NU-Formula-Racing/BMS-Deprecated-2023/Firmware/PlatformIO/main_mcu/README.md

Link to state machine flow chart: https://lucid.app/lucidchart/a4bc1315-41cd-4296-962c-10b4b0074c76/edit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
