NU-Formula-Racing/BMS-Deprecated-2023/Hardware/QFP50P1200X1200X120-64N_JEDEC_MS-026ACD.STEP

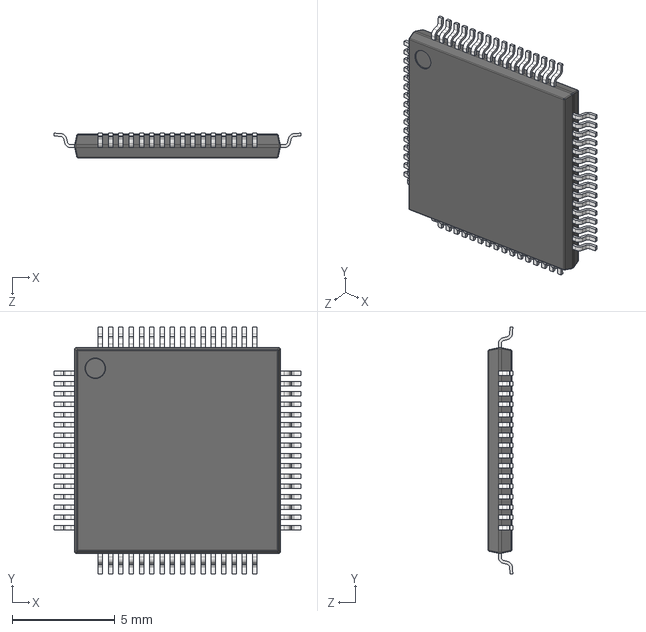
[picture p1: CAD file, 2022-01-15]
Hardware/QFP50P1200X1200X120-64N_JEDEC_MS-026ACD.STEP
12.0 x 12.0 x 1.20 mm
