NU-Formula-Racing/BMS-Deprecated-2023/Hardware/Main controller 79656/esp_teensy_bridge_v3_layouyt.pdf

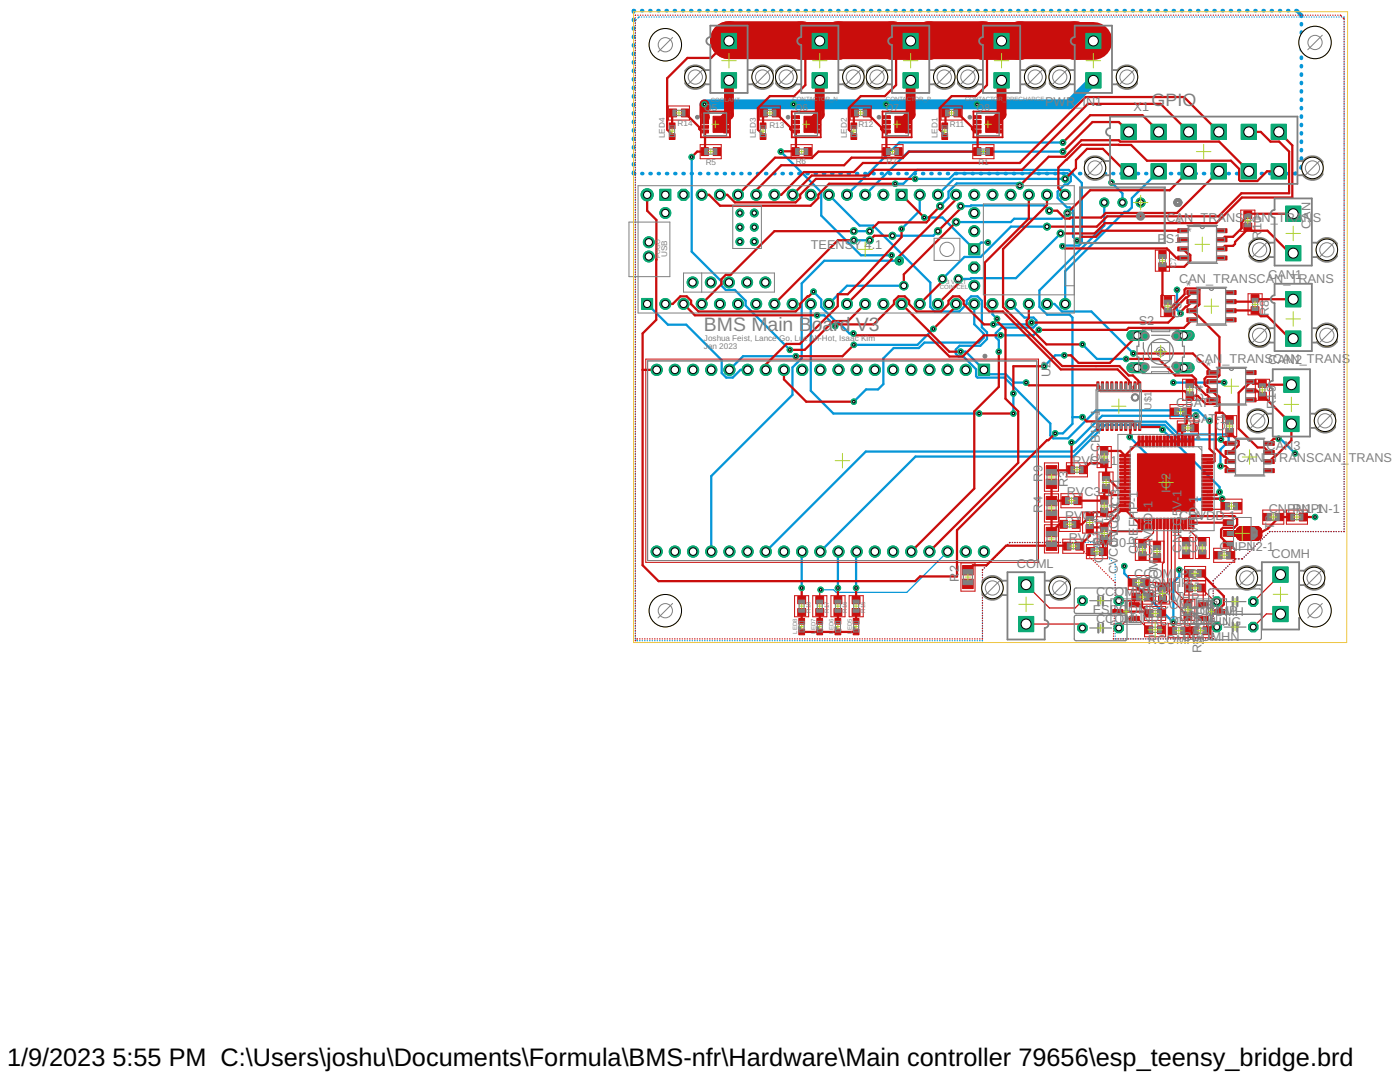
[picture p2: page 1]

3 VOLT COIN CEL POGO

Joshua Feist, Lance Go, Luc Ah-Hot, Isaac Kim
Jan 2023

CREFHP-1 CAVDD-1 CNEG5V-1 CCVDD-1 C VDD-1 CNPN2-1CNPRNN1P-1N-1 T2 RCOMH

1/9/2023 5:55 PM C:\Users\joshu\Documents\Formula\BMS-nfr\Hardware\Main controller 79656\esp_teensy_bridge.brd
