NU-Formula-Racing/BMS-Deprecated-2023/Hardware/Main controller 79656/esp_teensy_bridge_v3_schematic.pdf

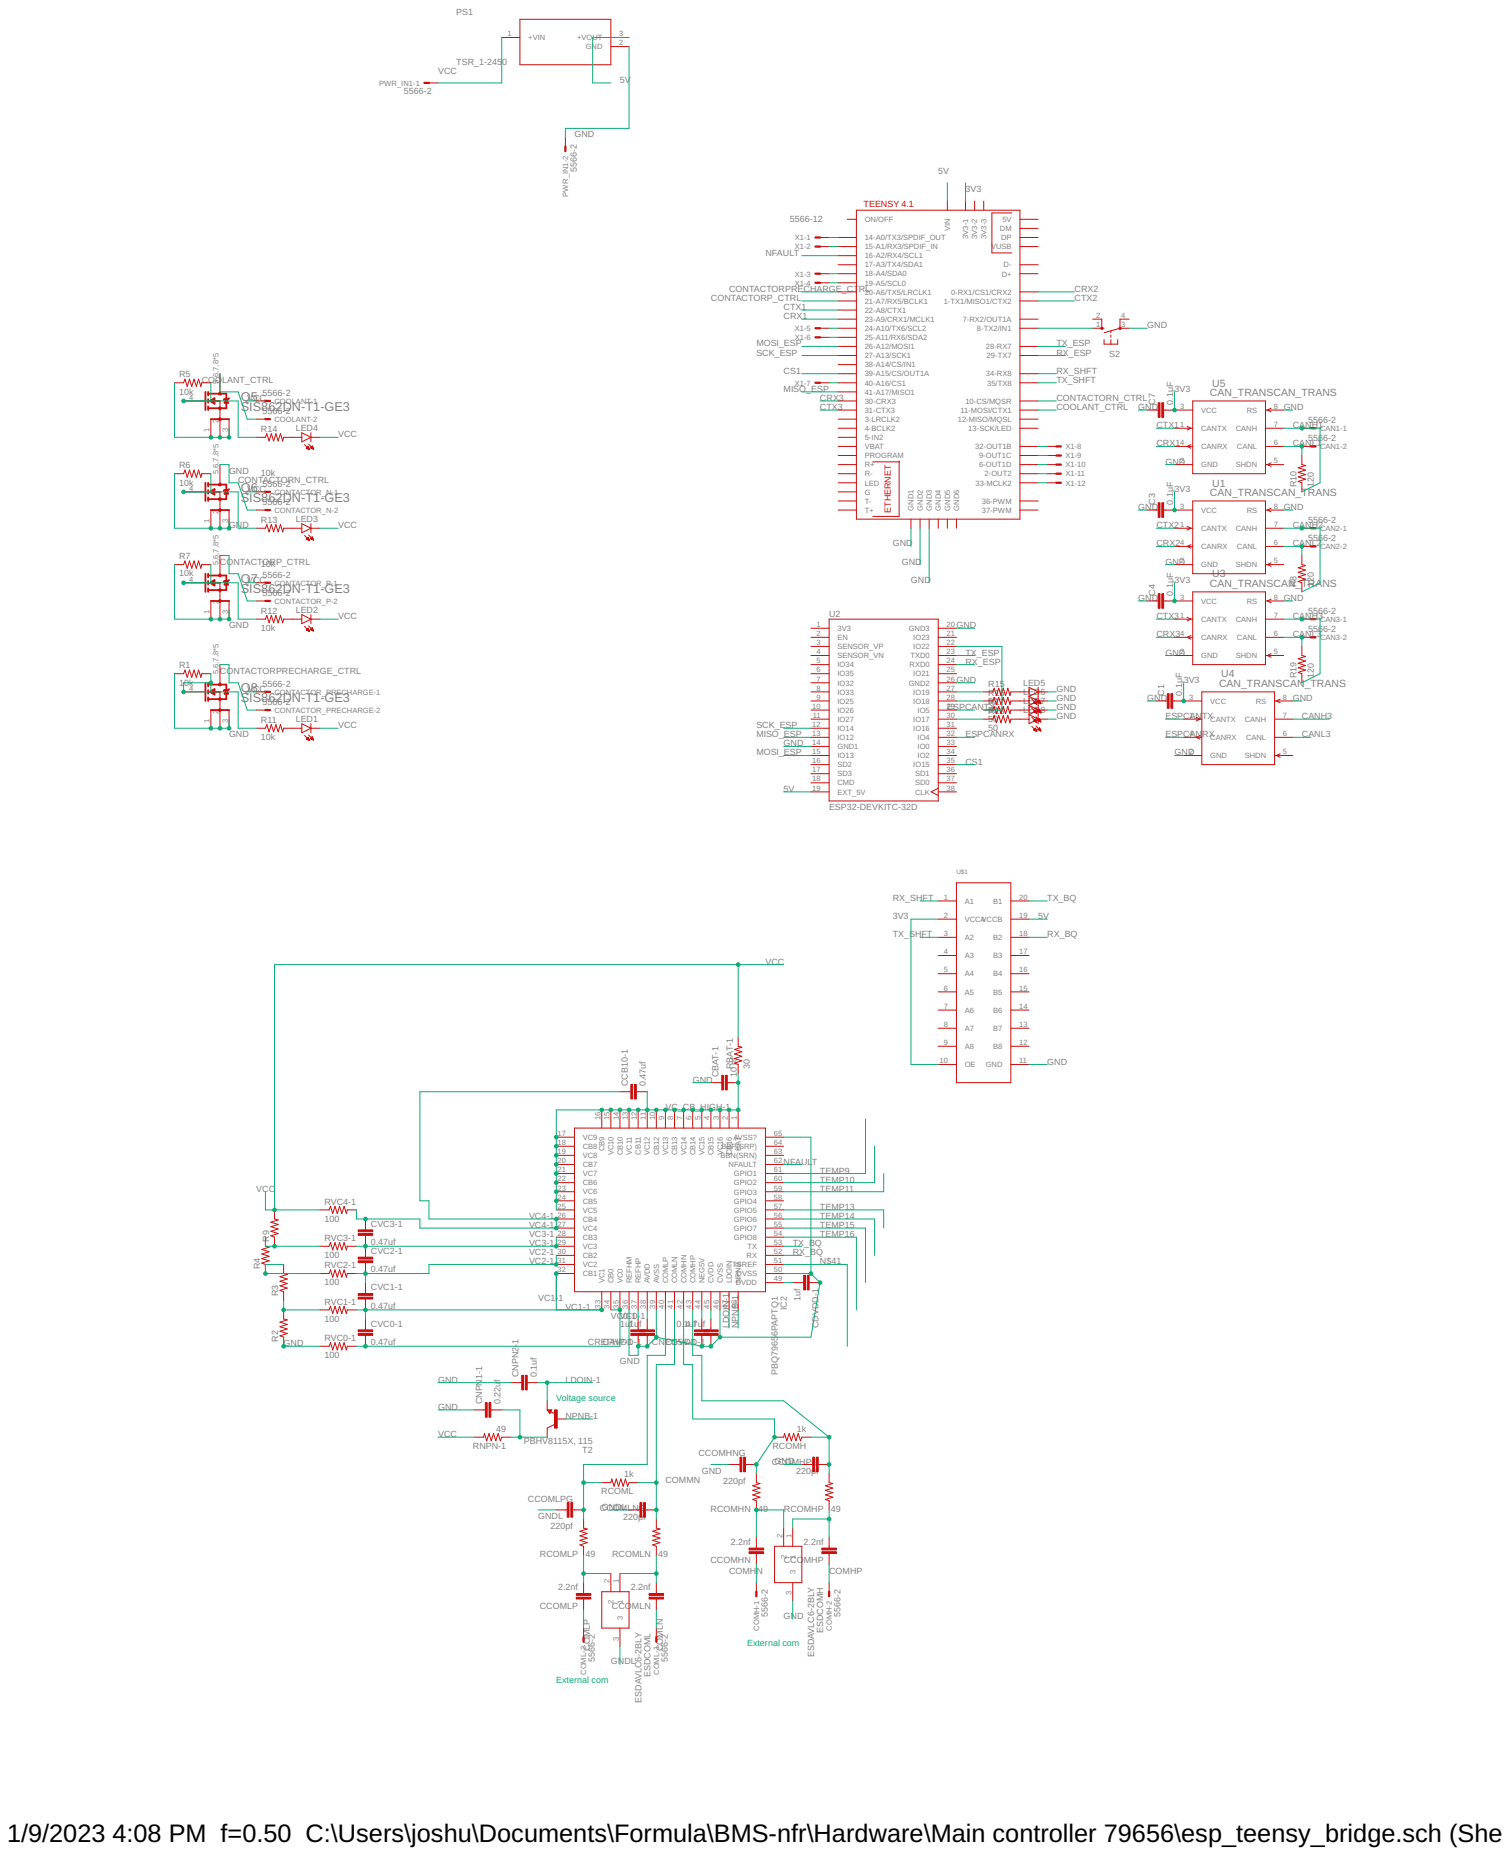
[picture p3: page 1]

GND GND GND GND GND

55 GPIO8 54 TX

1/9/2023 4:08 PM f=0.50 C:\Users\joshu\Documents\Formula\BMS-nfr\Hardware\Main controller 79656\esp_teensy_bridge.sch (Sheet: 1/1)
