NU-Formula-Racing/BMS-Deprecated-2023/Hardware/Segment/daughterboard_layout_v3.pdf

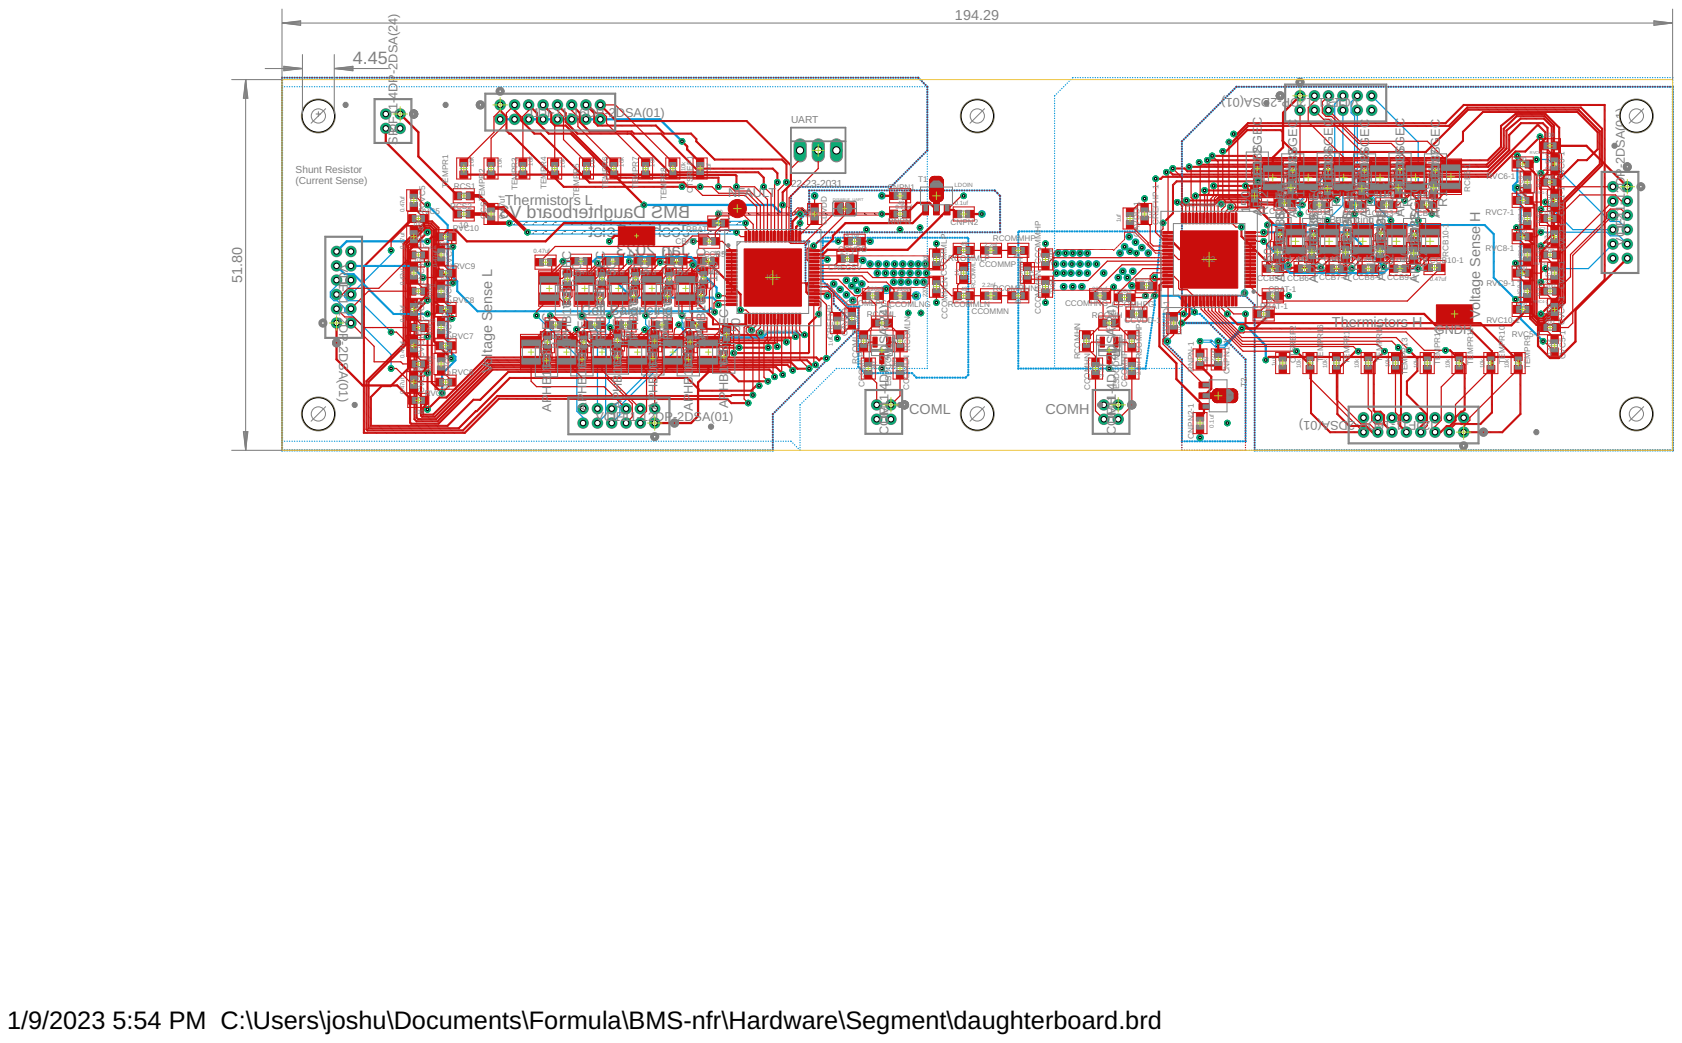
[picture p4: page 1]

1/9/2023 5:54 PM C:\Users\joshu\Documents\Formula\BMS-nfr\Hardware\Segment\daughterboard.brd
