NU-Formula-Racing/BMS-Deprecated-2023/Hardware/Segment/daughterboard_schematic_v3.pdf

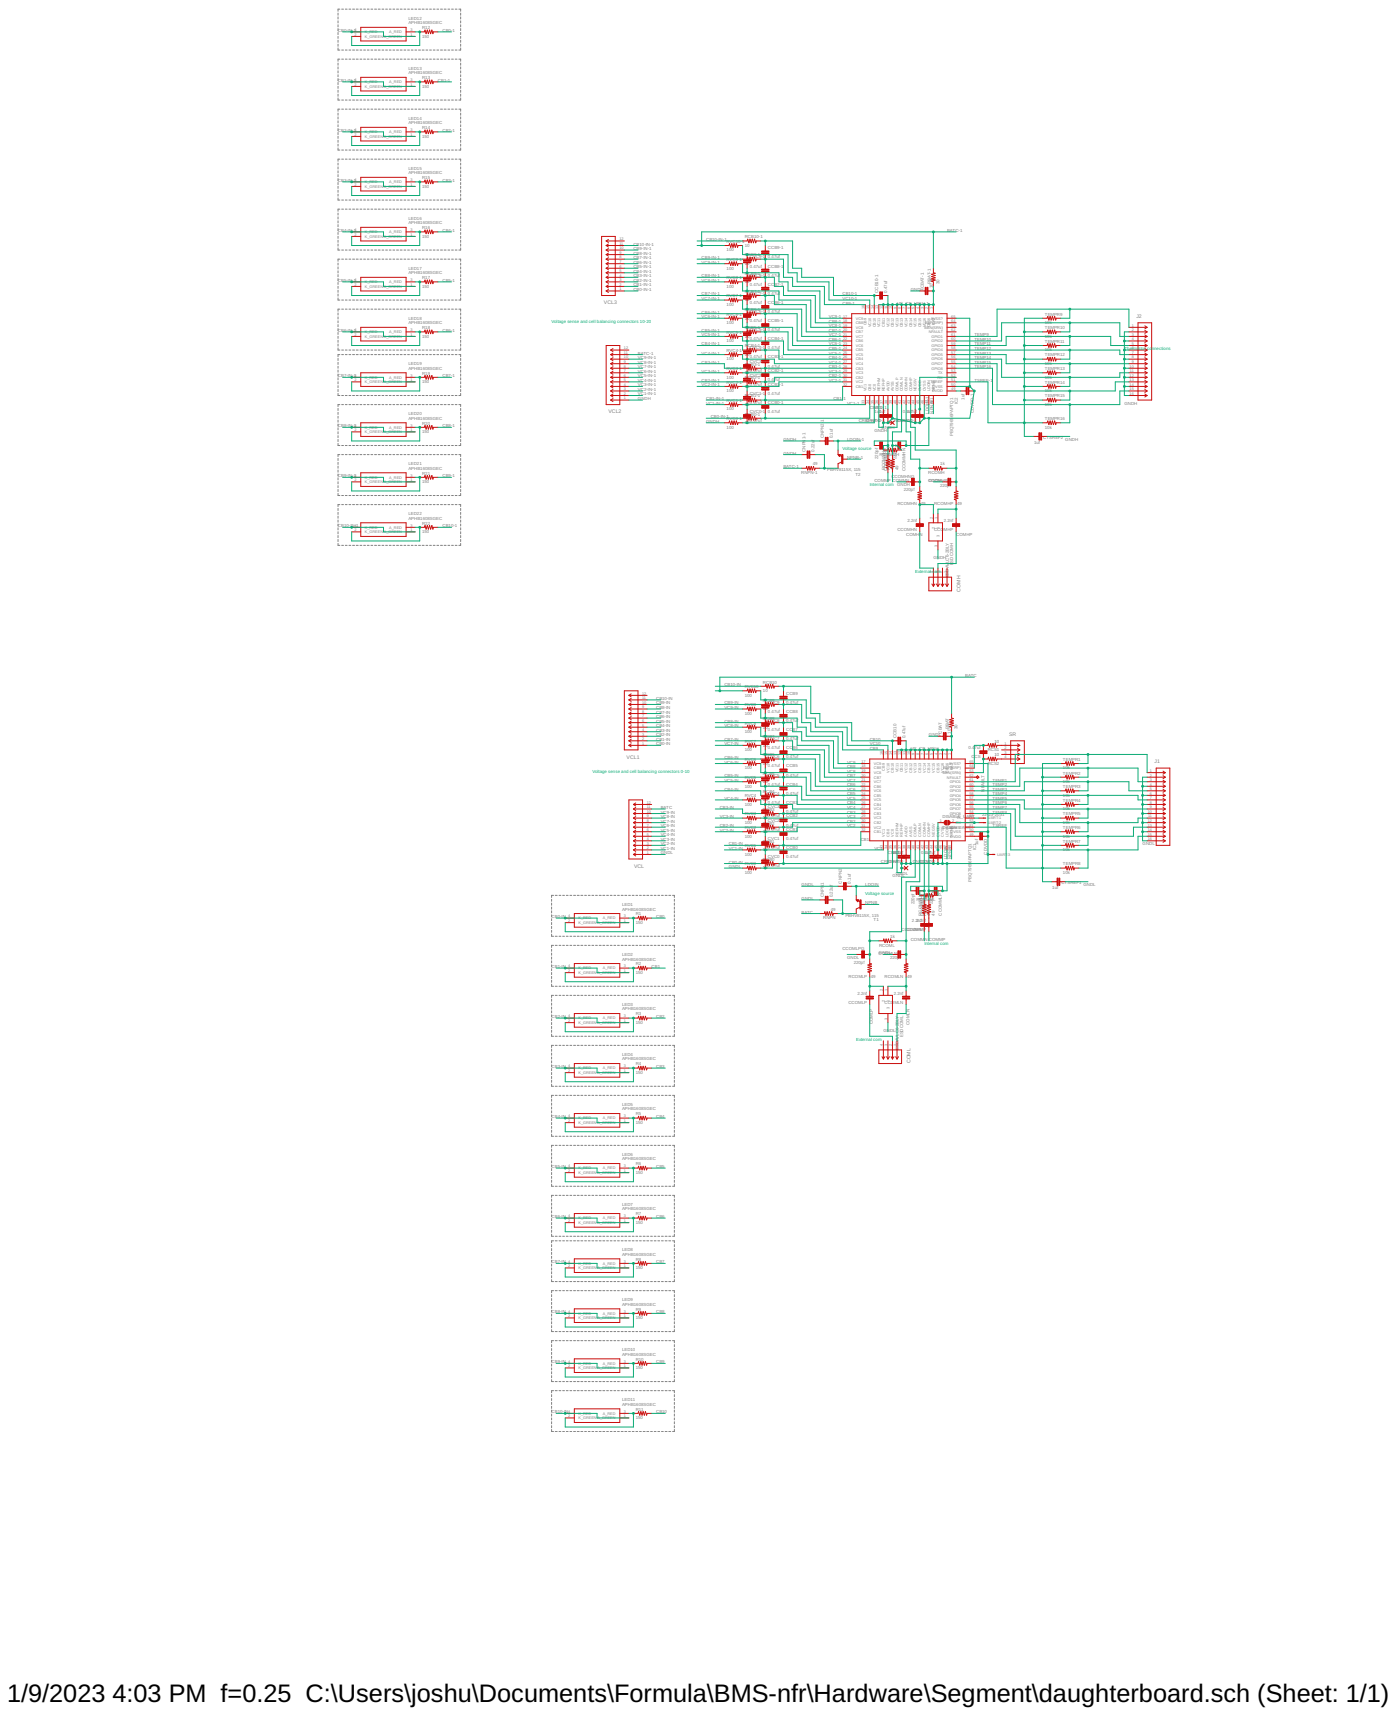
[picture p5: page 1]

Voltage sense and cell balancing connectors 10-20

Voltage sense and cell balancing connectors 0-10

1/9/2023 4:03 PM f=0.25 C:\Users\joshu\Documents\Formula\BMS-nfr\Hardware\Segment\daughterboard.sch (Sheet: 1/1)
