NU-Formula-Racing/BMS-Deprecated-2023/Hardware/Main controller 79600/esp_teensy_bridge_layout-05-2-22.pdf

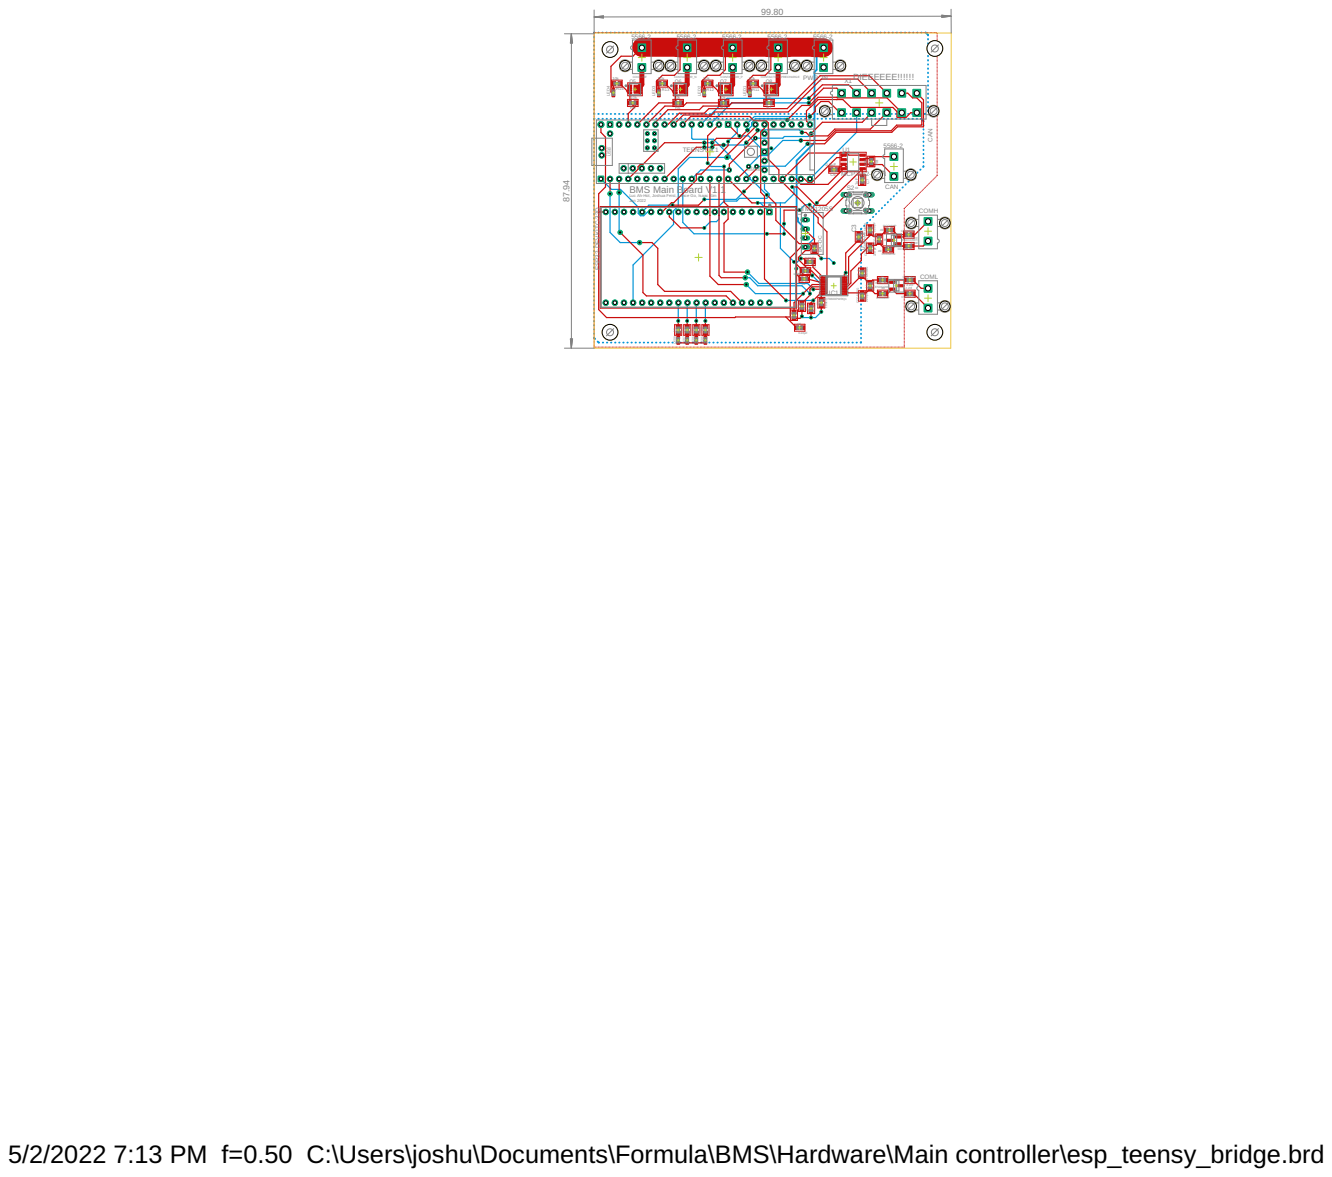
[picture p6: page 1]

3 VOLT COIN CEL POGO

TEENSY | 4.1

TME1205S 100k

5/2/2022 7:13 PM f=0.50 C:\Users\joshu\Documents\Formula\BMS\Hardware\Main controller\esp_teensy_bridge.brd
