NU-Formula-Racing/BMS-Deprecated-2023/Hardware/Segment/daughterboard-layout-4-20-22.pdf

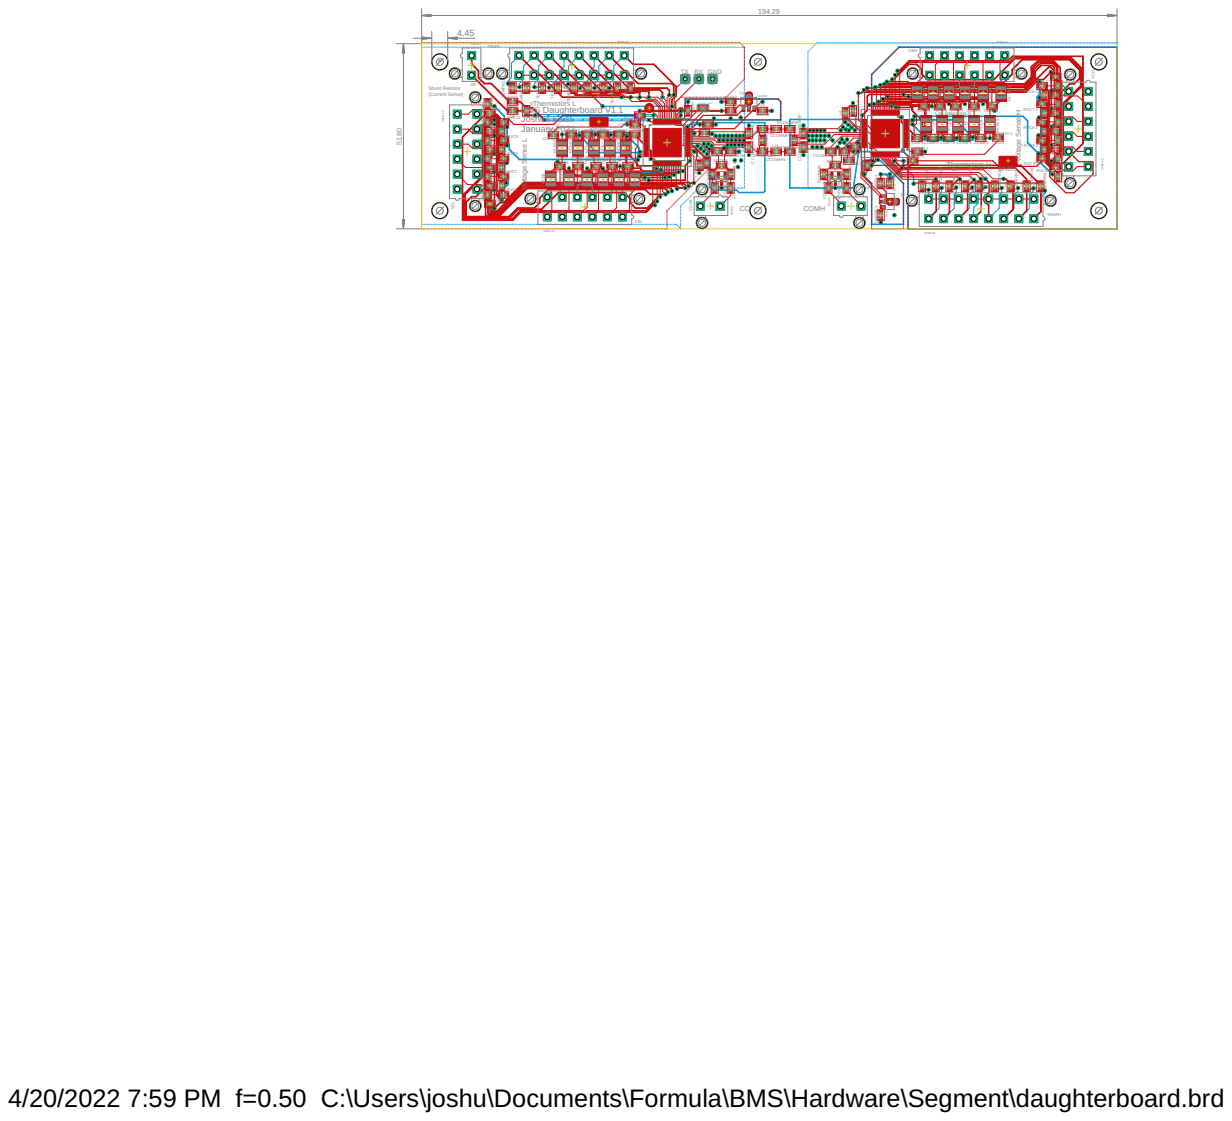
[picture p7: page 1]

Voltage Sense L Cell Balancing L

4/20/2022 7:59 PM f=0.50 C:\Users\joshu\Documents\Formula\BMS\Hardware\Segment\daughterboard.brd
