NU-Formula-Racing/BMS-Deprecated-2023/Hardware/Segment/daughterboard_4-20-22.pdf

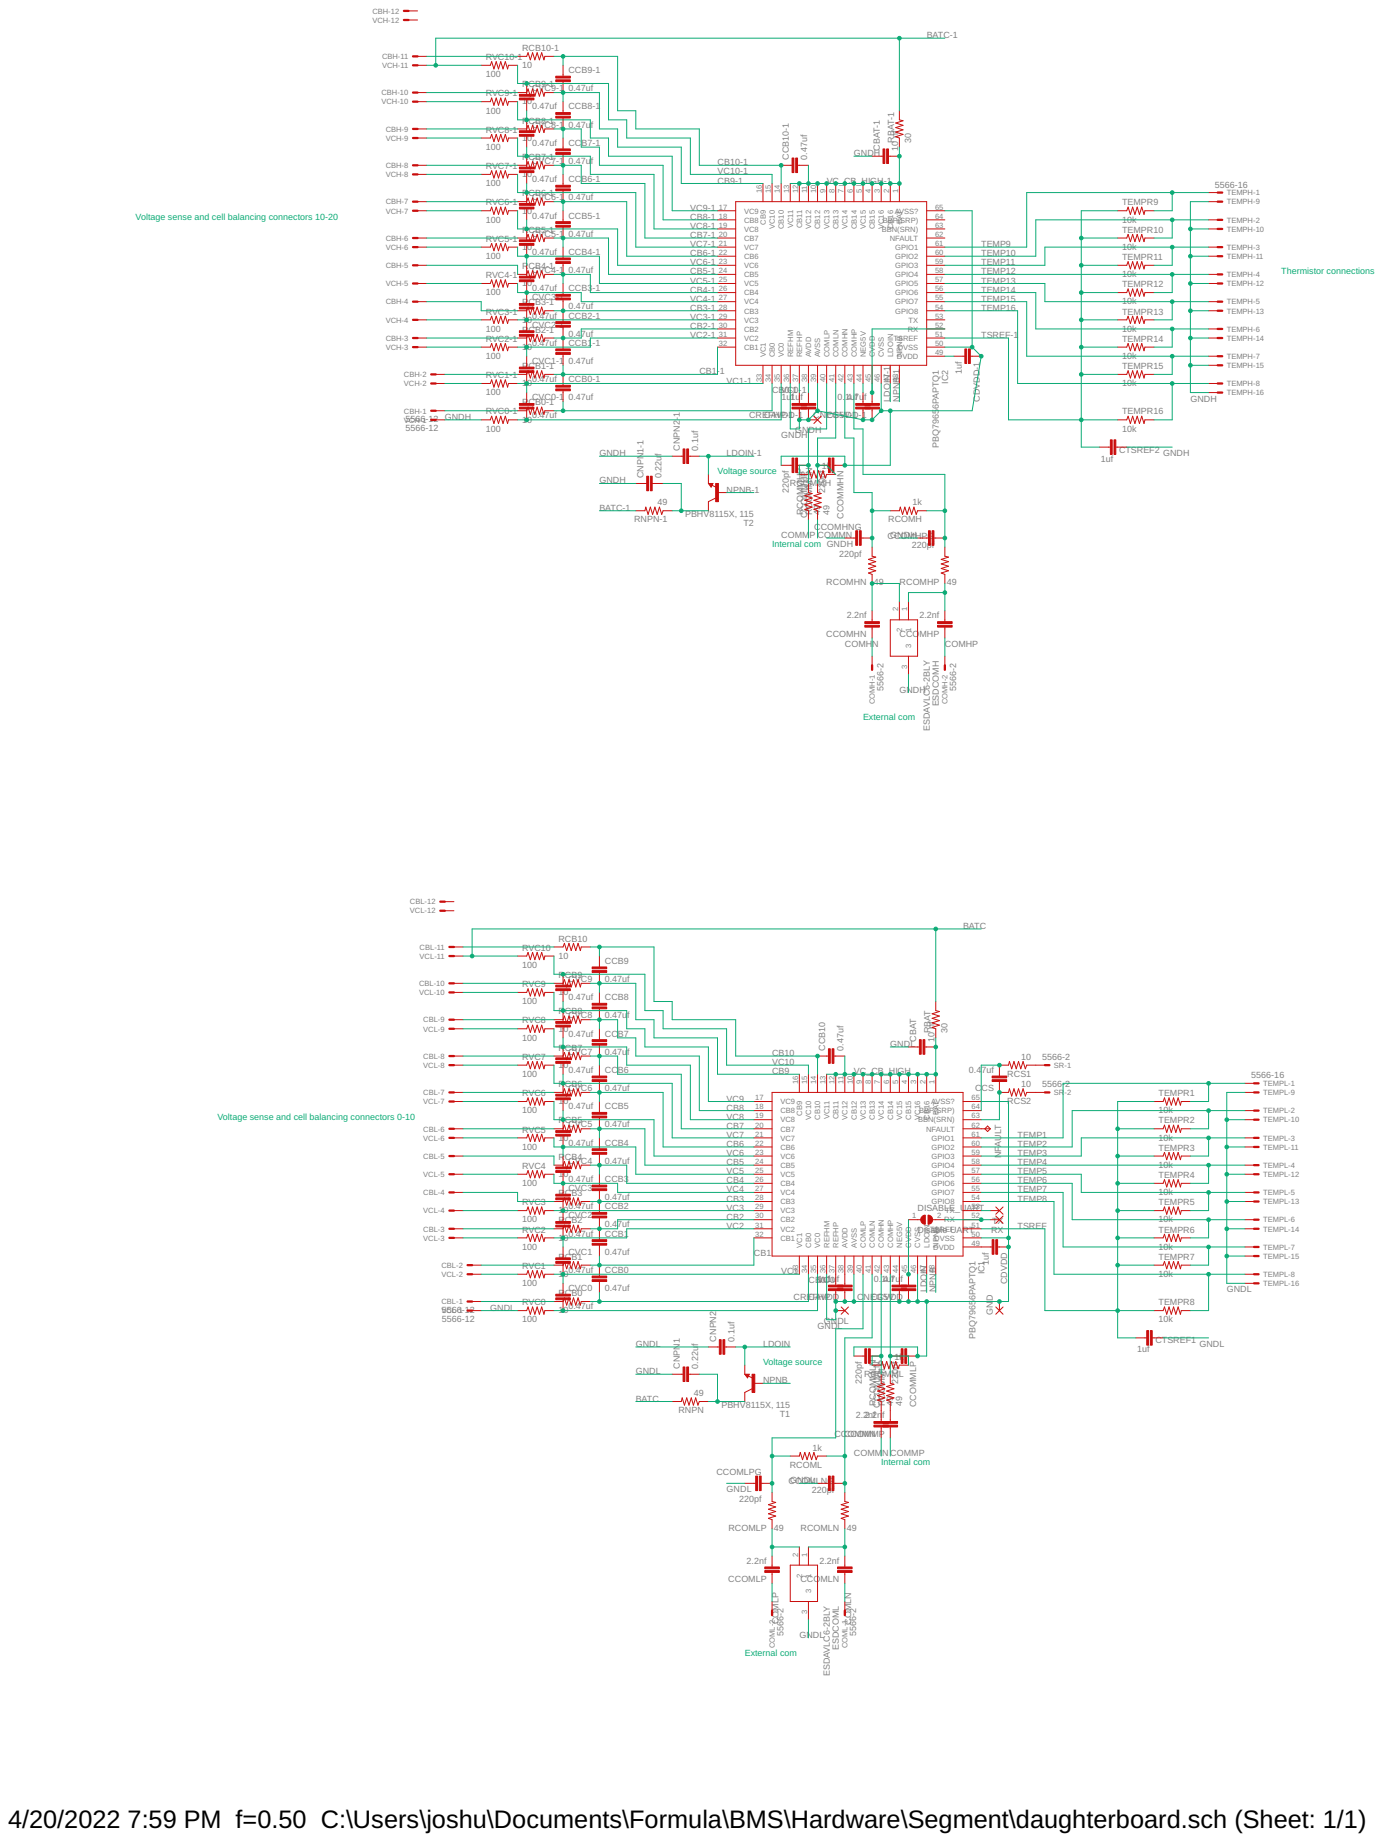
[picture p8: page 1]

CBH-12
VCH-12
VCH-1 VCH-2 VCH-3 VCH-4 VCH-5 VCH-6 VCH-7 VCH-8 VCH-9 VCH-10 VCH-11

TEMPH-1 TEMPH-2 TEMPH-3 TEMPH-4 TEMPH-5 TEMPH-6 TEMPH-7 TEMPH-8
TEMPR15 TEMPR14 TEMPR13 TEMPR12 TEMPR11 TEMPR10 TEMPR9

Voltage sense and cell balancing connectors 10-20

TEMPH-9 TEMPH-10 TEMPH-11 TEMPH-12 TEMPH-13 TEMPH-14 TEMPH-15 TEMPH-16 TEMPR16 CTSREF2

56 GPIO7 55 GPIO8

CBL-12
VCL-12
VCL-1 VCL-2 VCL-3 VCL-4 VCL-5 VCL-6 VCL-7 VCL-8 VCL-9 VCL-10 VCL-11

TEMPL-1 TEMPL-2 TEMPL-3 TEMPL-4 TEMPL-5 TEMPL-6 TEMPL-7 TEMPL-8

TEMPL-9 TEMPL-10 TEMPL-11 TEMPL-12 TEMPL-13 TEMPL-14 TEMPL-15 TEMPL-16 TEMPR8 CTSREF1

Voltage sense and cell balancing connectors 0-10

4/20/2022 7:59 PM f=0.50 C:\Users\joshu\Documents\Formula\BMS\Hardware\Segment\daughterboard.sch (Sheet: 1/1)
