NU-Formula-Racing/BMS-Deprecated-2023/Hardware/Dummy Battery/dummy_battery_brd_1.0.pdf

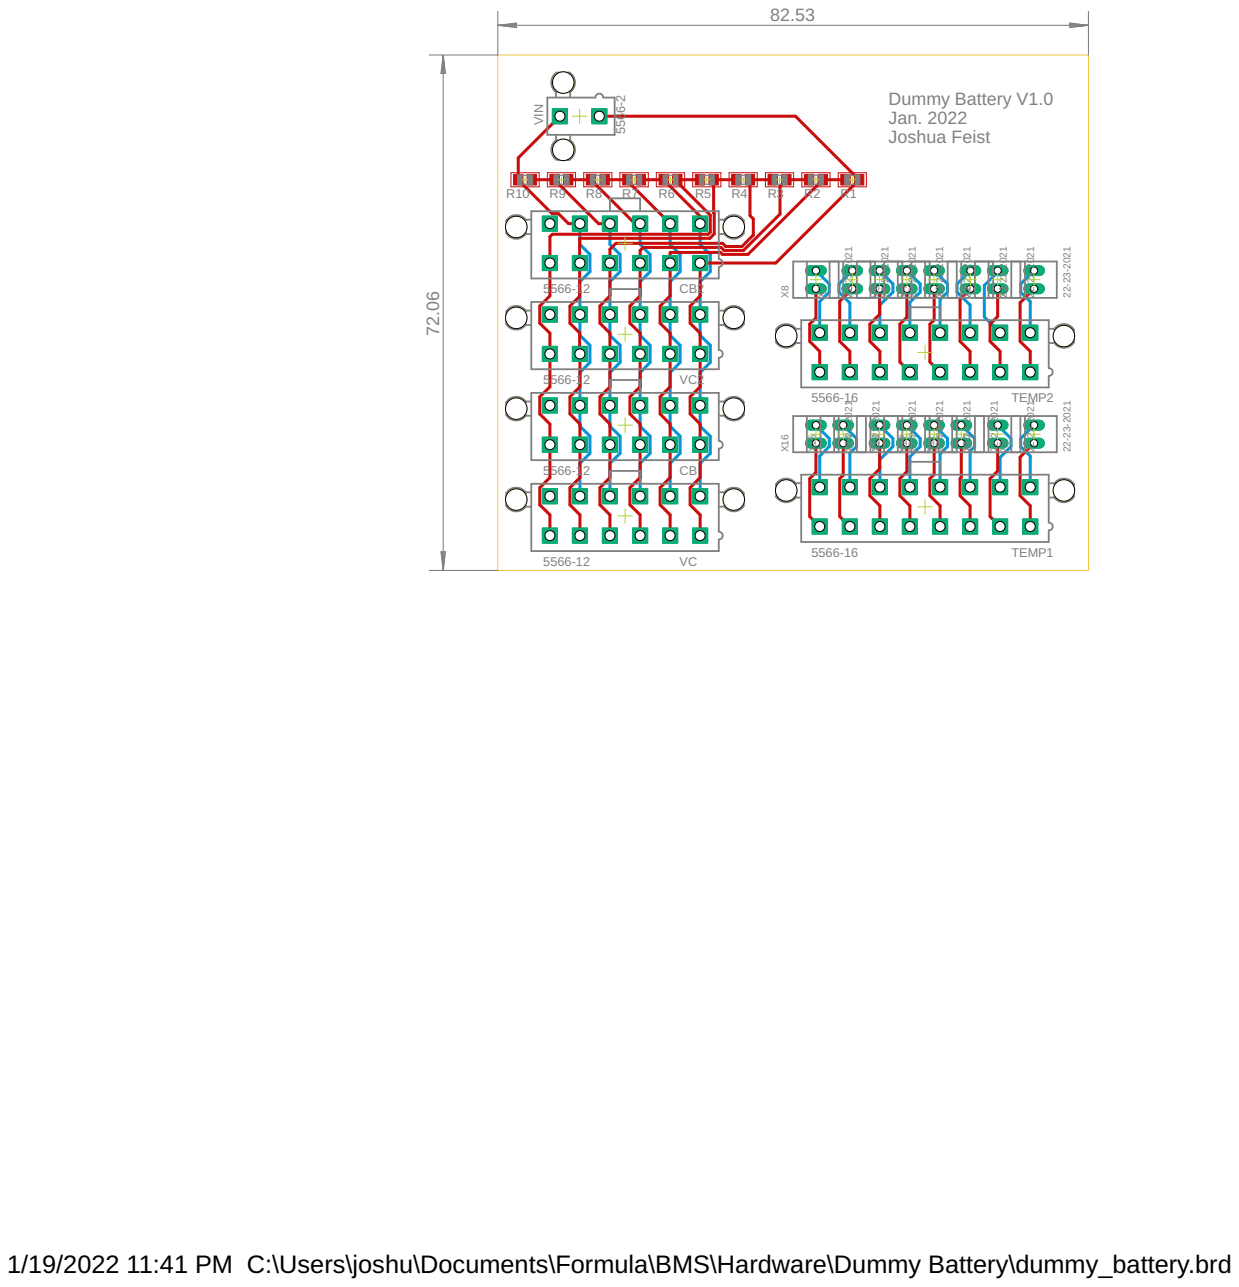
[picture p9: page 1]

1/19/2022 11:41 PM C:\Users\joshu\Documents\Formula\BMS\Hardware\Dummy Battery\dummy_battery.brd
