NU-Formula-Racing/BMS-Deprecated-2023/Hardware/Dummy Battery/dummy_battery_sch_1.0.pdf

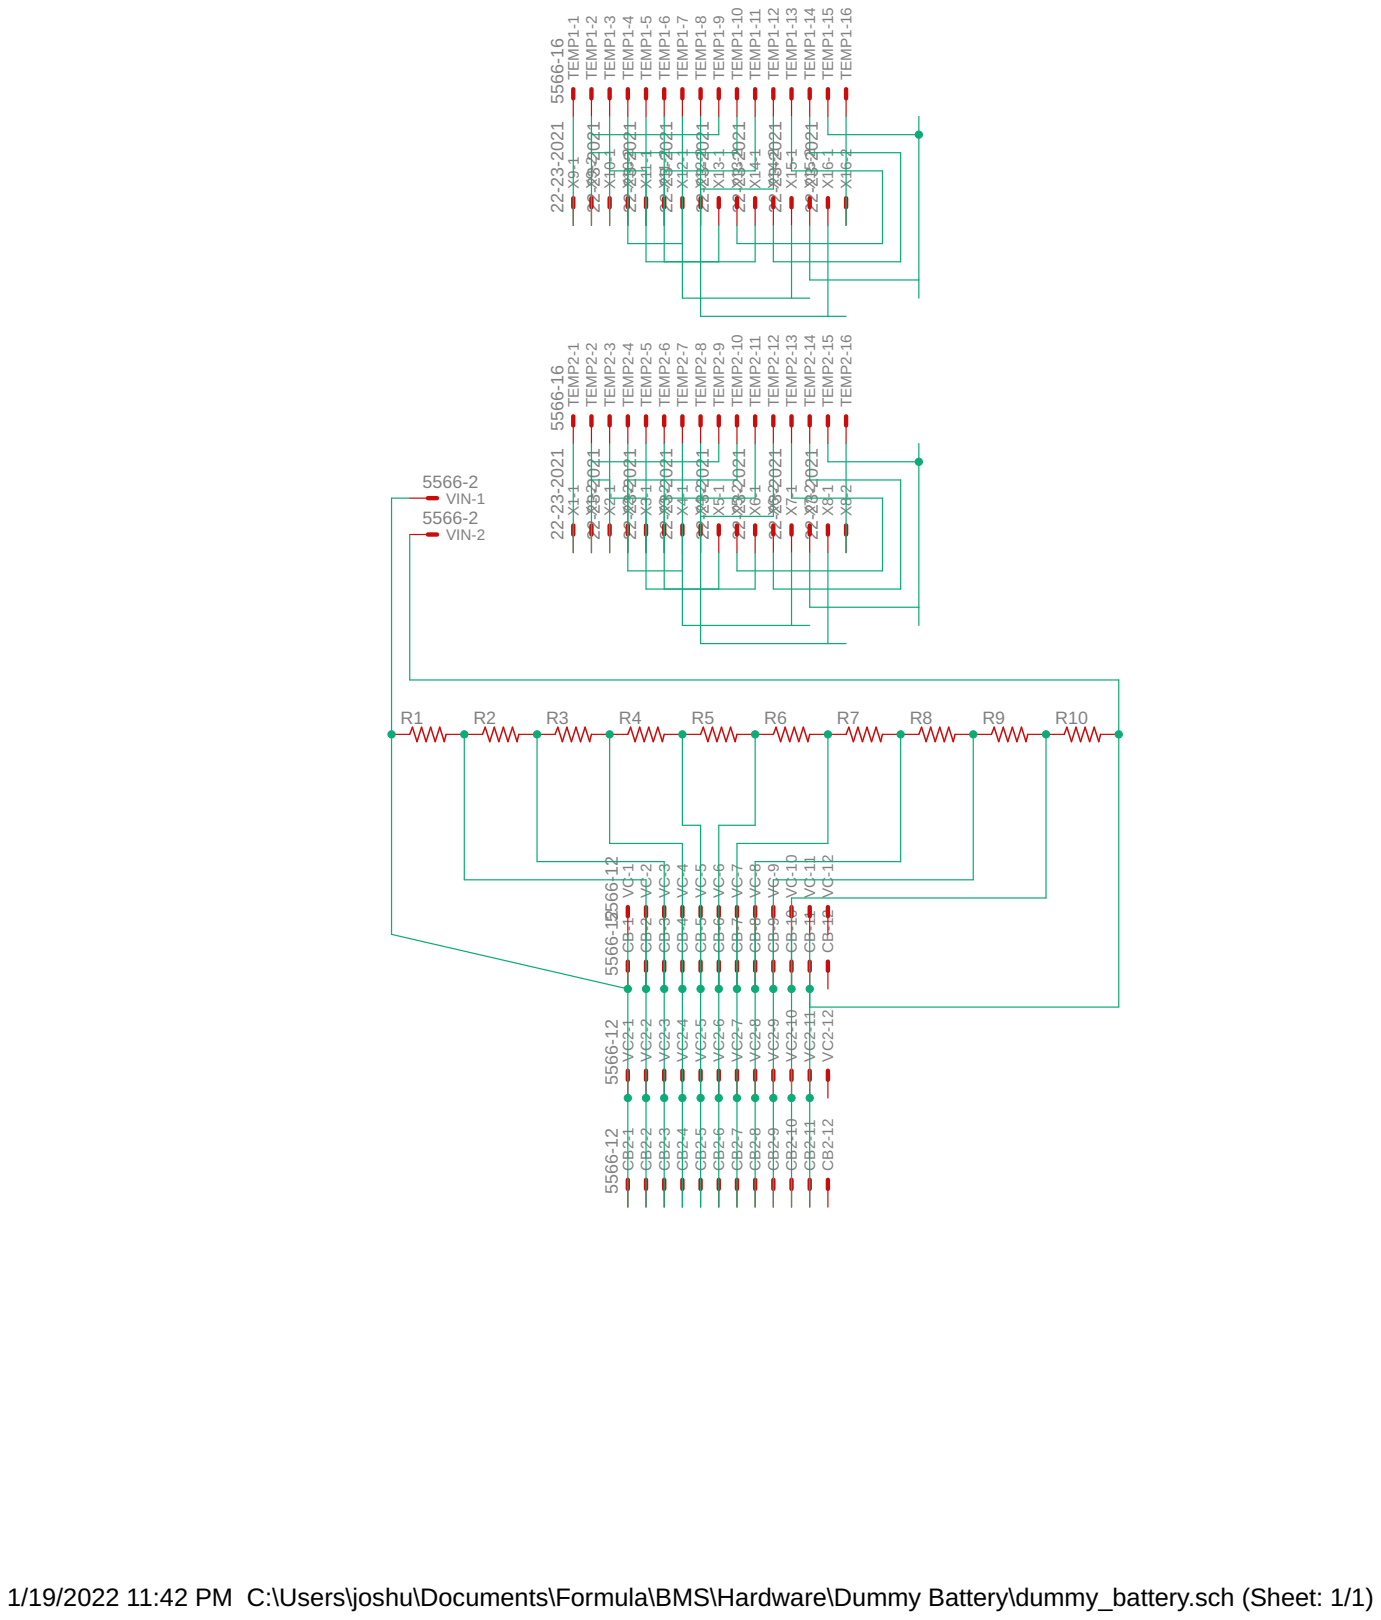
[picture p10: page 1]

1/19/2022 11:42 PM C:\Users\joshu\Documents\Formula\BMS\Hardware\Dummy Battery\dummy_battery.sch (Sheet: 1/1)
