NU-Formula-Racing/BMS-Deprecated-2023/Hardware/Main controller 79600/esp_teensy_bridge_brd_1.0.pdf

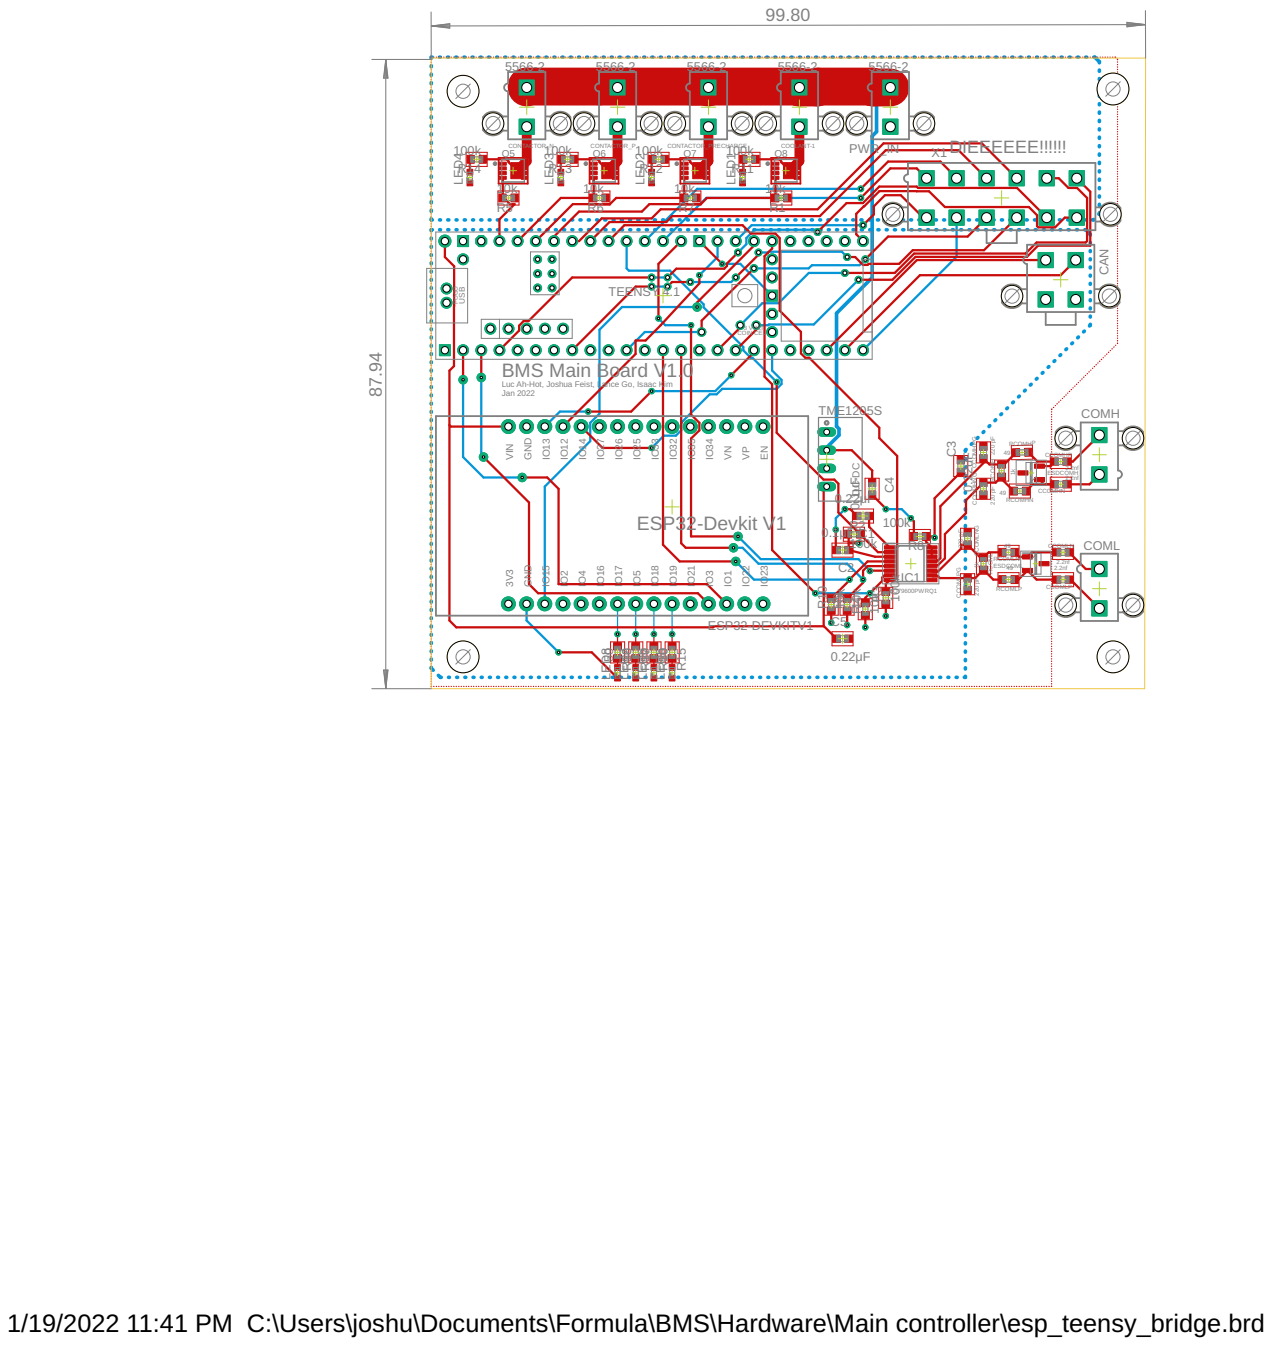
[picture p11: page 1]

3 VOLT COIN CEL POGO

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
