NU-Formula-Racing/BMS-Deprecated-2023/Hardware/Main controller 79600/esp_teensy_bridge_sch_1.0.pdf

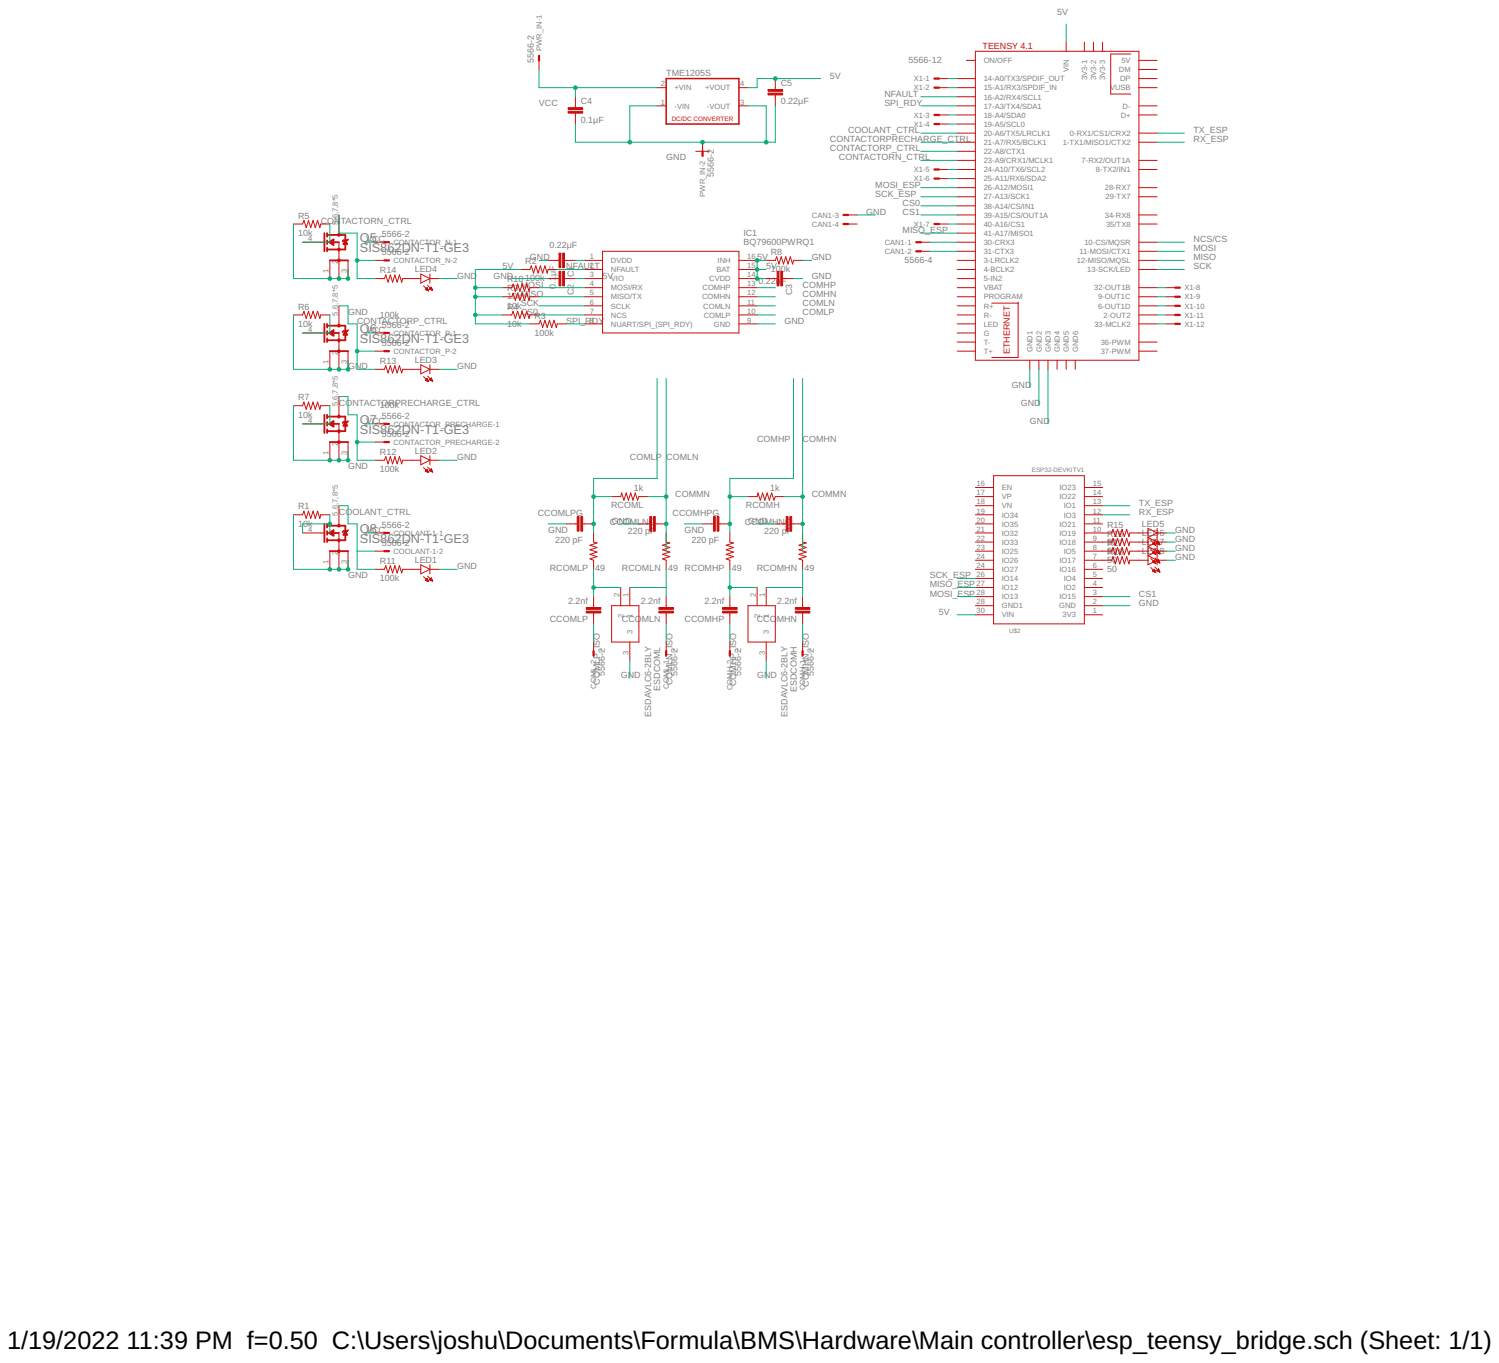
[picture p12: page 1]

GND GND

1/19/2022 11:39 PM f=0.50 C:\Users\joshu\Documents\Formula\BMS\Hardware\Main controller\esp_teensy_bridge.sch (Sheet: 1/1)
