NU-Formula-Racing/BMS-Deprecated-2023/Hardware/Segment/daughterboard_brd_1.1.pdf

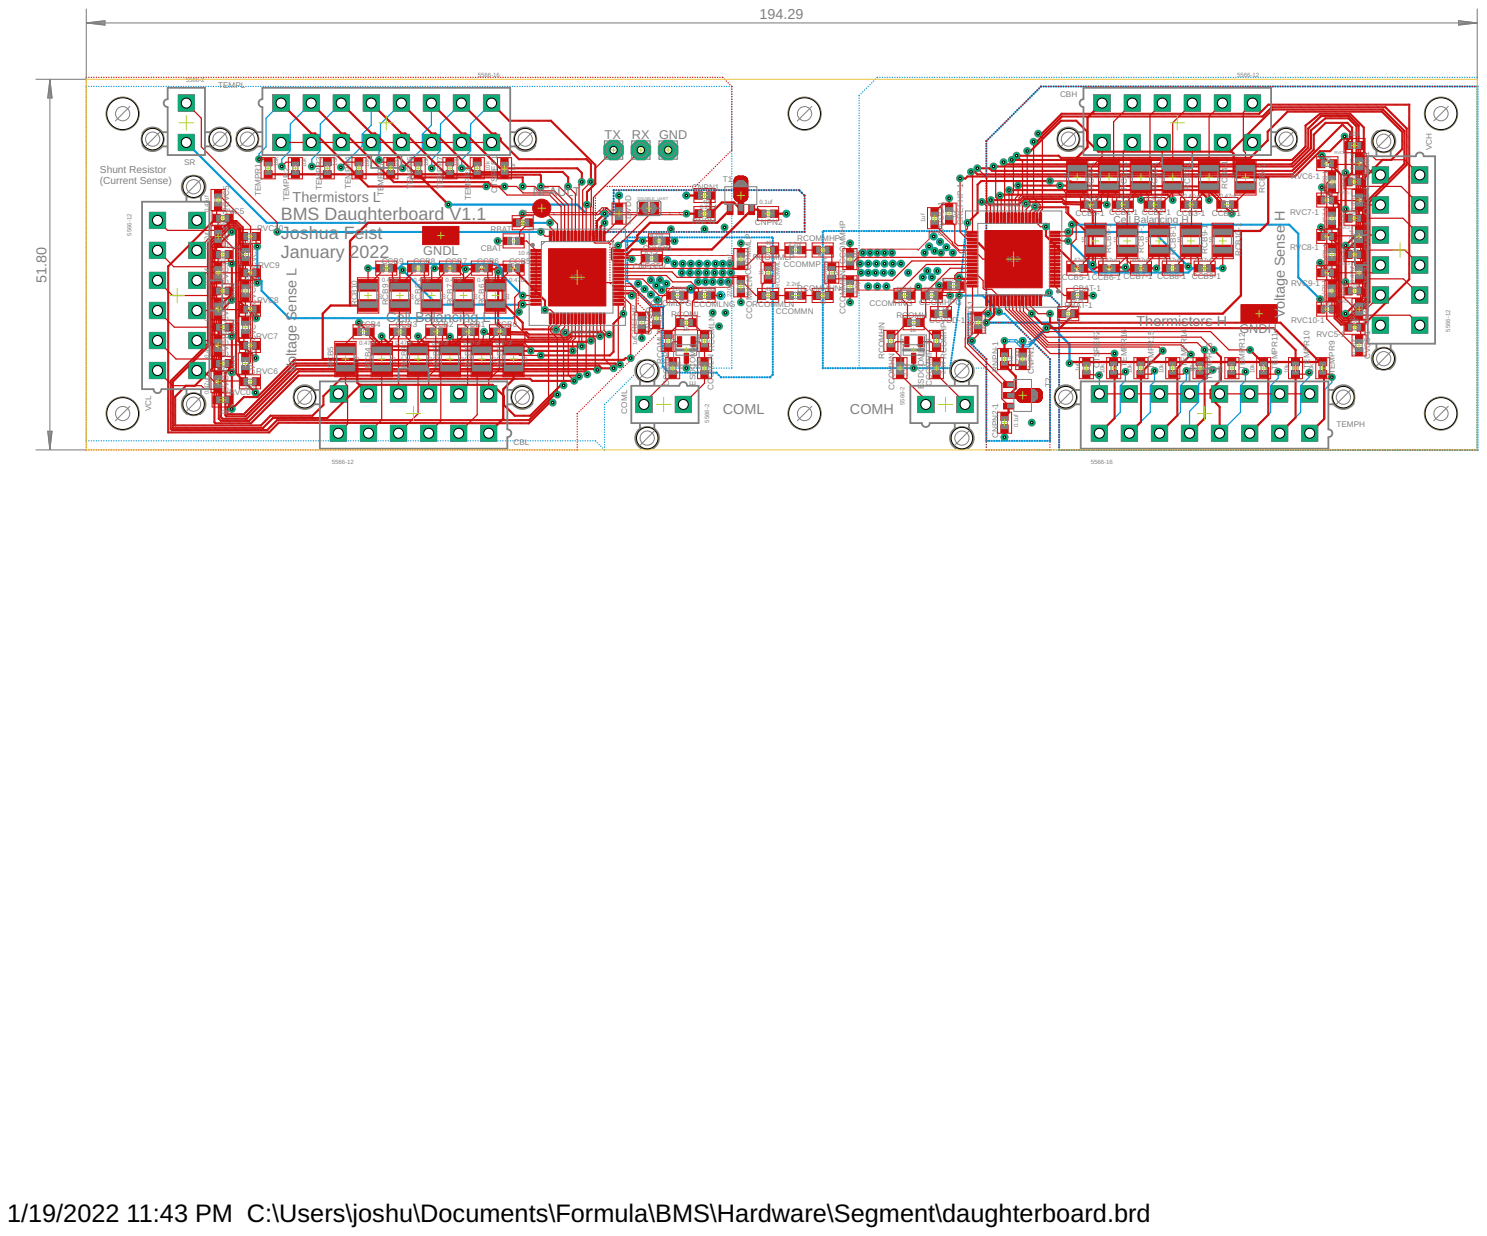
[picture p13: page 1]

Voltage Sense L Cell Balancing L

1/19/2022 11:43 PM C:\Users\joshu\Documents\Formula\BMS\Hardware\Segment\daughterboard.brd
