NU-Formula-Racing/BMS-Deprecated-2023/Hardware/Segment/daughterboard.pdf

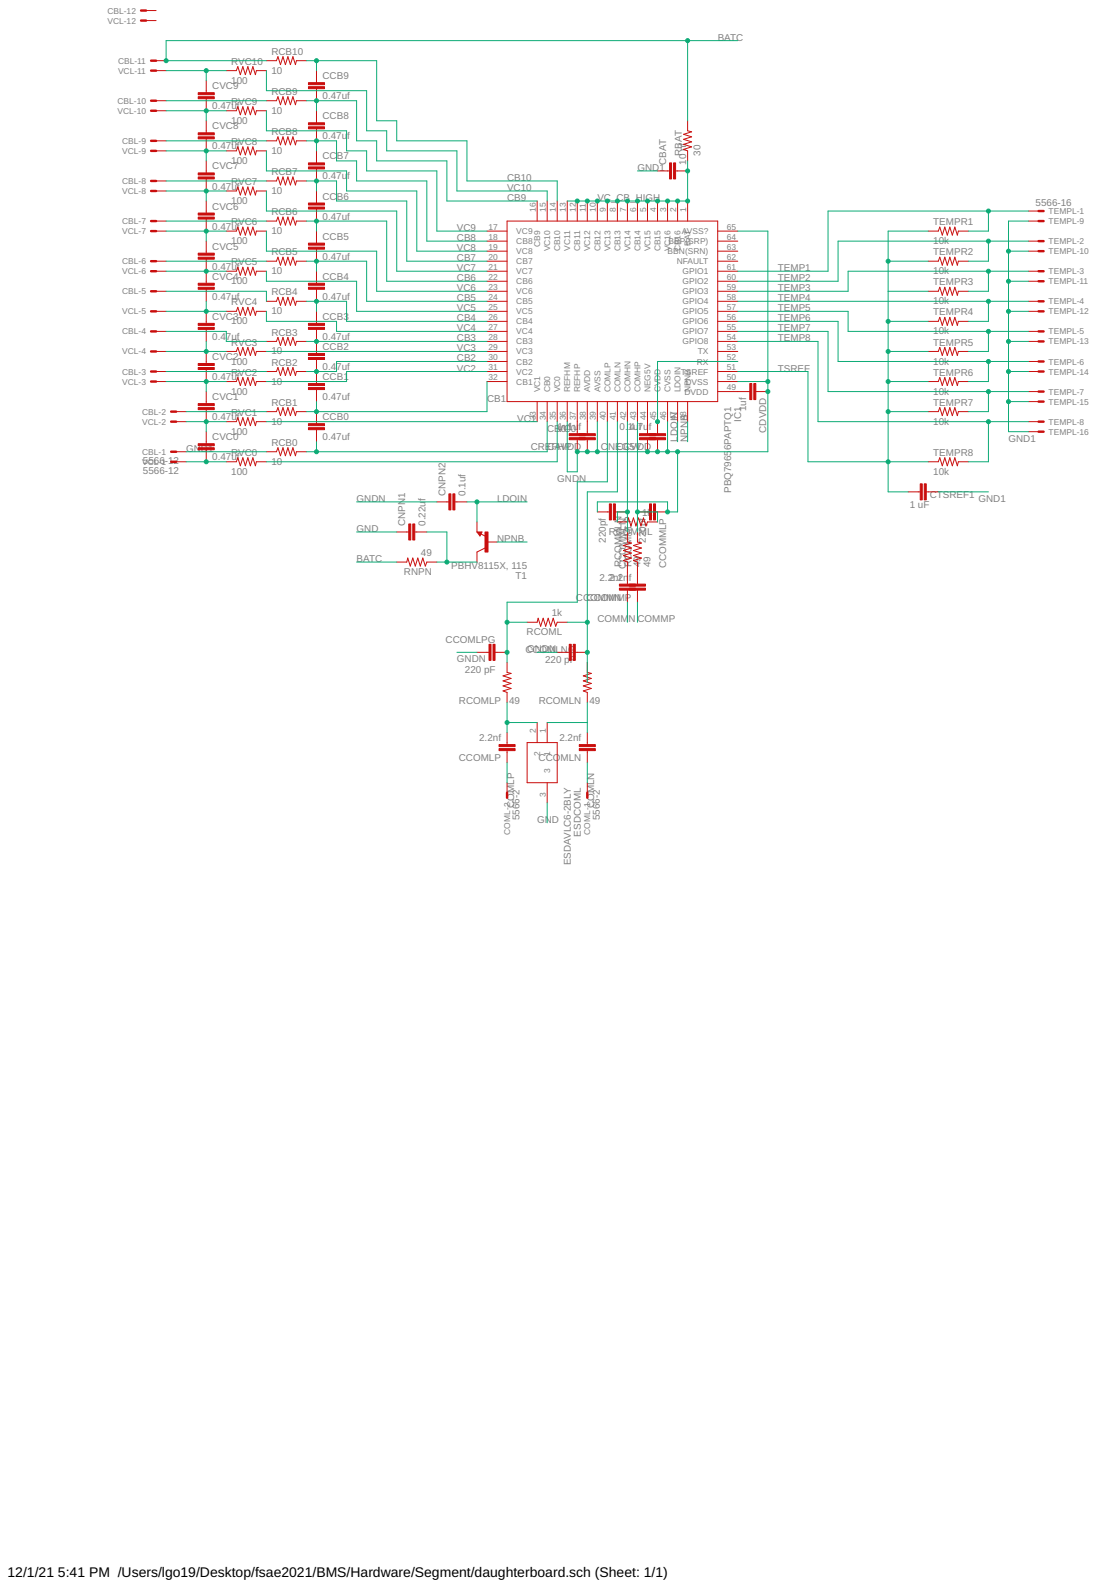
[picture p14: page 1]

CCB0 CBL-1 CBL-2 CBL-3 CBL-4 CBL-5 CBL-6 CBL-7 CBL-8 CBL-9 CBL-10 CBL-11 CBL-12
VCL-12
VCL-1 VCL-2 VCL-3 VCL-4 VCL-5 VCL-6 VCL-7 VCL-8 VCL-9 VCL-10 VCL-11

TEMPL-1 TEMPL-2 TEMPL-3 TEMPL-4 TEMPL-5 TEMPL-6 TEMPL-7 TEMPL-8

53 RX 52 TSREF 51 DVSS | TSREF

50 DVDD

12/1/21 5:41 PM /Users/lgo19/Desktop/fsae2021/BMS/Hardware/Segment/daughterboard.sch (Sheet: 1/1)

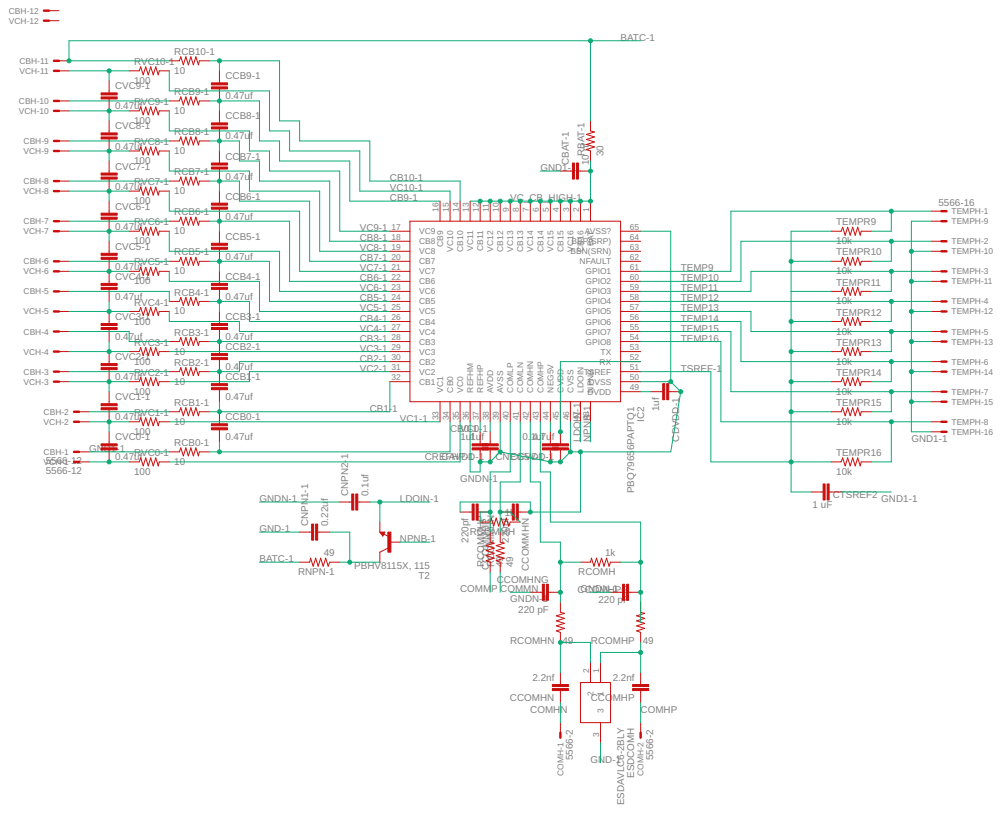
[picture p15: page 2]

CCB0-1 CBH-1 CBH-2 CBH-3 CBH-4 CBH-5 CBH-6 CBH-7 CBH-8 CBH-9 CBH-10 CBH-11 CBH-12
VCH-12
VCH-1 VCH-2 VCH-3 VCH-4 VCH-5 VCH-6 VCH-7 VCH-8 VCH-9 VCH-10 VCH-11

TEMPH-1 TEMPH-2 TEMPH-3 TEMPH-4 TEMPH-5 TEMPH-6 TEMPH-7 TEMPH-8
