NU-Formula-Racing/BMS-Deprecated-2023/Hardware/Main controller 79656/esp_teensy_bridge.brd

## EAGLE design Hardware/Main controller 79656/esp_teensy_bridge.brd (2023-06-13)

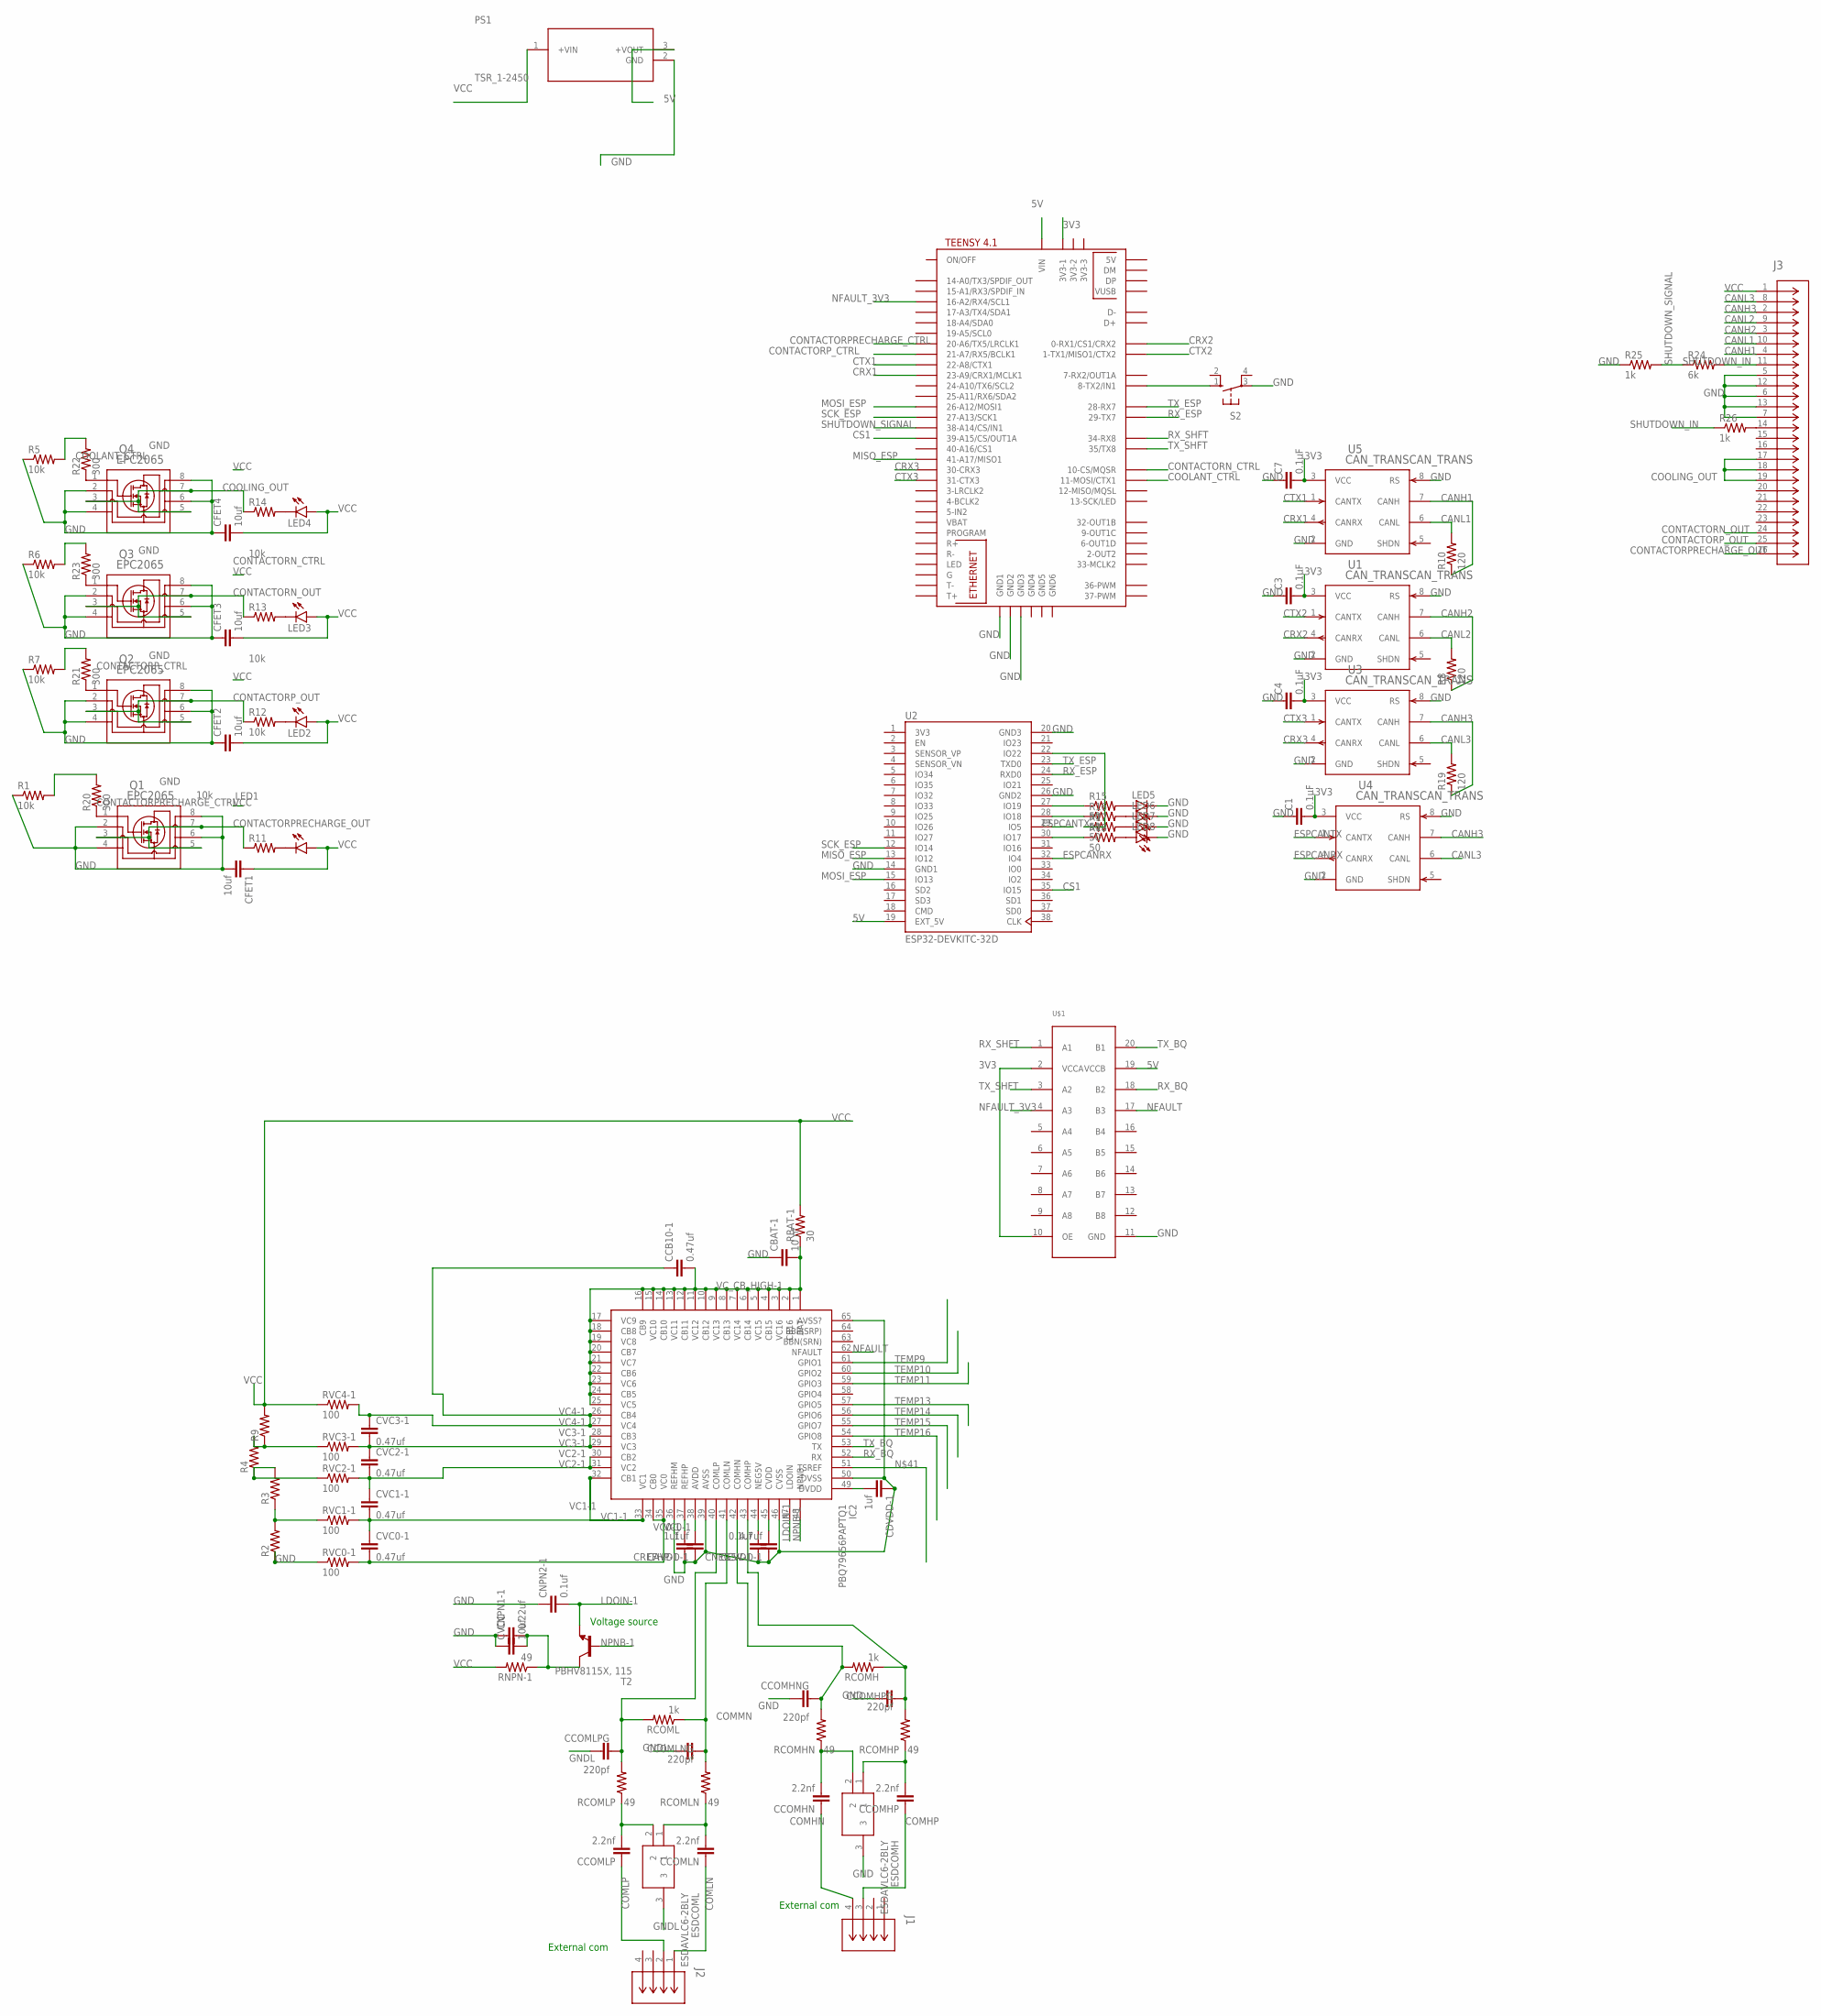
[picture p16: schematic esp_teensy_bridge.sch]

Parts:
C1, C3, C4, C7: 0.1μF; C0603
CAVDD-1: 1uf; C0603
CBAT-1: 10 nf; C0603
CCB10-1: 0.47uf; C0603
CCOMHN: 2.2nf; C075-032X103
CCOMHNG: 220pf; C0603
CCOMHP: 2.2nf; C075-032X103
CCOMHPG: 220pf; C0603
CCOMLN: 2.2nf; C075-032X103
CCOMLNG: 220pf; C0603
CCOMLP: 2.2nf; C075-032X103
CCOMLPG: 220pf; C0603
CCVDD-1: 4.7uf; C0603
CDVDD-1: 1uf; C0603
CFET1, CFET2, CFET3, CFET4: 10uf; C0805
CNEG5V-1: 0.1uf; C0603
CNPN1-1: 0.22uf; C0603
CNPN2-1: 0.1uf; C0603
CREFHP-1: 1uf; C0603
CVC0-1, CVC1-1, CVC2-1, CVC3-1: 0.47uf; C0603
CVCC: 10uf; C0805
ESDCOMH: ESDAVLC6-2BLY; SOT95P255X150-3N
ESDCOML: ESDAVLC6-2BLY; SOT95P255X150-3N
IC2: PBQ79656PAPTQ1; QFP50P1200X1200X120-65N
J1, J2: DF11-4DP-2DSA(24); CON4_2X2_UF_DF11_HIR
J3: TE_AMP_SURESEAL_26; CONN26_6473423-1_TEC
LED1, LED2, LED3, LED4, LED5, LED6, LED7, LED8: LEDSML0603; SML0603
PS1: TSR_1-2450; TSR1-SINGLE_TRP
Q1, Q2, Q3, Q4: EPC2065; EPC2065_ECC
R1, R5, R6, R7, R11, R12, R13, R14: 10k; R0603
R2, R3, R4, R9: R-US_R0805; R0805
R8, R10, R19: 120; R0603
R15, R16, R17, R18: 50; R0603
R20, R21, R22, R23: 300; R0603
R24: 6k; R0603
R25, R26: 1k; R0603
RBAT-1: 30; R0603
RCOMH: 1k; R0603
RCOMHN: 49; R0603
RCOMHP: 49; R0603
RCOML: 1k; R0603
RCOMLN: 49; R0603
RCOMLP: 49; R0603
RNPN-1: 49; R0603
RVC0-1, RVC1-1, RVC2-1, RVC3-1, RVC4-1: 100; R0603
S2: 10-XX; B3F-10XX
T2: PBHV8115X, 115; SOT89-BCE
U1, U3, U4, U5: CAN_TRANSCAN_TRANS; MAX3051ESA+
U2: ESP32-DEVKITC-32D; MODULE_ESP32-DEVKITC-32D
U$1: TXB0108PWSMD; TSSOP20
U$3: TEENSY41

Connections:
3V3: C1.2, C3.2, C4.2, C7.2, U1.3 (VCC), U2.1 (3V3), U3.3 (VCC), U4.3 (VCC), U5.3 (VCC), U$1.2 (VCCA), U$1.10 (OE), U$3.3V3-1
5V: PS1.3 (+VOUT), U2.19 (EXT_5V), U$1.19 (VCCB), U$3.VIN
CANH1: J3.4, R10.1, U5.7 (CANH)
CANH2: J3.3, R8.1, U1.7 (CANH)
CANH3: J3.2, R19.1, U3.7 (CANH), U4.7 (CANH)
CANL1: J3.10, R10.2, U5.6 (CANL)
CANL2: J3.9, R8.2, U1.6 (CANL)
CANL3: J3.8, R19.2, U3.6 (CANL), U4.6 (CANL)
COMHN: CCOMHN.1, J1.4
COMHP: CCOMHP.1, J1.3
COMLN: CCOMLN.1, J2.1
COMLP: CCOMLP.1, J2.2
CONTACTORN_CTRL: R6.2, R23.2, U$3.10-CS\MQSR (10-CS/MQSR)
CONTACTORN_OUT: J3.24, Q3.3, Q3.5, Q3.7, R13.1
CONTACTORPRECHARGE_CTRL: R1.2, R20.2, U$3.20-A6/TX5/LRCLK1
CONTACTORPRECHARGE_OUT: J3.26, Q1.3, Q1.5, Q1.7, R11.1
CONTACTORP_CTRL: R7.2, R21.2, U$3.21-A7/RX5/BCLK1
CONTACTORP_OUT: J3.25, Q2.3, Q2.5, Q2.7, R12.1
COOLANT_CTRL: R5.2, R22.2, U$3.11-MOSI/CTX1
COOLING_OUT: J3.17, J3.18, J3.19, Q4.3, Q4.5, Q4.7, R14.1
CRX1: U5.4 (CANRX), U$3.23-A9/CRX1/MCLK1
CRX2: U1.4 (CANRX), U$3.0-RX1/CS1/CRX2
CRX3: U3.4 (CANRX), U$3.30-CRX3
CS1: U2.35 (IO15), U$3.39-A15/CS/OUT1A
CTX1: U5.1 (CANTX), U$3.22-A8/CTX1
CTX2: U1.1 (CANTX), U$3.1-TX1/MISO1/CTX2
CTX3: U3.1 (CANTX), U$3.31-CTX3
CVDD-1: CCVDD-1.2, IC2.45 (CVDD)
ESPCANRX: U2.32 (IO4), U4.4 (CANRX)
ESPCANTX: U2.29 (IO5), U4.1 (CANTX)
GND: C1.1, C3.1, C4.1, C7.1, CAVDD-1.1, CBAT-1.1, CCOMHNG.1, CCOMHPG.1, CCVDD-1.1, CDVDD-1.1, CFET1.2, CFET2.1, CFET3.1, CFET4.1, CNEG5V-1.1, CNPN1-1.1, CNPN2-1.1, CREFHP-1.1, CVCC.1, ESDCOMH.3, IC2.36 (REFHM), IC2.39 (AVSS), IC2.46 (CVSS), IC2.50 (DVSS), IC2.65 (AVSS?), J3.5, J3.6, J3.7, J3.12, J3.13, LED5.C, LED6.C, LED7.C, LED8.C, PS1.2 (GND), Q1.2, Q1.4, Q1.6, Q1.8, Q2.2, Q2.4, Q2.6, Q2.8, Q3.2, Q3.4, Q3.6, Q3.8, Q4.2, Q4.4, Q4.6, Q4.8, R1.1, R2.1, R5.1, R6.1, R7.1, R25.1, RVC0-1.1, S2.3, U1.2 (GND), U1.8 (RS), U2.14 (GND1), U2.20 (GND3), U2.26 (GND2), U3.2 (GND), U3.8 (RS), U4.2 (GND), U4.8 (RS), U5.2 (GND), U5.8 (RS), U$1.11 (GND), U$3.GND1, U$3.GND2, U$3.GND3
GNDL: CCOMLNG.1, CCOMLPG.1, ESDCOML.3
LDOIN-1: CNPN2-1.2, IC2.47 (LDOIN), T2.E
MISO_ESP: U2.13 (IO12), U$3.41-A17/MISO1
MOSI_ESP: U2.15 (IO13), U$3.26-A12/MOSI1
unnamed: CCOMHP.2, ESDCOMH.1, RCOMHP.1
unnamed: J3.14, R26.2
unnamed: LED4.C, R14.2
unnamed: LED3.C, R13.2
unnamed: S2.1 (S), U$3.8-TX2/IN1
unnamed: CCOMHN.2, ESDCOMH.2, RCOMHN.1
unnamed: LED2.C, R12.2
unnamed: CCOMLNG.2, IC2.41 (COMLN), RCOML.1, RCOMLN.2
unnamed: R17.1, U2.22 (IO22)
unnamed: LED1.C, R11.2
unnamed: Q1.1, R20.1
unnamed: Q2.1, R21.1
unnamed: R15.1, U2.27 (IO19)
unnamed: R16.1, U2.28 (IO18)
unnamed: Q3.1, R23.1
unnamed: R18.1, U2.30 (IO17)
unnamed: LED5.A, R15.2
unnamed: LED6.A, R16.2
unnamed: LED7.A, R17.2
unnamed: LED8.A, R18.2
unnamed: Q4.1, R22.1
unnamed: CCOMLPG.2, IC2.40 (COMLP), RCOML.2, RCOMLP.2
unnamed: CCOMLP.2, ESDCOML.2, RCOMLP.1
unnamed: CCOMLN.2, ESDCOML.1, RCOMLN.1
unnamed: R3.2, R4.1, RVC2-1.1
unnamed: R2.2, R3.1, RVC1-1.1
unnamed: R4.2, R9.1, RVC3-1.1
unnamed: CREFHP-1.2, IC2.37 (REFHP)
unnamed: CAVDD-1.2, IC2.38 (AVDD)
unnamed: CNEG5V-1.2, IC2.44 (NEG5V)
unnamed: CDVDD-1.2, IC2.49 (DVDD)
unnamed: CNPN1-1.2, CVCC.2, RNPN-1.1, T2.C
unnamed: CCOMHPG.2, IC2.43 (COMHP), RCOMH.1, RCOMHP.2
unnamed: CCOMHNG.2, IC2.42 (COMHN), RCOMH.2, RCOMHN.2
NFAULT: IC2.62 (NFAULT), U$1.17 (B3)
NFAULT_3V3: U$1.4 (A3), U$3.16-A2/RX4/SCL1
NPNB-1: IC2.48 (NPNB), T2.B
RX_BQ: IC2.52 (RX), U$1.18 (B2)
RX_ESP: U2.24 (RXD0), U$3.29-TX7
RX_SHFT: U$1.1 (A1), U$3.34-RX8
SCK_ESP: U2.12 (IO14), U$3.27-A13/SCK1
SHUTDOWN_IN: J3.11, R24.2, R26.1
SHUTDOWN_SIGNAL: R24.1, R25.2, U$3.38-A14/CS/IN1
TEMP9: IC2.61 (GPIO1)
TEMP10: IC2.60 (GPIO2)
TEMP11: IC2.59 (GPIO3)
TEMP13: IC2.57 (GPIO5)
TEMP14: IC2.56 (GPIO6)
TEMP15: IC2.55 (GPIO7)
TEMP16: IC2.54 (GPIO8)
TX_BQ: IC2.53 (TX), U$1.20 (B1)
TX_ESP: U2.23 (TXD0), U$3.28-RX7
TX_SHFT: U$1.3 (A2), U$3.35-TX8 (35/TX8)
VC0-1: CVC0-1.2, IC2.34 (CB0), IC2.35 (VC0), RVC0-1.2
VC1-1: CVC0-1.1, CVC1-1.2, IC2.32 (CB1), IC2.33 (VC1), RVC1-1.2
VC2-1: CVC1-1.1, CVC2-1.2, IC2.30 (CB2), IC2.31 (VC2), RVC2-1.2
VC3-1: CVC2-1.1, CVC3-1.2, IC2.28 (CB3), IC2.29 (VC3), RVC3-1.2
VC4-1: CCB10-1.1, CVC3-1.1, IC2.26 (CB4), IC2.27 (VC4), RVC4-1.2
VCC: CFET1.1, CFET2.2, CFET3.2, CFET4.2, J3.1, LED1.A, LED2.A, LED3.A, LED4.A, PS1.1 (+VIN), R9.2, RBAT-1.2, RNPN-1.2, RVC4-1.1
VC_CB_HIGH-1: CBAT-1.2, CCB10-1.2, IC2.1 (BAT), IC2.2 (CB16), IC2.3 (VC16), IC2.4 (CB15), IC2.5 (VC15), IC2.6 (CB14), IC2.7 (VC14), IC2.8 (CB13), IC2.9 (VC13), IC2.10 (CB12), IC2.11 (VC12), IC2.12 (CB11), IC2.13 (VC11), IC2.14 (CB10), IC2.15 (VC10), IC2.16 (CB9), IC2.17 (VC9), IC2.18 (CB8), IC2.19 (VC8), IC2.20 (CB7), IC2.21 (VC7), IC2.22 (CB6), IC2.23 (VC6), IC2.24 (CB5), IC2.25 (VC5), RBAT-1.1

Notes on the sheet:
External com
Voltage source

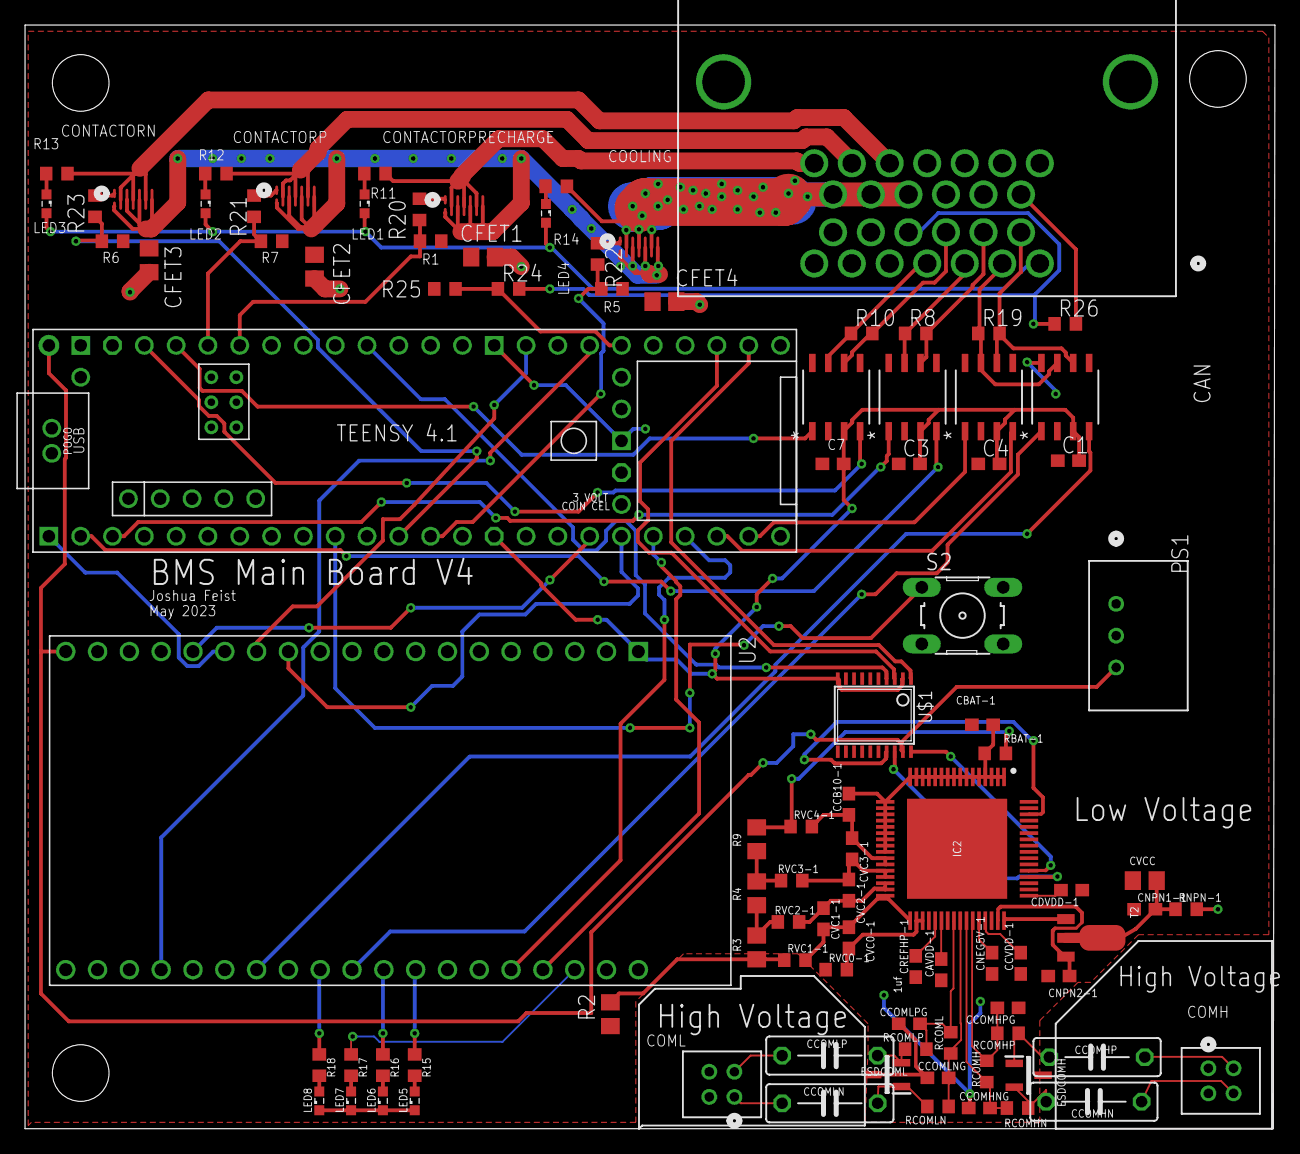
[picture p17: board Hardware/Main controller 79656/esp_teensy_bridge.brd from above]

Board: 2 copper layers, 99.8 x 88.1 mm, 97 parts (0 on the bottom side), 88 nets.
