NU-Formula-Racing/BMS-Deprecated-2023/Hardware/Segment/daughterboard.brd

## EAGLE design Hardware/Segment/daughterboard.brd (2023-01-10)

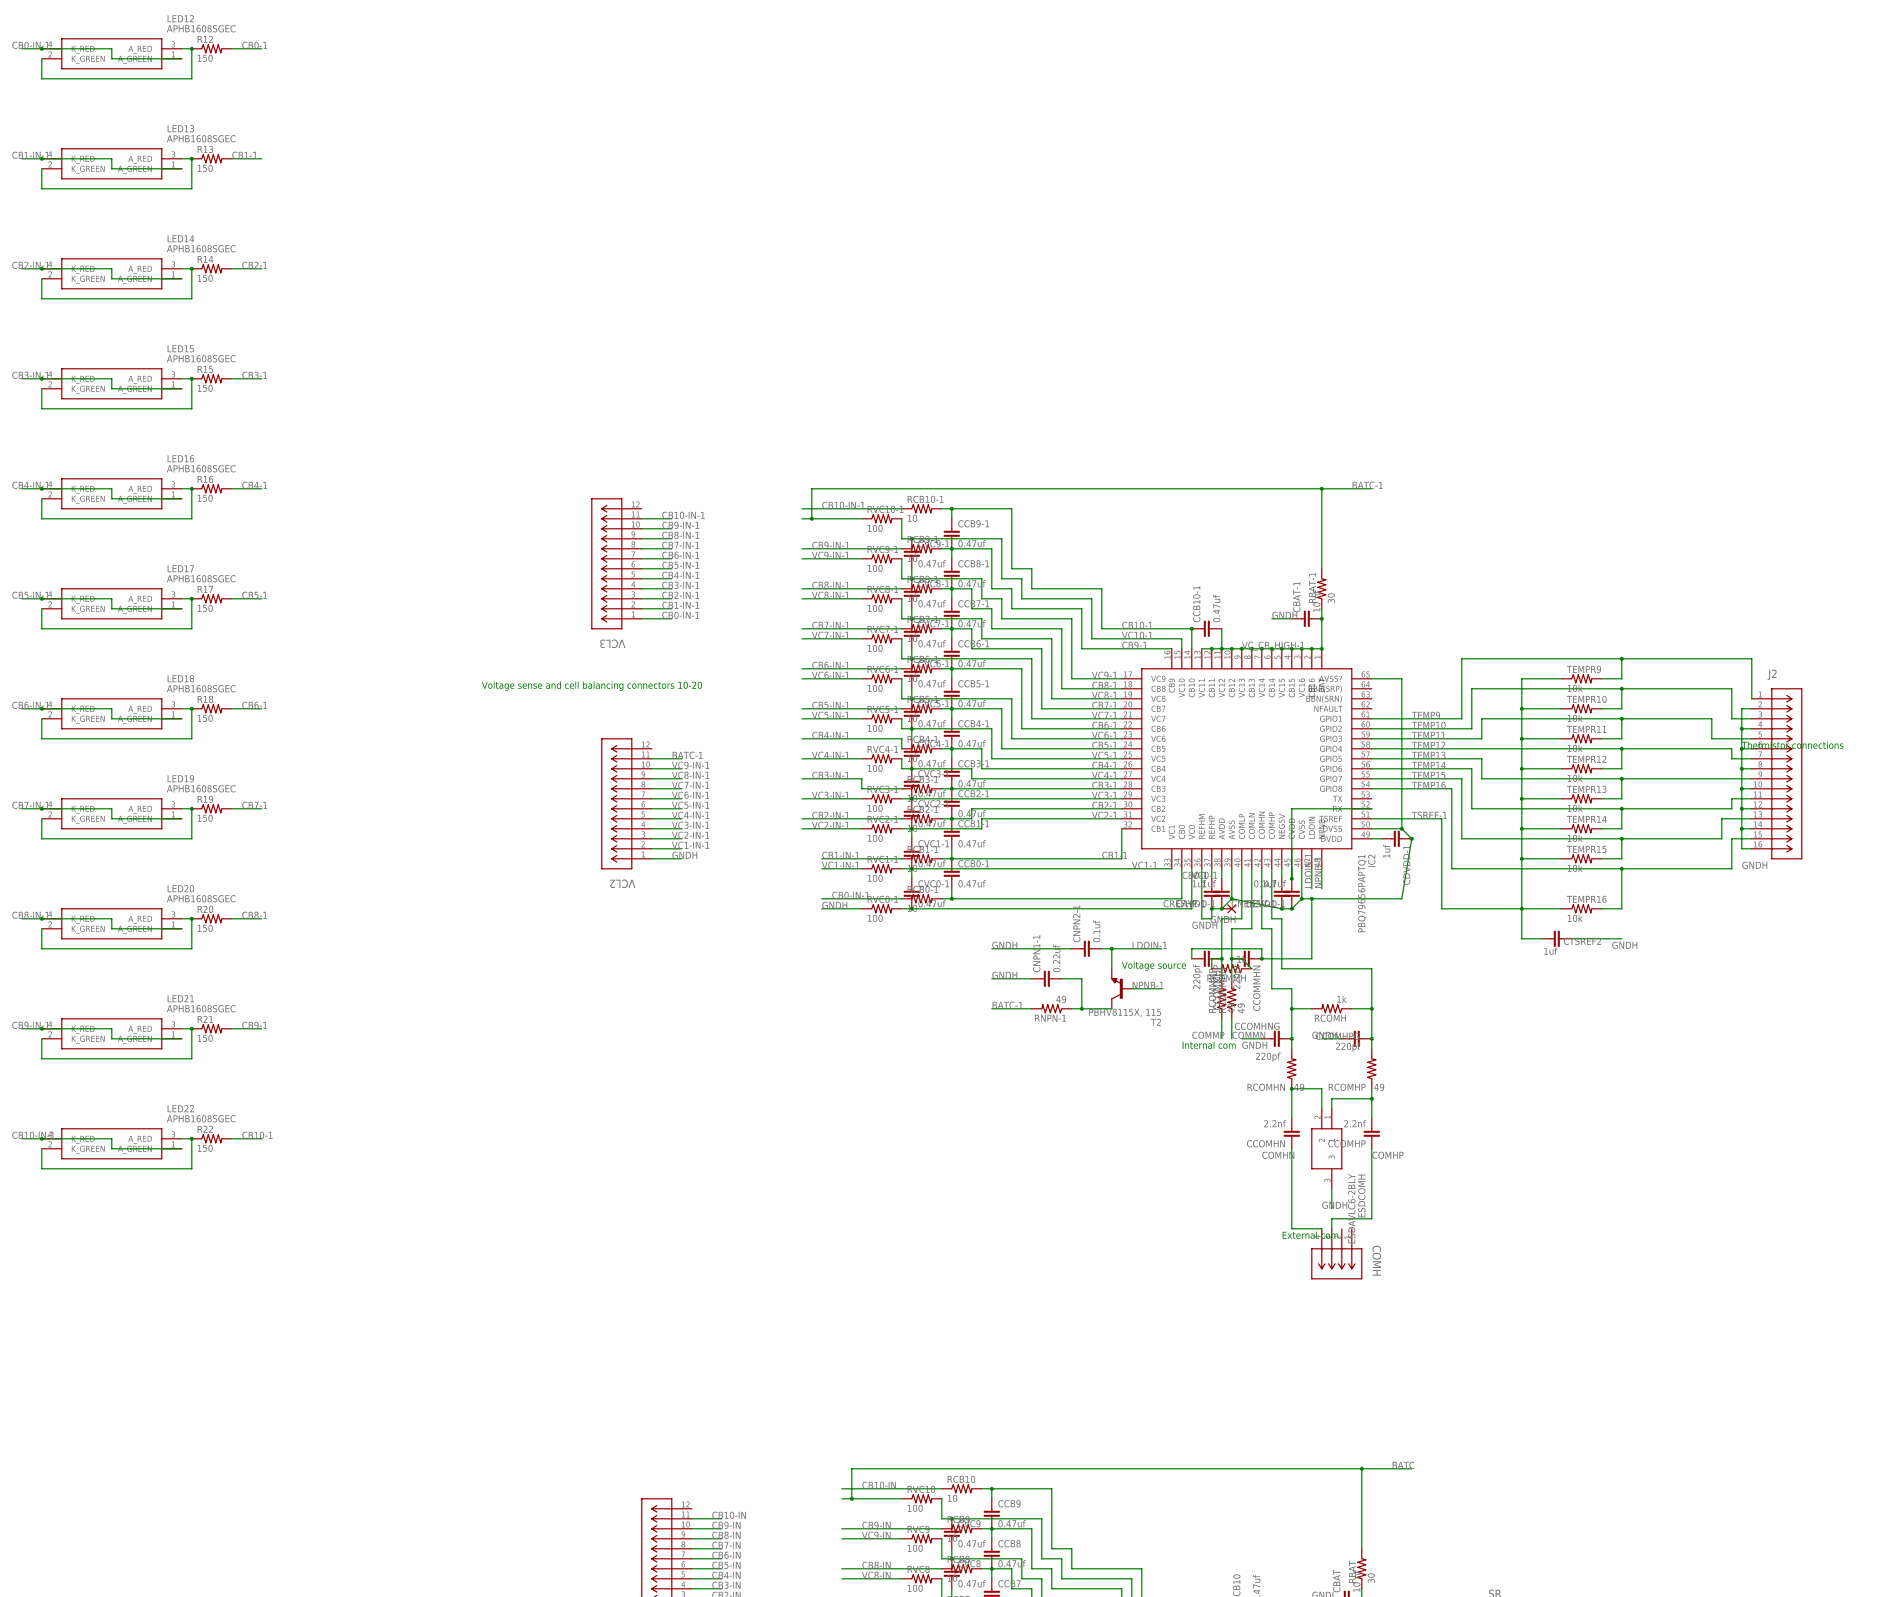
[picture p18: schematic daughterboard.sch, part in row 1, column 1]

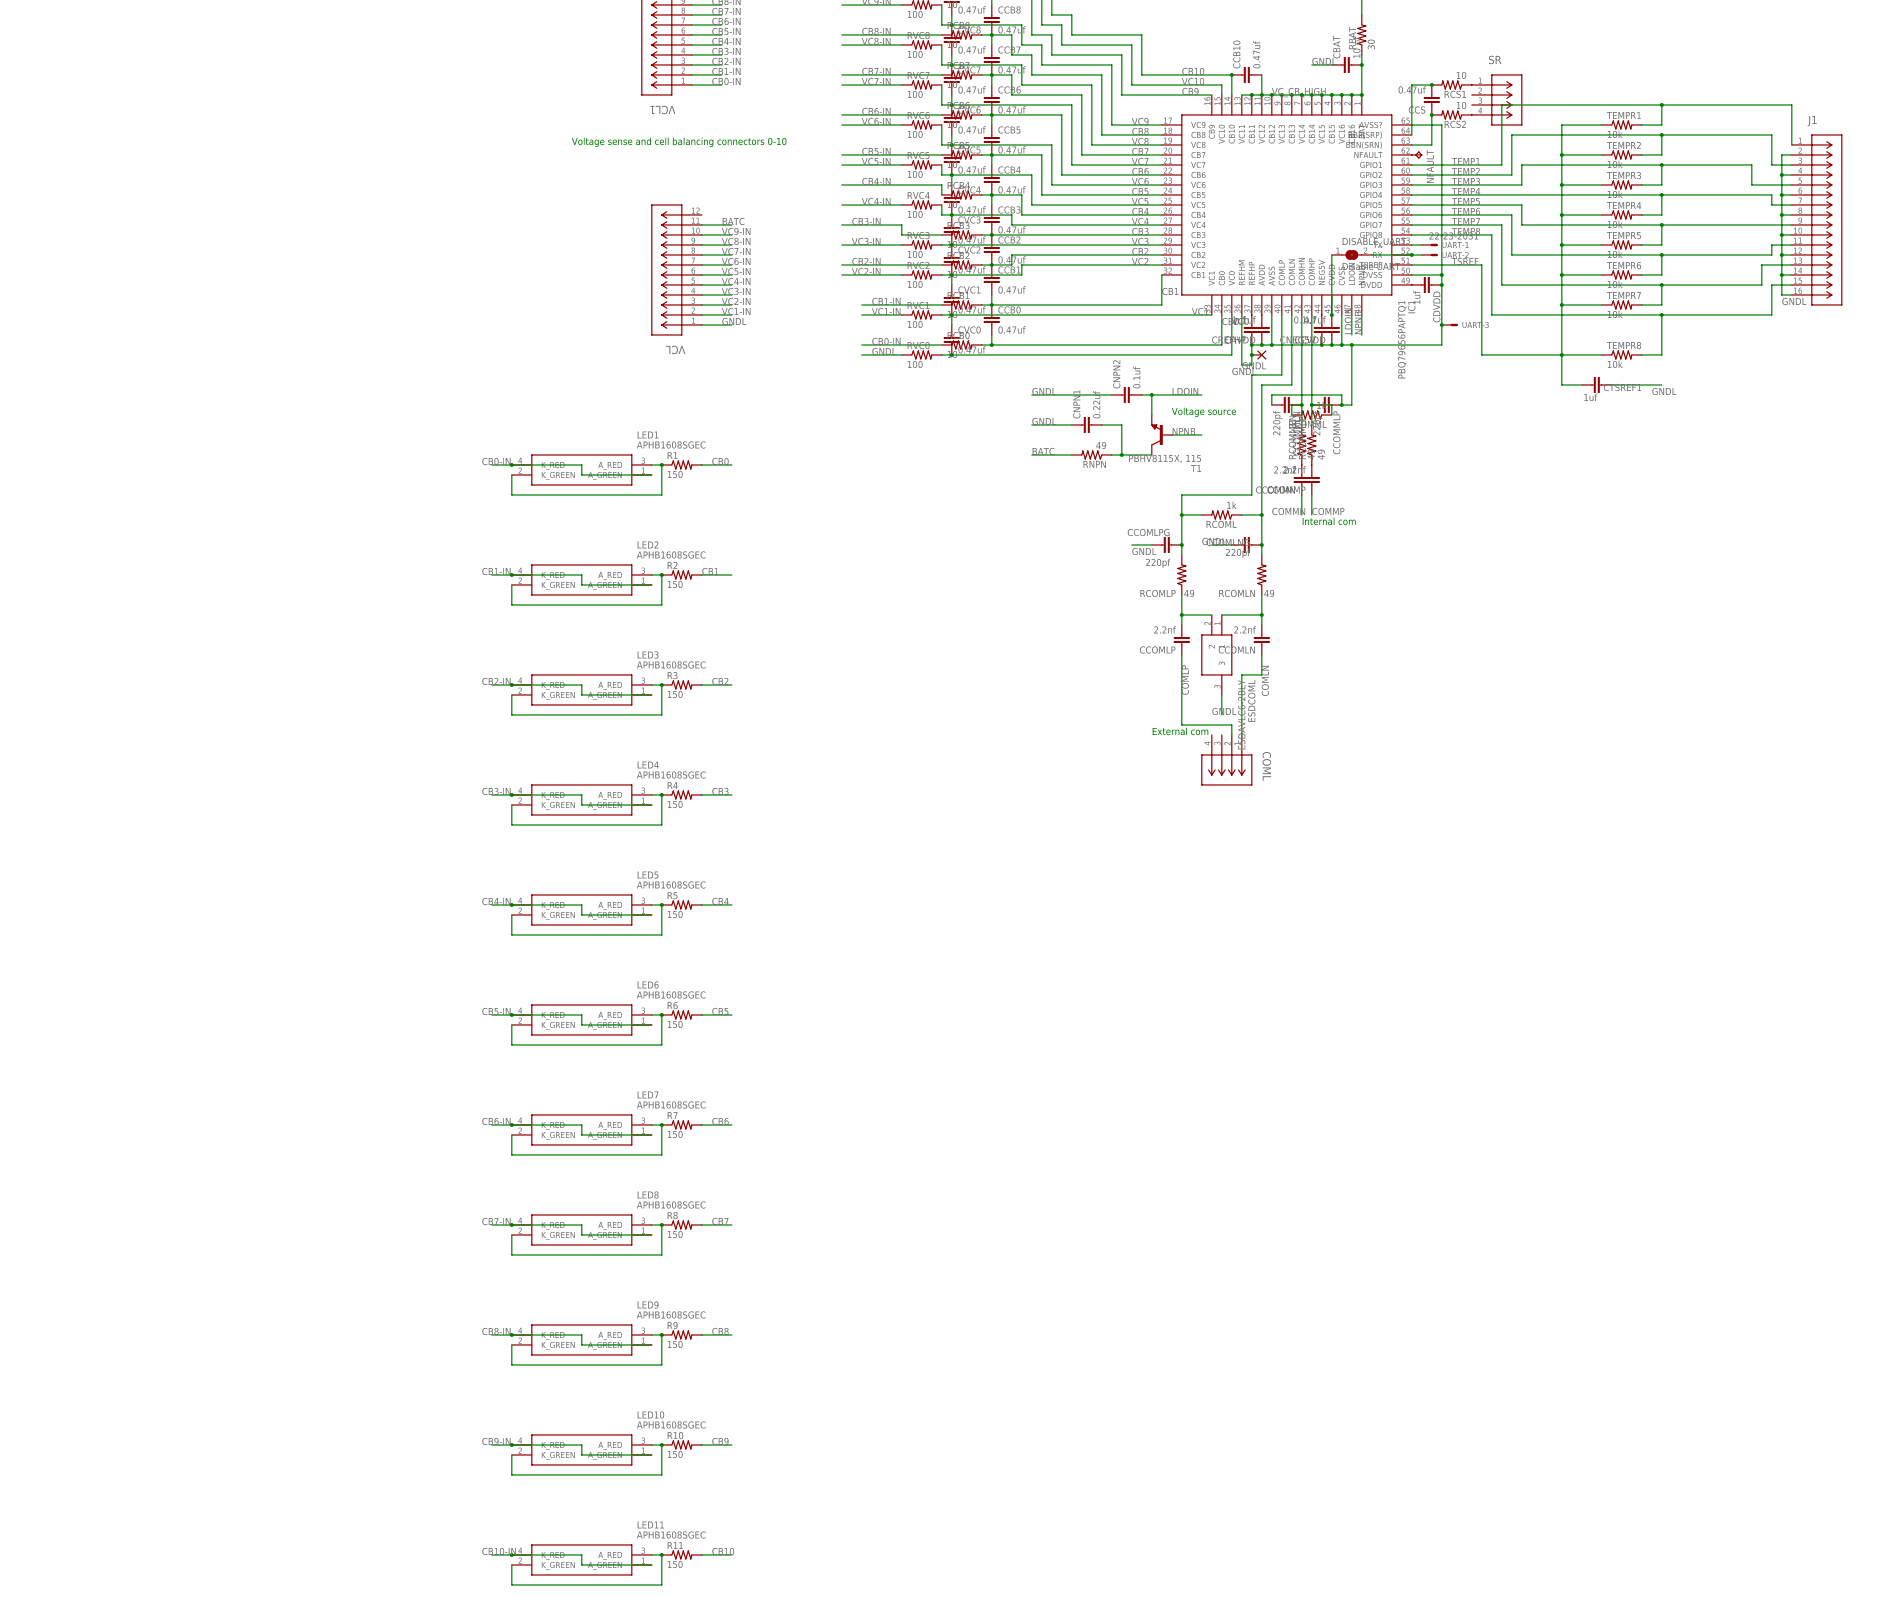
[picture p19: schematic daughterboard.sch, part in row 2, column 1]

Parts:
CAVDD: 1uf; C0603
CAVDD-1: 1uf; C0603
CBAT: 10 nf; C0603
CBAT-1: 10 nf; C0603
CCB0, CCB0-1, CCB1, CCB1-1, CCB2, CCB2-1, CCB3, CCB3-1, CCB4, CCB4-1, CCB5, CCB5-1, CCB6, CCB6-1, CCB7, CCB7-1, CCB8, CCB8-1, CCB9, CCB9-1, CCB10, CCB10-1: 0.47uf; C0603
CCOMHN: 2.2nf; C0603
CCOMHNG: 220pf; C0603
CCOMHP: 2.2nf; C0603
CCOMHPG: 220pf; C0603
CCOMLN: 2.2nf; C0603
CCOMLNG: 220pf; C0603
CCOMLP: 2.2nf; C0603
CCOMLPG: 220pf; C0603
CCOMMHN: 220pf; C0603
CCOMMHP: 220pf; C0603
CCOMMLN: 220pf; C0603
CCOMMLP: 220pf; C0603
CCOMMN: 2.2nf; C0603
CCOMMP: 2.2nf; C0603
CCS: 0.47uf; C0603
CCVDD: 4.7uf; C0603
CCVDD-1: 4.7uf; C0603
CDVDD: 1uf; C0603
CDVDD-1: 1uf; C0603
CNEG5V, CNEG5V-1: 0.1uf; C0603
CNPN1, CNPN1-1: 0.22uf; C0603
CNPN2, CNPN2-1: 0.1uf; C0603
COMH: DF11-4DP-2DSA(24); CON4_2X2_UF_DF11_HIR
COML: DF11-4DP-2DSA(24); CON4_2X2_UF_DF11_HIR
CREFHP: 1uf; C0603
CREFHP-1: 1uf; C0603
CTSREF1, CTSREF2: 1uf; C0603
CVC0, CVC0-1, CVC1, CVC1-1, CVC2, CVC2-1, CVC3, CVC3-1, CVC4, CVC4-1, CVC5, CVC5-1, CVC6, CVC6-1, CVC7, CVC7-1, CVC8, CVC8-1, CVC9, CVC9-1: 0.47uf; C0603
DISABLE_UART: Disable UART; SJ
ESDCOMH: ESDAVLC6-2BLY; SOT95P255X150-3N
ESDCOML: ESDAVLC6-2BLY; SOT95P255X150-3N
GNDH: SMD5; SMD2,54-5,08
GNDL: SMD5; SMD2,54-5,08
IC1, IC2: PBQ79656PAPTQ1; QFP50P1200X1200X120-65N
J1, J2: DF11-16DP-2DSA(01); CONN_DF11-16DP-2DSA(01)_HIR
LED1, LED2, LED3, LED4, LED5, LED6, LED7, LED8, LED9, LED10, LED11, LED12, LED13, LED14, LED15, LED16, LED17, LED18, LED19, LED20, LED21, LED22: APHB1608SGEC
NFAULT: TPB2,54; B2,54
R1, R2, R3, R4, R5, R6, R7, R8, R9, R10, R11, R12, R13, R14, R15, R16, R17, R18, R19, R20, R21, R22: 150; R0603
RBAT: 30; R0603
RBAT-1: 30; R0603
RCB0, RCB0-1, RCB1, RCB1-1, RCB2, RCB2-1, RCB3, RCB3-1, RCB4, RCB4-1, RCB5, RCB5-1, RCB6, RCB6-1, RCB7, RCB7-1, RCB8, RCB8-1, RCB9, RCB9-1, RCB10, RCB10-1: 10; R1210
RCOMH: 1k; R0603
RCOMHN: 49; R0603
RCOMHP: 49; R0603
RCOML: 1k; R0603
RCOMLN: 49; R0603
RCOMLP: 49; R0603
RCOMMH: 1k; R0603
RCOMMHN: 49; R0603
RCOMMHP: 49; R0603
RCOMML: 1k; R0603
RCOMMLN: 49; R0603
RCOMMLP: 49; R0603
RCS1, RCS2: 10; R0603
RNPN: 49; R0603
RNPN-1: 49; R0603
RVC0, RVC0-1, RVC1, RVC1-1, RVC2, RVC2-1, RVC3, RVC3-1, RVC4, RVC4-1, RVC5, RVC5-1, RVC6, RVC6-1, RVC7, RVC7-1, RVC8, RVC8-1, RVC9, RVC9-1, RVC10, RVC10-1: 100; R0603
SR: DF11-4DP-2DSA(24); CON4_2X2_UF_DF11_HIR
T1, T2: PBHV8115X, 115; SOT89-BCE
TEMPR1, TEMPR2, TEMPR3, TEMPR4, TEMPR5, TEMPR6, TEMPR7, TEMPR8, TEMPR9, TEMPR10, TEMPR11, TEMPR12, TEMPR13, TEMPR14, TEMPR15, TEMPR16: 10k; R0603
UART: 22-23-2031
VCL, VCL1, VCL2, VCL3: DF11-12DP-2DSA(01); CON12_2X6_UF_DF11_HIR

Connections:
BATC: RBAT.2, RNPN.2, RVC10.1, VCL.11
BATC-1: RBAT-1.2, RNPN-1.2, RVC10-1.1, VCL2.11
CB0: CCB0.2, IC1.34 (CB0), R1.2, RCB0.2
CB0-1: CCB0-1.2, IC2.34 (CB0), R12.2, RCB0-1.2
CB0-IN: LED1.1 (A_GREEN), LED1.4 (K_RED), RCB0.1, VCL1.1
CB0-IN-1: LED12.1 (A_GREEN), LED12.4 (K_RED), RCB0-1.1, VCL3.1
CB1: CCB0.1, CCB1.2, IC1.32 (CB1), R2.2, RCB1.2
CB1-1: CCB0-1.1, CCB1-1.2, IC2.32 (CB1), R13.2, RCB1-1.2
CB1-IN: LED2.1 (A_GREEN), LED2.4 (K_RED), RCB1.1, VCL1.2
CB1-IN-1: LED13.1 (A_GREEN), LED13.4 (K_RED), RCB1-1.1, VCL3.2
CB2: CCB1.1, CCB2.2, IC1.30 (CB2), R3.2, RCB2.2
CB2-1: CCB1-1.1, CCB2-1.2, IC2.30 (CB2), R14.2, RCB2-1.2
CB2-IN: LED3.1 (A_GREEN), LED3.4 (K_RED), RCB2.1, VCL1.3
CB2-IN-1: LED14.1 (A_GREEN), LED14.4 (K_RED), RCB2-1.1, VCL3.3
CB3: CCB2.1, CCB3.2, IC1.28 (CB3), R4.2, RCB3.2
CB3-1: CCB2-1.1, CCB3-1.2, IC2.28 (CB3), R15.2, RCB3-1.2
CB3-IN: LED4.1 (A_GREEN), LED4.4 (K_RED), RCB3.1, VCL1.4
CB3-IN-1: LED15.1 (A_GREEN), LED15.4 (K_RED), RCB3-1.1, VCL3.4
CB4: CCB3.1, CCB4.2, IC1.26 (CB4), R5.2, RCB4.2
CB4-1: CCB3-1.1, CCB4-1.2, IC2.26 (CB4), R16.2, RCB4-1.2
CB4-IN: LED5.1 (A_GREEN), LED5.4 (K_RED), RCB4.1, VCL1.5
CB4-IN-1: LED16.1 (A_GREEN), LED16.4 (K_RED), RCB4-1.1, VCL3.5
CB5: CCB4.1, CCB5.2, IC1.24 (CB5), R6.2, RCB5.2
CB5-1: CCB4-1.1, CCB5-1.2, IC2.24 (CB5), R17.2, RCB5-1.2
CB5-IN: LED6.1 (A_GREEN), LED6.4 (K_RED), RCB5.1, VCL1.6
CB5-IN-1: LED17.1 (A_GREEN), LED17.4 (K_RED), RCB5-1.1, VCL3.6
CB6: CCB5.1, CCB6.2, IC1.22 (CB6), R7.2, RCB6.2
CB6-1: CCB5-1.1, CCB6-1.2, IC2.22 (CB6), R18.2, RCB6-1.2
CB6-IN: LED7.1 (A_GREEN), LED7.4 (K_RED), RCB6.1, VCL1.7
CB6-IN-1: LED18.1 (A_GREEN), LED18.4 (K_RED), RCB6-1.1, VCL3.7
CB7: CCB6.1, CCB7.2, IC1.20 (CB7), R8.2, RCB7.2
CB7-1: CCB6-1.1, CCB7-1.2, IC2.20 (CB7), R19.2, RCB7-1.2
CB7-IN: LED8.1 (A_GREEN), LED8.4 (K_RED), RCB7.1, VCL1.8
CB7-IN-1: LED19.1 (A_GREEN), LED19.4 (K_RED), RCB7-1.1, VCL3.8
CB8: CCB7.1, CCB8.2, IC1.18 (CB8), R9.2, RCB8.2
CB8-1: CCB7-1.1, CCB8-1.2, IC2.18 (CB8), R20.2, RCB8-1.2
CB8-IN: LED9.1 (A_GREEN), LED9.4 (K_RED), RCB8.1, VCL1.9
CB8-IN-1: LED20.1 (A_GREEN), LED20.4 (K_RED), RCB8-1.1, VCL3.9
CB9: CCB8.1, CCB9.2, IC1.16 (CB9), R10.2, RCB9.2
CB9-1: CCB8-1.1, CCB9-1.2, IC2.16 (CB9), R21.2, RCB9-1.2
CB9-IN: LED10.1 (A_GREEN), LED10.4 (K_RED), RCB9.1, VCL1.10
CB9-IN-1: LED21.1 (A_GREEN), LED21.4 (K_RED), RCB9-1.1, VCL3.10
CB10: CCB9.1, CCB10.1, IC1.14 (CB10), R11.2, RCB10.2
CB10-1: CCB9-1.1, CCB10-1.1, IC2.14 (CB10), R22.2, RCB10-1.2
CB10-IN: LED11.1 (A_GREEN), LED11.4 (K_RED), RCB10.1, VCL1.11
CB10-IN-1: LED22.1 (A_GREEN), LED22.4 (K_RED), RCB10-1.1, VCL3.11
COMHN: CCOMHN.1, COMH.4
COMHP: CCOMHP.1, COMH.3
COMLN: CCOMLN.1, COML.1
COMLP: CCOMLP.1, COML.2
COMMN: CCOMMN.1, RCOMMHN.1
COMMP: CCOMMP.1, RCOMMHP.1
CVDD: CCVDD.2, DISABLE_UART.1, IC1.45 (CVDD)
CVDD-1: CCVDD-1.2, IC2.45 (CVDD), IC2.52 (RX)
GNDH: CAVDD-1.1, CBAT-1.1, CCOMHNG.1, CCOMHPG.1, CCOMMHN.1, CCOMMHP.2, CCVDD-1.1, CDVDD-1.1, CNEG5V-1.1, CNPN1-1.1, CNPN2-1.1, CREFHP-1.1, CTSREF2.1, ESDCOMH.3, GNDH.1, IC2.36 (REFHM), IC2.39 (AVSS), IC2.46 (CVSS), IC2.50 (DVSS), IC2.65 (AVSS?), J2.2, J2.4, J2.6, J2.8, J2.10, J2.12, J2.14, J2.16, RVC0-1.1, VCL2.1
GNDL: CAVDD.1, CBAT.1, CCOMLNG.1, CCOMLPG.1, CCOMMLN.2, CCOMMLP.1, CCVDD.1, CDVDD.1, CNEG5V.1, CNPN1.1, CNPN2.1, CREFHP.1, CTSREF1.1, ESDCOML.3, GNDL.1, IC1.36 (REFHM), IC1.39 (AVSS), IC1.46 (CVSS), IC1.50 (DVSS), IC1.65 (AVSS?), J1.2, J1.4, J1.6, J1.8, J1.10, J1.12, J1.14, J1.16, RVC0.1, UART.3, VCL.1
LDOIN: CNPN2.2, IC1.47 (LDOIN), T1.E
LDOIN-1: CNPN2-1.2, IC2.47 (LDOIN), T2.E
unnamed: CCOMHP.2, ESDCOMH.1, RCOMHP.1
unnamed: CCOMHN.2, ESDCOMH.2, RCOMHN.1
unnamed: DISABLE_UART.2, IC1.52 (RX), UART.2
unnamed: CCS.2, IC1.64 (BBP(SRP)), RCS1.2
unnamed: LED12.2 (K_GREEN), LED12.3 (A_RED), R12.1
unnamed: LED2.2 (K_GREEN), LED2.3 (A_RED), R2.1
unnamed: CCS.1, IC1.63 (BBN(SRN)), RCS2.2
unnamed: LED13.2 (K_GREEN), LED13.3 (A_RED), R13.1
unnamed: IC1.53 (TX), UART.1
unnamed: IC1.62 (NFAULT), NFAULT.TP
unnamed: LED14.2 (K_GREEN), LED14.3 (A_RED), R14.1
unnamed: LED3.2 (K_GREEN), LED3.3 (A_RED), R3.1
unnamed: RCS1.1, SR.1
unnamed: LED15.2 (K_GREEN), LED15.3 (A_RED), R15.1
unnamed: LED16.2 (K_GREEN), LED16.3 (A_RED), R16.1
unnamed: RCS2.1, SR.4
unnamed: LED17.2 (K_GREEN), LED17.3 (A_RED), R17.1
unnamed: LED4.2 (K_GREEN), LED4.3 (A_RED), R4.1
unnamed: LED18.2 (K_GREEN), LED18.3 (A_RED), R18.1
unnamed: LED19.2 (K_GREEN), LED19.3 (A_RED), R19.1
unnamed: LED5.2 (K_GREEN), LED5.3 (A_RED), R5.1
unnamed: LED20.2 (K_GREEN), LED20.3 (A_RED), R20.1
unnamed: LED21.2 (K_GREEN), LED21.3 (A_RED), R21.1
unnamed: LED6.2 (K_GREEN), LED6.3 (A_RED), R6.1
unnamed: LED22.2 (K_GREEN), LED22.3 (A_RED), R22.1
unnamed: LED7.2 (K_GREEN), LED7.3 (A_RED), R7.1
unnamed: CCOMLNG.2, IC1.41 (COMLN), RCOML.1, RCOMLN.2
unnamed: LED8.2 (K_GREEN), LED8.3 (A_RED), R8.1
unnamed: CREFHP.2, IC1.37 (REFHP)
unnamed: LED9.2 (K_GREEN), LED9.3 (A_RED), R9.1
unnamed: LED10.2 (K_GREEN), LED10.3 (A_RED), R10.1
unnamed: LED11.2 (K_GREEN), LED11.3 (A_RED), R11.1
unnamed: LED1.2 (K_GREEN), LED1.3 (A_RED), R1.1
unnamed: CAVDD.2, IC1.38 (AVDD)
unnamed: CNEG5V.2, IC1.44 (NEG5V)
unnamed: CCOMLPG.2, IC1.40 (COMLP), RCOML.2, RCOMLP.2
unnamed: CDVDD.2, IC1.49 (DVDD)
unnamed: CCOMMLN.1, IC1.42 (COMHN), RCOMML.2, RCOMMLN.2
unnamed: CCOMMLP.2, IC1.43 (COMHP), RCOMML.1, RCOMMLP.2
unnamed: CCOMMN.2, RCOMMLN.1
unnamed: CCOMMP.2, RCOMMLP.1
unnamed: CNPN1.2, RNPN.1, T1.C
unnamed: CCOMLP.2, ESDCOML.2, RCOMLP.1
unnamed: CCOMLN.2, ESDCOML.1, RCOMLN.1
unnamed: CREFHP-1.2, IC2.37 (REFHP)
unnamed: CAVDD-1.2, IC2.38 (AVDD)
unnamed: CNEG5V-1.2, IC2.44 (NEG5V)
unnamed: CDVDD-1.2, IC2.49 (DVDD)
unnamed: CCOMMHN.2, IC2.41 (COMLN), RCOMMH.1, RCOMMHN.2
unnamed: CCOMMHP.1, IC2.40 (COMLP), RCOMMH.2, RCOMMHP.2
unnamed: CNPN1-1.2, RNPN-1.1, T2.C
unnamed: CCOMHPG.2, IC2.43 (COMHP), RCOMH.1, RCOMHP.2
unnamed: CCOMHNG.2, IC2.42 (COMHN), RCOMH.2, RCOMHN.2
NPNB: IC1.48 (NPNB), T1.B
NPNB-1: IC2.48 (NPNB), T2.B
TEMP1: IC1.61 (GPIO1), J1.1, TEMPR1.2
TEMP2: IC1.60 (GPIO2), J1.3, TEMPR2.2
TEMP3: IC1.59 (GPIO3), J1.5, TEMPR3.2
TEMP4: IC1.58 (GPIO4), J1.7, TEMPR4.2
TEMP5: IC1.57 (GPIO5), J1.9, TEMPR5.2
TEMP6: IC1.56 (GPIO6), J1.11, TEMPR6.2
TEMP7: IC1.55 (GPIO7), J1.13, TEMPR7.2
TEMP8: IC1.54 (GPIO8), J1.15, TEMPR8.2
TEMP9: IC2.61 (GPIO1), J2.1, TEMPR9.2
TEMP10: IC2.60 (GPIO2), J2.3, TEMPR10.2
TEMP11: IC2.59 (GPIO3), J2.5, TEMPR11.2
TEMP12: IC2.58 (GPIO4), J2.7, TEMPR12.2
TEMP13: IC2.57 (GPIO5), J2.9, TEMPR13.2
TEMP14: IC2.56 (GPIO6), J2.11, TEMPR14.2
TEMP15: IC2.55 (GPIO7), J2.13, TEMPR15.2
TEMP16: IC2.54 (GPIO8), J2.15, TEMPR16.2
TSREF: CTSREF1.2, IC1.51 (TSREF), TEMPR1.1, TEMPR2.1, TEMPR3.1, TEMPR4.1, TEMPR5.1, TEMPR6.1, TEMPR7.1, TEMPR8.1
TSREF-1: CTSREF2.2, IC2.51 (TSREF), TEMPR9.1, TEMPR10.1, TEMPR11.1, TEMPR12.1, TEMPR13.1, TEMPR14.1, TEMPR15.1, TEMPR16.1
VC0: CVC0.2, IC1.35 (VC0), RVC0.2
VC0-1: CVC0-1.2, IC2.35 (VC0), RVC0-1.2
VC1: CVC0.1, CVC1.2, IC1.33 (VC1), RVC1.2
VC1-1: CVC0-1.1, CVC1-1.2, IC2.33 (VC1), RVC1-1.2
VC1-IN: RVC1.1, VCL.2
VC1-IN-1: RVC1-1.1, VCL2.2
VC2: CVC1.1, CVC2.2, IC1.31 (VC2), RVC2.2
VC2-1: CVC1-1.1, CVC2-1.2, IC2.31 (VC2), RVC2-1.2
VC2-IN: RVC2.1, VCL.3
VC2-IN-1: RVC2-1.1, VCL2.3
VC3: CVC2.1, CVC3.2, IC1.29 (VC3), RVC3.2
VC3-1: CVC2-1.1, CVC3-1.2, IC2.29 (VC3), RVC3-1.2
VC3-IN: RVC3.1, VCL.4
VC3-IN-1: RVC3-1.1, VCL2.4
VC4: CVC3.1, CVC4.2, IC1.27 (VC4), RVC4.2
VC4-1: CVC3-1.1, CVC4-1.2, IC2.27 (VC4), RVC4-1.2
VC4-IN: RVC4.1, VCL.5
VC4-IN-1: RVC4-1.1, VCL2.5
VC5: CVC4.1, CVC5.2, IC1.25 (VC5), RVC5.2
VC5-1: CVC4-1.1, CVC5-1.2, IC2.25 (VC5), RVC5-1.2
VC5-IN: RVC5.1, VCL.6
VC5-IN-1: RVC5-1.1, VCL2.6
VC6: CVC5.1, CVC6.2, IC1.23 (VC6), RVC6.2
VC6-1: CVC5-1.1, CVC6-1.2, IC2.23 (VC6), RVC6-1.2
VC6-IN: RVC6.1, VCL.7
VC6-IN-1: RVC6-1.1, VCL2.7
VC7: CVC6.1, CVC7.2, IC1.21 (VC7), RVC7.2
VC7-1: CVC6-1.1, CVC7-1.2, IC2.21 (VC7), RVC7-1.2
VC7-IN: RVC7.1, VCL.8
VC7-IN-1: RVC7-1.1, VCL2.8
VC8: CVC7.1, CVC8.2, IC1.19 (VC8), RVC8.2
VC8-1: CVC7-1.1, CVC8-1.2, IC2.19 (VC8), RVC8-1.2
VC8-IN: RVC8.1, VCL.9
VC8-IN-1: RVC8-1.1, VCL2.9
VC9: CVC8.1, CVC9.2, IC1.17 (VC9), RVC9.2
VC9-1: CVC8-1.1, CVC9-1.2, IC2.17 (VC9), RVC9-1.2
VC9-IN: RVC9.1, VCL.10
VC9-IN-1: RVC9-1.1, VCL2.10
VC10: CVC9.1, IC1.15 (VC10), RVC10.2
VC10-1: CVC9-1.1, IC2.15 (VC10), RVC10-1.2
VC_CB_HIGH: CBAT.2, CCB10.2, IC1.1 (BAT), IC1.2 (CB16), IC1.3 (VC16), IC1.4 (CB15), IC1.5 (VC15), IC1.6 (CB14), IC1.7 (VC14), IC1.8 (CB13), IC1.9 (VC13), IC1.10 (CB12), IC1.11 (VC12), IC1.12 (CB11), IC1.13 (VC11), RBAT.1
VC_CB_HIGH-1: CBAT-1.2, CCB10-1.2, IC2.1 (BAT), IC2.2 (CB16), IC2.3 (VC16), IC2.4 (CB15), IC2.5 (VC15), IC2.6 (CB14), IC2.7 (VC14), IC2.8 (CB13), IC2.9 (VC13), IC2.10 (CB12), IC2.11 (VC12), IC2.12 (CB11), IC2.13 (VC11), RBAT-1.1

Notes on the sheet:
Voltage sense and cell balancing connectors 0-10
Voltage sense and cell balancing connectors 10-20
External com
Internal com
Voltage source
Thermistor connections
