NU-Formula-Racing/BMS-Deprecated-2023/Hardware/Segment/daughterboard.brd

## EAGLE design Hardware/Segment/daughterboard.brd (continued)

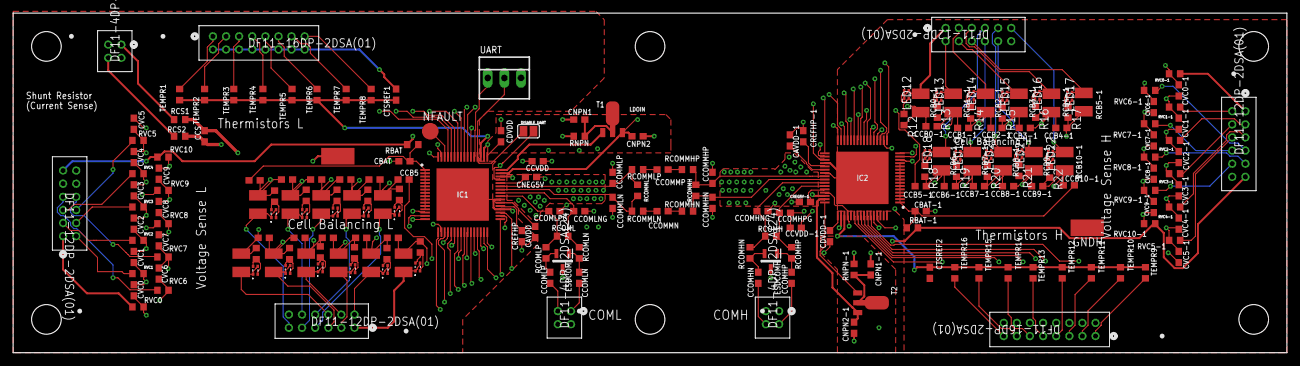
[picture p20: board Hardware/Segment/daughterboard.brd from above]

Board: 4 copper layers, 194.3 x 51.8 mm, 217 parts (0 on the bottom side), 173 nets.
