NU-Formula-Racing/BMS-Deprecated-2023/Hardware/Main controller 79600/esp_teensy_bridge.brd

## EAGLE design Hardware/Main controller 79600/esp_teensy_bridge.brd (2022-03-03)

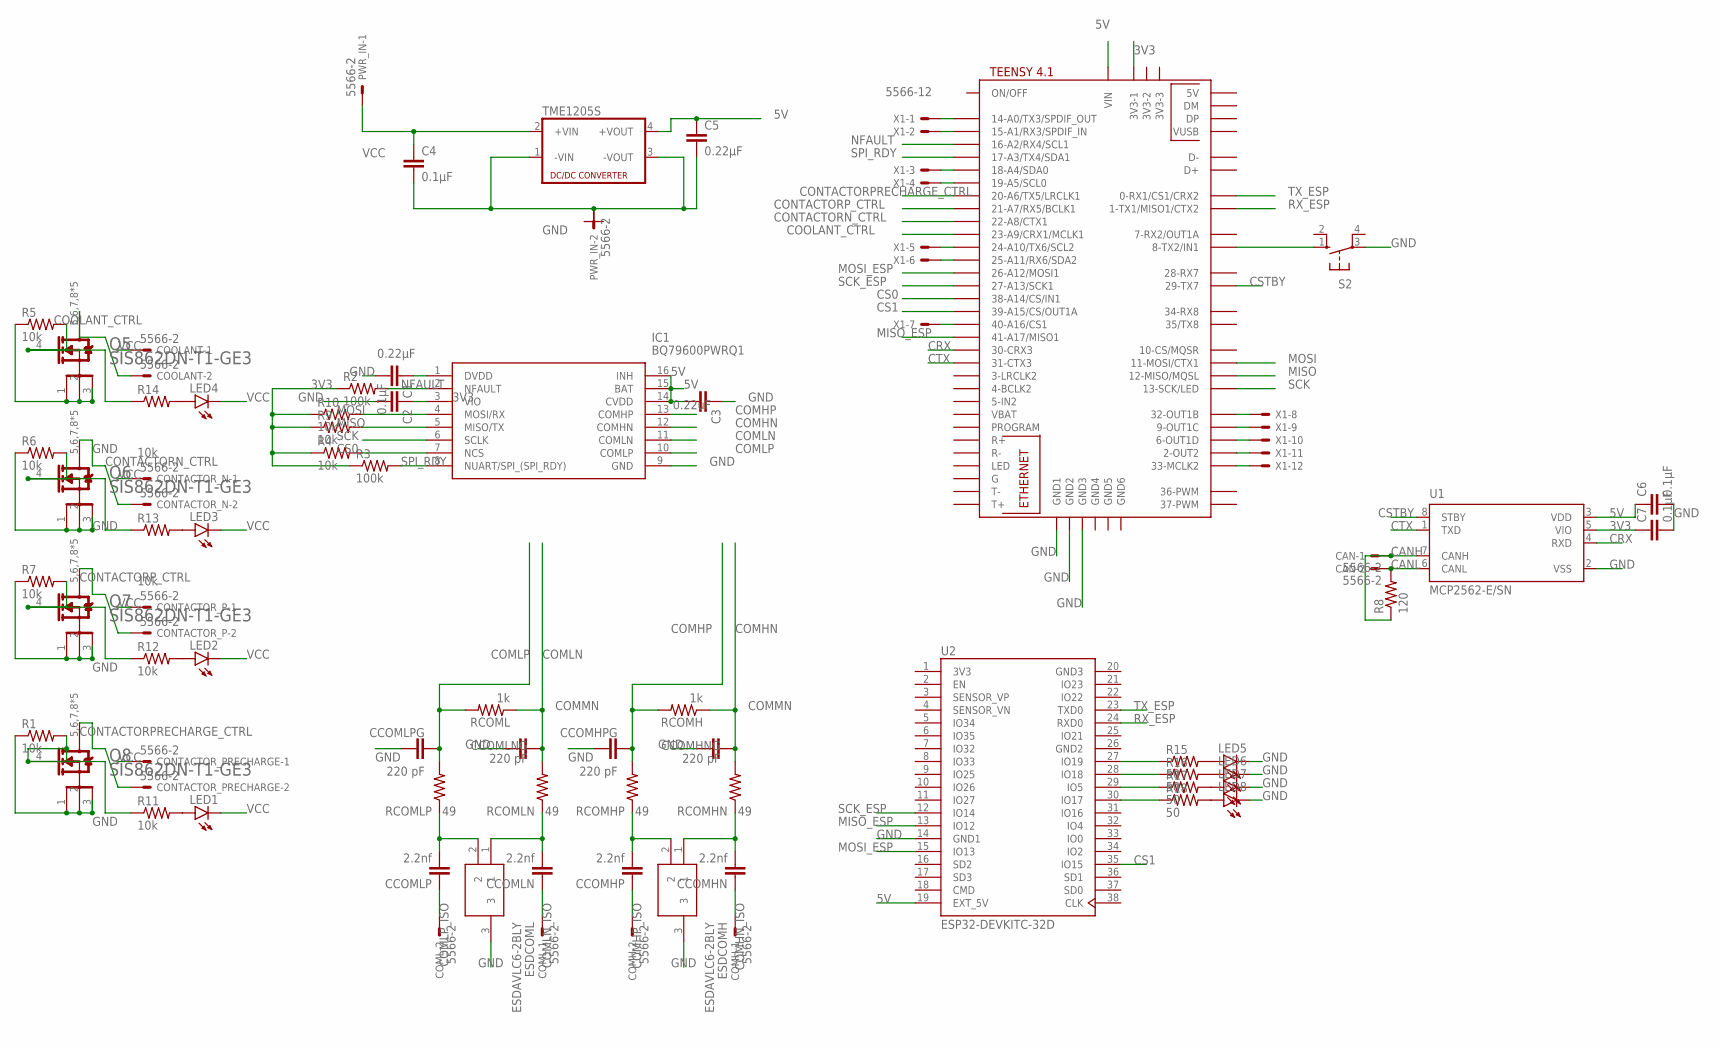
[picture p21: schematic esp_teensy_bridge.sch]

Parts:
C1, C5: 0.22μF; C0603
C2, C4, C6, C7: 0.1μF; C0603
C3: 0.22uF; C0603
CAN: 5566-2
CCOMHN: 2.2nf; C0603
CCOMHNG: 220 pF; C0603
CCOMHP: 2.2nf; C0603
CCOMHPG: 220 pF; C0603
CCOMLN: 2.2nf; C0603
CCOMLNG: 220 pF; C0603
CCOMLP: 2.2nf; C0603
CCOMLPG: 220 pF; C0603
COMH: 5566-2
COML: 5566-2
CONTACTOR_N: 5566-2
CONTACTOR_P: 5566-2
CONTACTOR_PRECHARGE: 5566-2
COOLANT: 5566-2
ESDCOMH: ESDAVLC6-2BLY; SOT95P255X150-3N
ESDCOML: ESDAVLC6-2BLY; SOT95P255X150-3N
IC1: BQ79600PWRQ1; SOP65P640X120-16N
LED1, LED2, LED3, LED4, LED5, LED6, LED7, LED8: LEDSML0603; SML0603
PWR_IN: 5566-2
Q5, Q6, Q7, Q8: VISHAY_SIS862DN-T1-GE3VISHAY_SIS862DN-T1-GE3_0_0; VISHAY_SIS862DN-T1-GE3_0
R1, R4, R5, R6, R7, R9, R10, R11, R12, R13, R14: 10k; R0603
R2, R3: 100k; R0603
R8: 120; R0603
R15, R16, R17, R18: 50; R0603
RCOMH: 1k; R0603
RCOMHN: 49; R0603
RCOMHP: 49; R0603
RCOML: 1k; R0603
RCOMLN: 49; R0603
RCOMLP: 49; R0603
S2: 10-XX; B3F-10XX
TME1205S: NME
U1: MCP2562-E/SN; SOIC127P600X175-8N
U2: ESP32-DEVKITC-32D; MODULE_ESP32-DEVKITC-32D
U$3: TEENSY41
X1: 5566-12

Connections:
3V3: C2.1, C7.1, IC1.3 (VIO), R2.1, R3.1, R4.1, R9.1, R10.1, U1.5 (VIO), U2.1 (3V3), U$3.3V3-1
5V: C3.2, C5.1, C6.1, IC1.14 (CVDD), IC1.15 (BAT), IC1.16 (INH), TME1205S.4 (+VOUT), U1.3 (VDD), U2.19 (EXT_5V), U$3.VIN
CANH: CAN.1, R8.1, U1.7 (CANH)
CANL: CAN.2, R8.2, U1.6 (CANL)
COMHN: CCOMHNG.2, IC1.12 (COMHN), RCOMH.1, RCOMHN.2
COMHN_ISO: CCOMHN.1, COMH.1
COMHP: CCOMHPG.2, IC1.13 (COMHP), RCOMH.2, RCOMHP.2
COMHP_ISO: CCOMHP.1, COMH.2
COMLN: CCOMLNG.2, IC1.11 (COMLN), RCOML.1, RCOMLN.2
COMLN_ISO: CCOMLN.1, COML.1
COMLP: CCOMLPG.2, IC1.10 (COMLP), RCOML.2, RCOMLP.2
COMLP_ISO: CCOMLP.1, COML.2
CONTACTORN_CTRL: Q6.4 (G), R6.2, R13.1, U$3.22-A8/CTX1
CONTACTORPRECHARGE_CTRL: Q8.4 (G), R1.2, R11.1, U$3.20-A6/TX5/LRCLK1
CONTACTORP_CTRL: Q7.4 (G), R7.2, R12.1, U$3.21-A7/RX5/BCLK1
COOLANT_CTRL: Q5.4 (G), R5.2, R14.1, U$3.23-A9/CRX1/MCLK1
CRX: U1.4 (RXD), U$3.30-CRX3
CS0: IC1.7 (NCS), R4.2, U$3.38-A14/CS/IN1
CS1: U2.35 (IO15), U$3.39-A15/CS/OUT1A
CSTBY: U1.8 (STBY), U$3.29-TX7
CTX: U1.1 (TXD), U$3.31-CTX3
GND: C1.2, C2.2, C3.1, C4.2, C5.2, C6.2, C7.2, CCOMHNG.1, CCOMHPG.1, CCOMLNG.1, CCOMLPG.1, ESDCOMH.3, ESDCOML.3, IC1.9 (GND), LED5.C, LED6.C, LED7.C, LED8.C, PWR_IN.2, Q5.1 (1_S), Q5.2 (2_S), Q5.3 (3_S), Q6.1 (1_S), Q6.2 (2_S), Q6.3 (3_S), Q7.1 (1_S), Q7.2 (2_S), Q7.3 (3_S), Q8.1 (1_S), Q8.2 (2_S), Q8.3 (3_S), R1.1, R5.1, R6.1, R7.1, S2.3, TME1205S.1 (-VIN), TME1205S.3 (-VOUT), U1.2 (VSS), U2.14 (GND1), U$3.GND1, U$3.GND2, U$3.GND3
GND2: U2.26 (GND2)
GND3: U2.20 (GND3)
MISO: IC1.5 (MISO/TX), R9.2, U$3.12-MISO/MQSL
MISO_ESP: U2.13 (IO12), U$3.41-A17/MISO1
MOSI: IC1.4 (MOSI/RX), R10.2, U$3.11-MOSI/CTX1
MOSI_ESP: U2.15 (IO13), U$3.26-A12/MOSI1
unnamed: C1.1, IC1.1 (DVDD)
unnamed: CONTACTOR_N.2, Q6.5,6,7,8 (D), Q6.5,6,7,8-2 (D), Q6.5,6,7,8-3 (D), Q6.5,6,7,8-4 (D), Q6.5,6,7,8-5 (D)
unnamed: LED1.A, R11.2
unnamed: LED2.A, R12.2
unnamed: COOLANT.2, Q5.5,6,7,8 (D), Q5.5,6,7,8-2 (D), Q5.5,6,7,8-3 (D), Q5.5,6,7,8-4 (D), Q5.5,6,7,8-5 (D)
unnamed: CONTACTOR_PRECHARGE.2, Q8.5,6,7,8 (D), Q8.5,6,7,8-2 (D), Q8.5,6,7,8-3 (D), Q8.5,6,7,8-4 (D), Q8.5,6,7,8-5 (D)
unnamed: S2.1 (S), U$3.8-TX2/IN1
unnamed: LED3.A, R13.2
unnamed: CCOMLP.2, ESDCOML.2, RCOMLP.1
unnamed: CCOMLN.2, ESDCOML.1, RCOMLN.1
unnamed: CONTACTOR_P.2, Q7.5,6,7,8 (D), Q7.5,6,7,8-2 (D), Q7.5,6,7,8-3 (D), Q7.5,6,7,8-4 (D), Q7.5,6,7,8-5 (D)
unnamed: LED4.A, R14.2
unnamed: U$3.14-A0/TX3/SPDIF_OUT, X1.1
unnamed: CCOMHP.2, ESDCOMH.2, RCOMHP.1
unnamed: CCOMHN.2, ESDCOMH.1, RCOMHN.1
unnamed: U$3.15-A1/RX3/SPDIF_IN, X1.2
unnamed: U$3.18-A4/SDA0, X1.3
unnamed: U$3.19-A5/SCL0, X1.4
unnamed: U$3.24-A10/TX6/SCL2, X1.5
unnamed: U$3.25-A11/RX6/SDA2, X1.6
unnamed: U$3.40-A16/CS1, X1.7
unnamed: U$3.32-OUT1B, X1.8
unnamed: U$3.9-OUT1C, X1.9
unnamed: U$3.6-OUT1D, X1.10
unnamed: U$3.33-MCLK2, X1.12
unnamed: U$3.2-OUT2, X1.11
unnamed: R15.1, U2.27 (IO19)
unnamed: R16.1, U2.28 (IO18)
unnamed: R17.1, U2.29 (IO5)
unnamed: R18.1, U2.30 (IO17)
unnamed: LED5.A, R15.2
unnamed: LED6.A, R16.2
unnamed: LED7.A, R17.2
unnamed: LED8.A, R18.2
NFAULT: IC1.2 (NFAULT), R2.2, U$3.16-A2/RX4/SCL1
RX_ESP: U2.24 (RXD0), U$3.1-TX1/MISO1/CTX2
SCK: IC1.6 (SCLK), U$3.13-SCK/LED
SCK_ESP: U2.12 (IO14), U$3.27-A13/SCK1
SPI_RDY: IC1.8 (NUART/SPI_(SPI_RDY)), R3.2, U$3.17-A3/TX4/SDA1
TX_ESP: U2.23 (TXD0), U$3.0-RX1/CS1/CRX2
VCC: C4.1, CONTACTOR_N.1, CONTACTOR_P.1, CONTACTOR_PRECHARGE.1, COOLANT.1, LED1.C, LED2.C, LED3.C, LED4.C, PWR_IN.1, TME1205S.2 (+VIN)

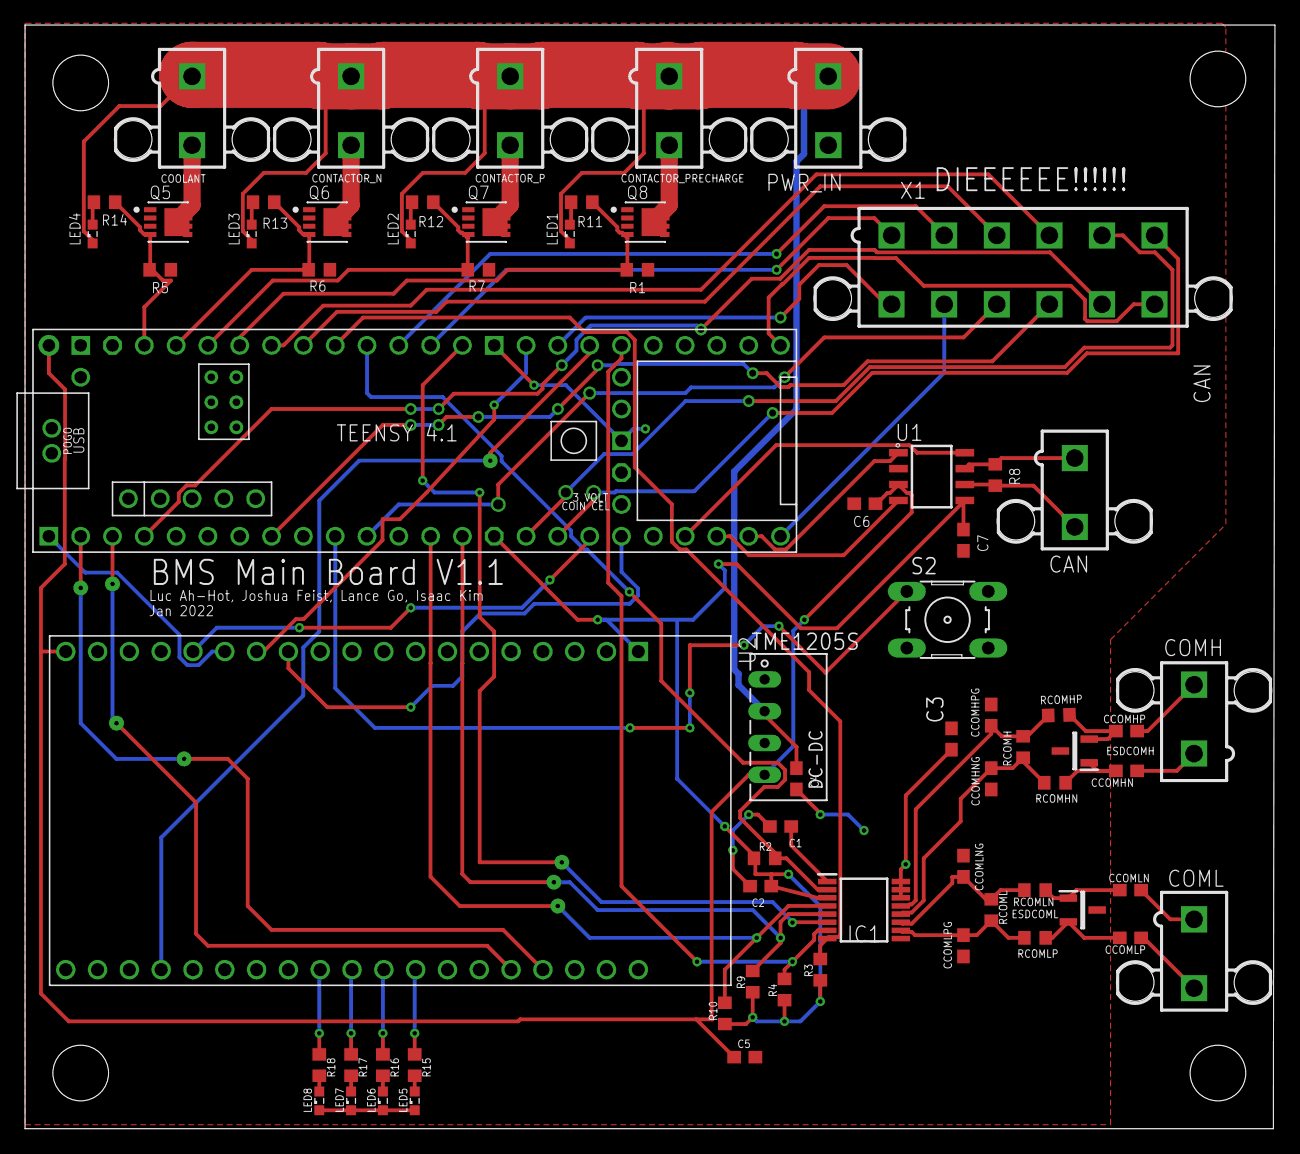
[picture p22: board Hardware/Main controller 79600/esp_teensy_bridge.brd from above]

Board: 2 copper layers, 99.8 x 88.1 mm, 68 parts (0 on the bottom side), 67 nets.
