NU-Formula-Racing/BMS-Deprecated-2023/Hardware/Main controller 79600/practice.brd

## EAGLE design Hardware/Main controller 79600/practice.brd (2021-11-11)

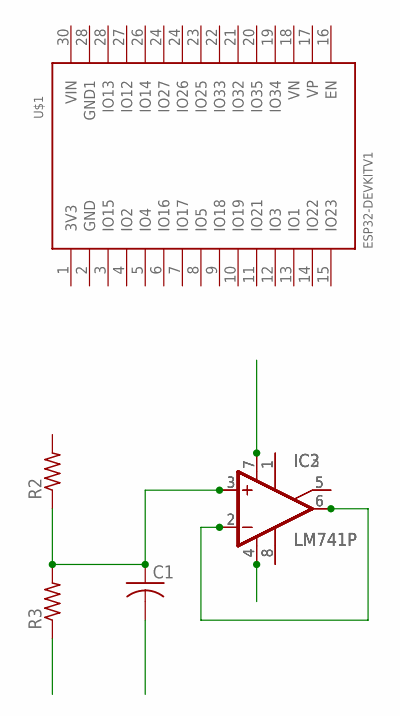
[picture p23: schematic practice.sch]

Parts:
C1: C-US025-040X050; C025-040X050
IC2, IC3: LM741P; DIL08
R2, R3: R-US_0207/10; 0207/10
U$1: ESP32DEVKITV1; ESP32-DEVKITV1

Connections:
unnamed: IC2.5 (ON2), IC3.5 (ON2)
unnamed: IC2.1 (ON1), IC3.1 (ON1)
unnamed: IC2.2 (-IN), IC2.6 (OUT), IC3.2 (-IN), IC3.6 (OUT)
unnamed: IC2.8 (OPT), IC3.8 (OPT)
unnamed: IC2.7 (V+), IC3.7 (V+)
unnamed: IC2.4 (V-), IC3.4 (V-)
unnamed: C1.1, IC2.3 (+IN), IC3.3 (+IN), R2.1, R3.2

Board: 2 copper layers, 6 parts (0 on the bottom side), 7 nets, no tracks yet.
