NU-Formula-Racing/BMS-Deprecated-2023/Hardware/Dummy Battery/dummy_battery.brd

## EAGLE design Hardware/Dummy Battery/dummy_battery.brd (2022-01-20)

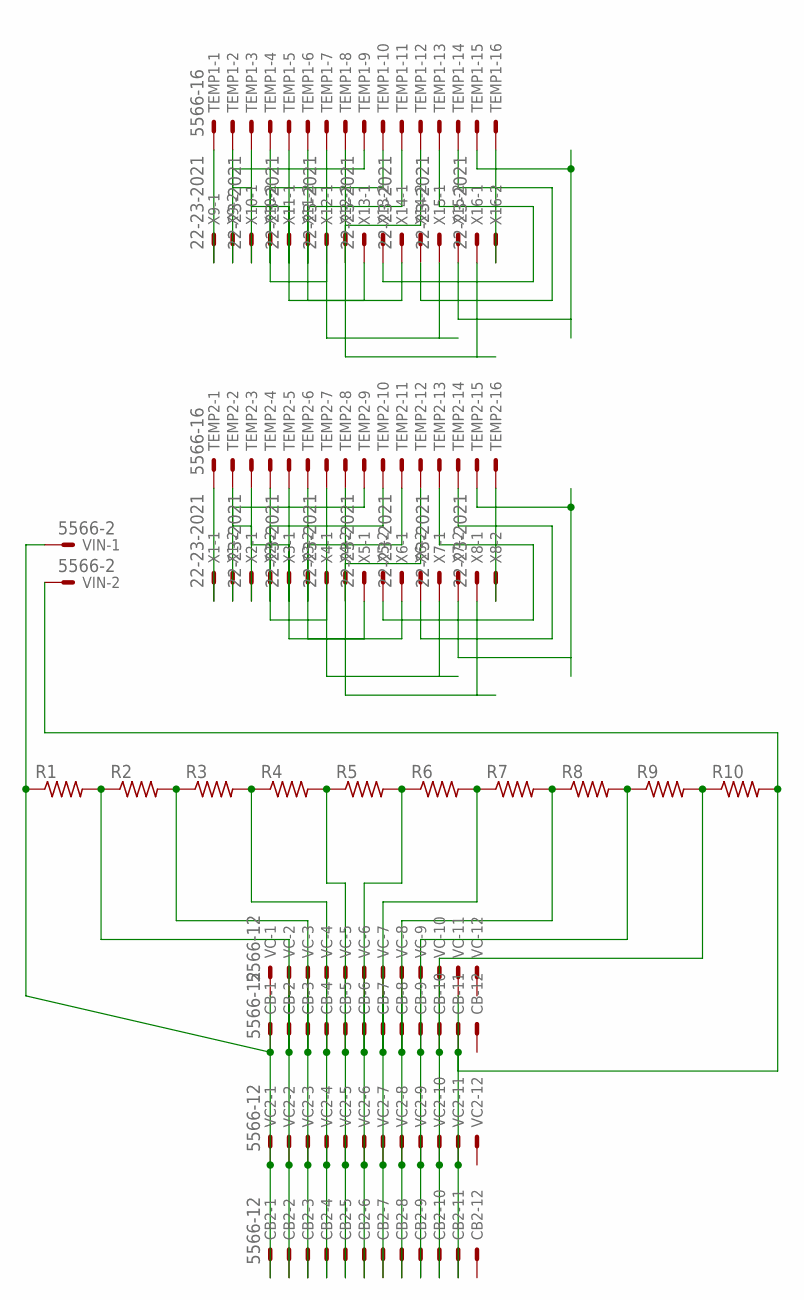
[picture p24: schematic dummy_battery.sch]

Parts:
CB, CB2: 5566-12
R1, R2, R3, R4, R5, R6, R7, R8, R9, R10: R-US_R0805; R0805
TEMP1, TEMP2: 5566-16
VC, VC2: 5566-12
VIN: 5566-2
X1, X2, X3, X4, X5, X6, X7, X8, X9, X10, X11, X12, X13, X14, X15, X16: 22-23-2021

Connections:
unnamed: CB.2, CB2.2, R1.2, R2.1, VC.2, VC2.2
unnamed: CB.3, CB2.3, R2.2, R3.1, VC.3, VC2.3
unnamed: CB.4, CB2.4, R3.2, R4.1, VC.4, VC2.4
unnamed: CB.5, CB2.5, R4.2, R5.1, VC.5, VC2.5
unnamed: CB.6, CB2.6, R5.2, R6.1, VC.6, VC2.6
unnamed: CB.7, CB2.7, R6.2, R7.1, VC.7, VC2.7
unnamed: CB.8, CB2.8, R7.2, R8.1, VC.8, VC2.8
unnamed: CB.9, CB2.9, R8.2, R9.1, VC.9, VC2.9
unnamed: CB.10, CB2.10, R9.2, R10.1, VC.10, VC2.10
unnamed: CB.1, CB2.1, R1.1, VC.1, VC2.1, VIN.1
unnamed: CB.11, CB2.11, R10.2, VC.11, VC2.11, VIN.2
unnamed: TEMP2.1, X1.1
unnamed: TEMP2.9, X1.2
unnamed: TEMP2.2, X2.1
unnamed: TEMP2.10, X2.2
unnamed: TEMP2.3, X3.1
unnamed: TEMP2.11, X3.2
unnamed: TEMP2.4, X4.1
unnamed: TEMP2.12, X4.2
unnamed: TEMP2.5, X5.1
unnamed: TEMP2.13, X5.2
unnamed: TEMP2.6, X6.1
unnamed: TEMP2.14, X6.2
unnamed: TEMP2.7, X7.1
unnamed: TEMP2.15, X7.2
unnamed: TEMP2.8, X8.1
unnamed: TEMP2.16, X8.2
unnamed: TEMP1.1, X9.1
unnamed: TEMP1.9, X9.2
unnamed: TEMP1.2, X10.1
unnamed: TEMP1.10, X10.2
unnamed: TEMP1.3, X11.1
unnamed: TEMP1.11, X11.2
unnamed: TEMP1.4, X12.1
unnamed: TEMP1.12, X12.2
unnamed: TEMP1.5, X13.1
unnamed: TEMP1.13, X13.2
unnamed: TEMP1.6, X14.1
unnamed: TEMP1.14, X14.2
unnamed: TEMP1.7, X15.1
unnamed: TEMP1.15, X15.2
unnamed: TEMP1.8, X16.1
unnamed: TEMP1.16, X16.2

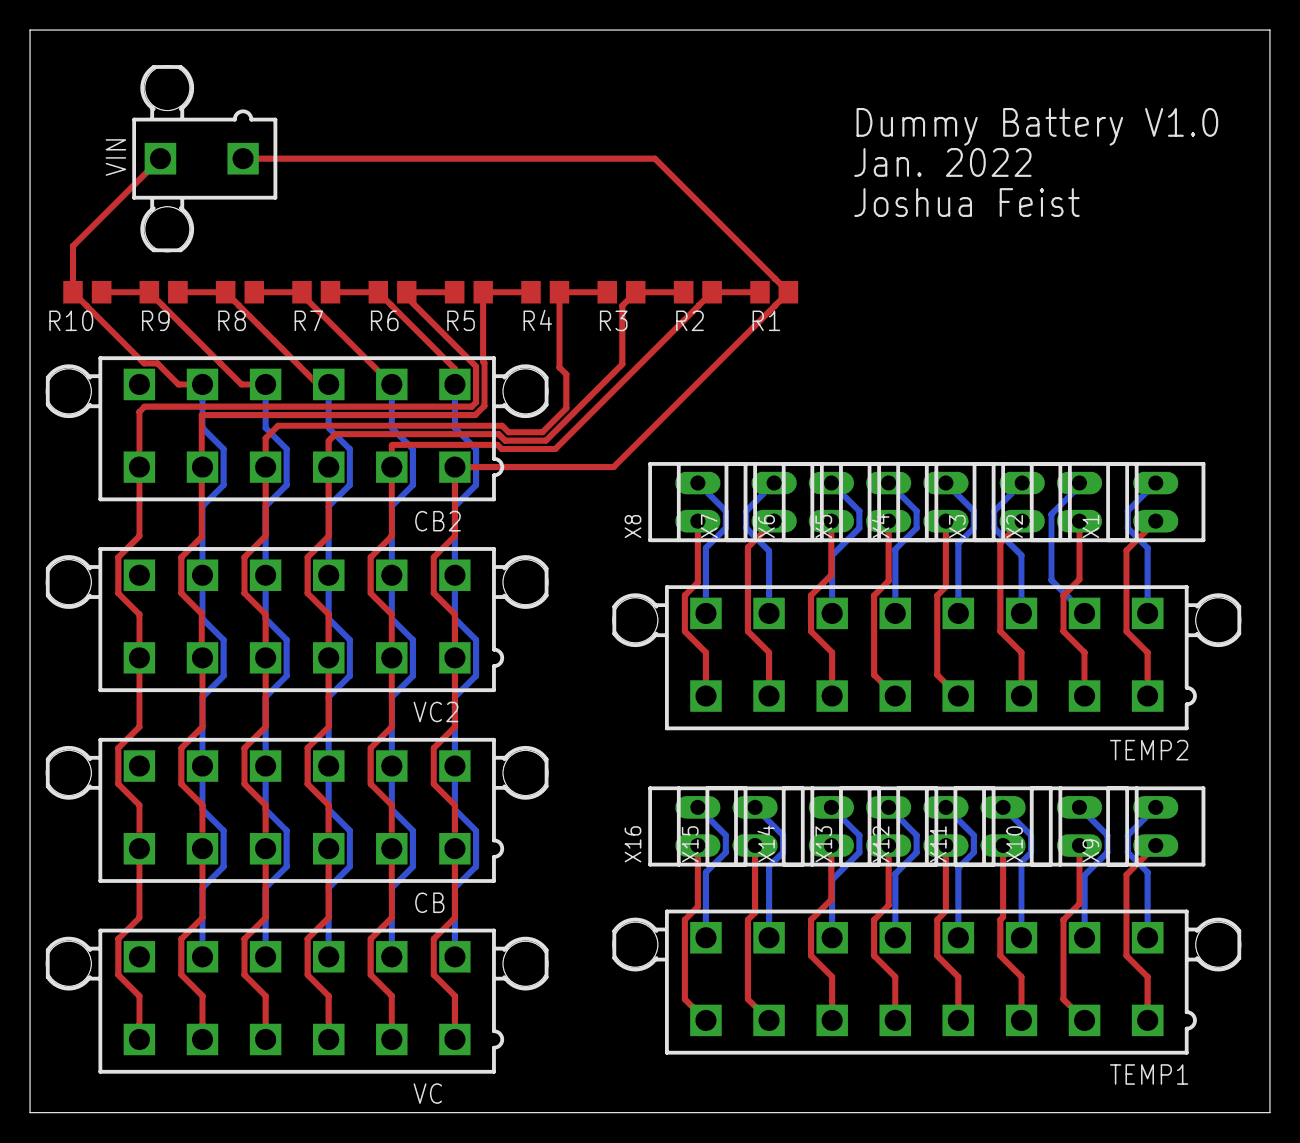
[picture p25: board dummy_battery.brd from above]

Board: 2 copper layers, 82.5 x 72.1 mm, 33 parts (0 on the bottom side), 43 nets.
