NU-Formula-Racing/BMS-Deprecated-2023/Hardware/Segment/V0_CAM/daughterboard.brd

## EAGLE design Hardware/Segment/V0_CAM/daughterboard.brd (2022-01-04, an earlier design)

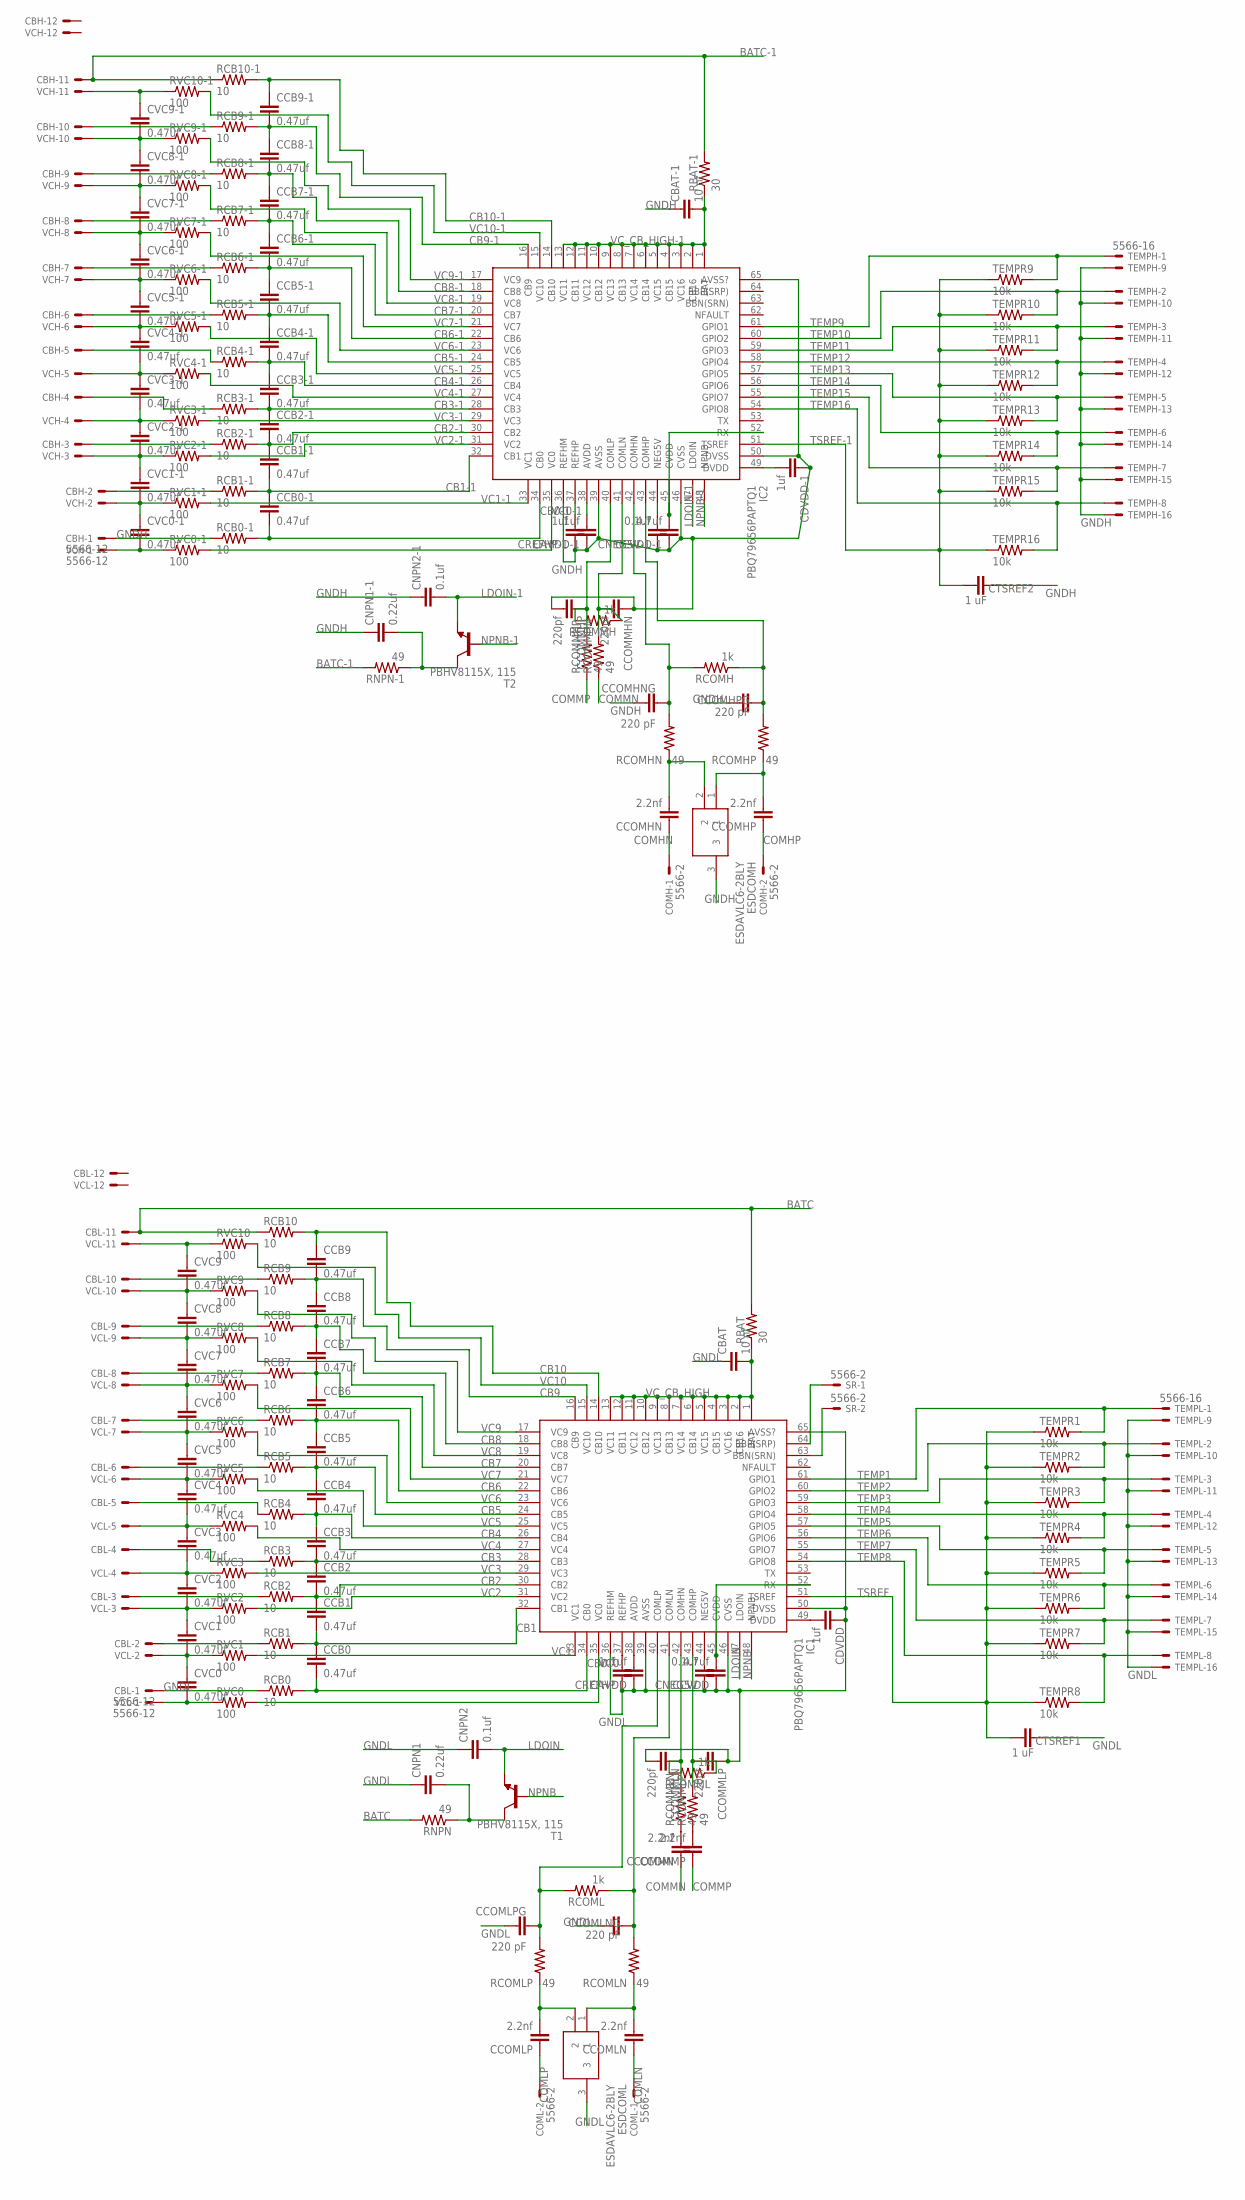
[picture p26: schematic daughterboard.sch]

Parts:
CAVDD: 1uf; C0603
CAVDD-1: 1uf; C0603
CBAT: 10 nf; C0603
CBAT-1: 10 nf; C0603
CBH: 5566-12
CBL: 5566-12
CCB0, CCB0-1, CCB1, CCB1-1, CCB2, CCB2-1, CCB3, CCB3-1, CCB4, CCB4-1, CCB5, CCB5-1, CCB6, CCB6-1, CCB7, CCB7-1, CCB8, CCB8-1, CCB9, CCB9-1: 0.47uf; C0603
CCOMHN: 2.2nf; C0603
CCOMHNG: 220 pF; C0603
CCOMHP: 2.2nf; C0603
CCOMHPG: 220 pF; C0603
CCOMLN: 2.2nf; C0603
CCOMLNG: 220 pF; C0603
CCOMLP: 2.2nf; C0603
CCOMLPG: 220 pF; C0603
CCOMMHN: 220pf; C0603
CCOMMHP: 220pf; C0603
CCOMMLN: 220pf; C0603
CCOMMLP: 220pf; C0603
CCOMMN: 2.2nf; C0603
CCOMMP: 2.2nf; C0603
CCVDD: 4.7uf; C0603
CCVDD-1: 4.7uf; C0603
CDVDD: 1uf; C0603
CDVDD-1: 1uf; C0603
CNEG5V, CNEG5V-1: 0.1uf; C0603
CNPN1, CNPN1-1: 0.22uf; C0603
CNPN2, CNPN2-1: 0.1uf; C0603
COMH: 5566-2
COML: 5566-2
CREFHP: 1uf; C0603
CREFHP-1: 1uf; C0603
CTSREF1, CTSREF2: 1 uF; C0603
CVC0, CVC0-1, CVC1, CVC1-1, CVC2, CVC2-1, CVC3, CVC3-1, CVC4, CVC4-1, CVC5, CVC5-1, CVC6, CVC6-1, CVC7, CVC7-1, CVC8, CVC8-1, CVC9, CVC9-1: 0.47uf; C0603
ESDCOMH: ESDAVLC6-2BLY; SOT95P255X150-3N
ESDCOML: ESDAVLC6-2BLY; SOT95P255X150-3N
IC1, IC2: PBQ79656PAPTQ1; QFP50P1200X1200X120-65N
RBAT: 30; R0603
RBAT-1: 30; R0603
RCB0, RCB0-1, RCB1, RCB1-1, RCB2, RCB2-1, RCB3, RCB3-1, RCB4, RCB4-1, RCB5, RCB5-1, RCB6, RCB6-1, RCB7, RCB7-1, RCB8, RCB8-1, RCB9, RCB9-1, RCB10, RCB10-1: 10; R1210
RCOMH: 1k; R0603
RCOMHN: 49; R0603
RCOMHP: 49; R0603
RCOML: 1k; R0603
RCOMLN: 49; R0603
RCOMLP: 49; R0603
RCOMMH: 1k; R0603
RCOMMHN: 49; R0603
RCOMMHP: 49; R0603
RCOMML: 1k; R0603
RCOMMLN: 49; R0603
RCOMMLP: 49; R0603
RNPN: 49; R0603
RNPN-1: 49; R0603
RVC0, RVC0-1, RVC1, RVC1-1, RVC2, RVC2-1, RVC3, RVC3-1, RVC4, RVC4-1, RVC5, RVC5-1, RVC6, RVC6-1, RVC7, RVC7-1, RVC8, RVC8-1, RVC9, RVC9-1, RVC10, RVC10-1: 100; R0603
SR: 5566-2
T1, T2: PBHV8115X, 115; SOT89-BCE
TEMPH: 5566-16
TEMPL: 5566-16
TEMPR1, TEMPR2, TEMPR3, TEMPR4, TEMPR5, TEMPR6, TEMPR7, TEMPR8, TEMPR9, TEMPR10, TEMPR11, TEMPR12, TEMPR13, TEMPR14, TEMPR15, TEMPR16: 10k; R0603
VCH: 5566-12
VCL: 5566-12

Connections:
BATC: CBL.11, RBAT.2, RCB10.1, RNPN.2
BATC-1: CBH.11, RBAT-1.2, RCB10-1.1, RNPN-1.2
CB0: CCB0.2, IC1.34 (CB0), RCB0.2
CB0-1: CCB0-1.2, IC2.34 (CB0), RCB0-1.2
CB1: CCB0.1, CCB1.2, IC1.32 (CB1), RCB1.2
CB1-1: CCB0-1.1, CCB1-1.2, IC2.32 (CB1), RCB1-1.2
CB2: CCB1.1, CCB2.2, IC1.30 (CB2), RCB2.2
CB2-1: CCB1-1.1, CCB2-1.2, IC2.30 (CB2), RCB2-1.2
CB3: CCB2.1, CCB3.2, IC1.28 (CB3), RCB3.2
CB3-1: CCB2-1.1, CCB3-1.2, IC2.28 (CB3), RCB3-1.2
CB4: CCB3.1, CCB4.2, IC1.26 (CB4), RCB4.2
CB4-1: CCB3-1.1, CCB4-1.2, IC2.26 (CB4), RCB4-1.2
CB5: CCB4.1, CCB5.2, IC1.24 (CB5), RCB5.2
CB5-1: CCB4-1.1, CCB5-1.2, IC2.24 (CB5), RCB5-1.2
CB6: CCB5.1, CCB6.2, IC1.22 (CB6), RCB6.2
CB6-1: CCB5-1.1, CCB6-1.2, IC2.22 (CB6), RCB6-1.2
CB7: CCB6.1, CCB7.2, IC1.20 (CB7), RCB7.2
CB7-1: CCB6-1.1, CCB7-1.2, IC2.20 (CB7), RCB7-1.2
CB8: CCB7.1, CCB8.2, IC1.18 (CB8), RCB8.2
CB8-1: CCB7-1.1, CCB8-1.2, IC2.18 (CB8), RCB8-1.2
CB9: CCB8.1, CCB9.2, IC1.16 (CB9), RCB9.2
CB9-1: CCB8-1.1, CCB9-1.2, IC2.16 (CB9), RCB9-1.2
CB10: CCB9.1, IC1.14 (CB10), RCB10.2
CB10-1: CCB9-1.1, IC2.14 (CB10), RCB10-1.2
COMHN: CCOMHN.1, COMH.1
COMHP: CCOMHP.1, COMH.2
COMLN: CCOMLN.1, COML.1
COMLP: CCOMLP.1, COML.2
COMMN: CCOMMN.1, RCOMMHN.1
COMMP: CCOMMP.1, RCOMMHP.1
CVDD: CCVDD.2, IC1.45 (CVDD), IC1.52 (RX)
CVDD-1: CCVDD-1.2, IC2.45 (CVDD), IC2.52 (RX)
GNDH: CAVDD-1.1, CBAT-1.1, CBH.1, CCOMHNG.1, CCOMHPG.1, CCOMMHN.1, CCOMMHP.2, CCVDD-1.1, CDVDD-1.1, CNEG5V-1.1, CNPN1-1.1, CNPN2-1.1, CREFHP-1.1, CTSREF2.1, ESDCOMH.3, IC2.36 (REFHM), IC2.39 (AVSS), IC2.46 (CVSS), IC2.50 (DVSS), IC2.65 (AVSS?), RCB0-1.1, TEMPH.9, TEMPH.10, TEMPH.11, TEMPH.12, TEMPH.13, TEMPH.14, TEMPH.15, TEMPH.16
GNDL: CAVDD.1, CBAT.1, CBL.1, CCOMLNG.1, CCOMLPG.1, CCOMMLN.2, CCOMMLP.1, CCVDD.1, CDVDD.1, CNEG5V.1, CNPN1.1, CNPN2.1, CREFHP.1, CTSREF1.1, ESDCOML.3, IC1.36 (REFHM), IC1.39 (AVSS), IC1.46 (CVSS), IC1.50 (DVSS), IC1.65 (AVSS?), RCB0.1, TEMPL.9, TEMPL.10, TEMPL.11, TEMPL.12, TEMPL.13, TEMPL.14, TEMPL.15, TEMPL.16
LDOIN: CNPN2.2, IC1.47 (LDOIN), T1.E
LDOIN-1: CNPN2-1.2, IC2.47 (LDOIN), T2.E
unnamed: CCOMHP.2, ESDCOMH.1, RCOMHP.1
unnamed: CCOMHN.2, ESDCOMH.2, RCOMHN.1
unnamed: IC1.64 (BBP(SRP)), SR.1
unnamed: CBL.2, RCB1.1
unnamed: CBL.3, RCB2.1
unnamed: IC1.63 (BBN(SRN)), SR.2
unnamed: CBL.4, RCB3.1
unnamed: CBL.5, RCB4.1
unnamed: CBL.6, RCB5.1
unnamed: CBL.9, RCB8.1
unnamed: CBL.10, RCB9.1
unnamed: CBL.7, RCB6.1
unnamed: CCOMLNG.2, IC1.41 (COMLN), RCOML.1, RCOMLN.2
unnamed: CBL.8, RCB7.1
unnamed: CREFHP.2, IC1.37 (REFHP)
unnamed: CVC0.2, RVC0.1, VCL.1
unnamed: CVC0.1, CVC1.2, RVC1.1, VCL.2
unnamed: CVC1.1, CVC2.2, RVC2.1, VCL.3
unnamed: CVC2.1, CVC3.2, RVC3.1, VCL.4
unnamed: CVC3.1, CVC4.2, RVC4.1, VCL.5
unnamed: CVC4.1, CVC5.2, RVC5.1, VCL.6
unnamed: CVC5.1, CVC6.2, RVC6.1, VCL.7
unnamed: CVC6.1, CVC7.2, RVC7.1, VCL.8
unnamed: CVC7.1, CVC8.2, RVC8.1, VCL.9
unnamed: CVC8.1, CVC9.2, RVC9.1, VCL.10
unnamed: CVC9.1, RVC10.1, VCL.11
unnamed: CAVDD.2, IC1.38 (AVDD)
unnamed: CNEG5V.2, IC1.44 (NEG5V)
unnamed: CCOMLPG.2, IC1.40 (COMLP), RCOML.2, RCOMLP.2
unnamed: CDVDD.2, IC1.49 (DVDD)
unnamed: CCOMMLN.1, IC1.42 (COMHN), RCOMML.2, RCOMMLN.2
unnamed: CCOMMLP.2, IC1.43 (COMHP), RCOMML.1, RCOMMLP.2
unnamed: CCOMMN.2, RCOMMLN.1
unnamed: CCOMMP.2, RCOMMLP.1
unnamed: CNPN1.2, RNPN.1, T1.C
unnamed: CCOMLP.2, ESDCOML.2, RCOMLP.1
unnamed: CCOMLN.2, ESDCOML.1, RCOMLN.1
unnamed: CBH.3, RCB2-1.1
unnamed: CBH.2, RCB1-1.1
unnamed: CBH.4, RCB3-1.1
unnamed: CBH.5, RCB4-1.1
unnamed: CBH.6, RCB5-1.1
unnamed: CBH.7, RCB6-1.1
unnamed: CBH.8, RCB7-1.1
unnamed: CBH.9, RCB8-1.1
unnamed: CBH.10, RCB9-1.1
unnamed: CVC0-1.2, RVC0-1.1, VCH.1
unnamed: CVC0-1.1, CVC1-1.2, RVC1-1.1, VCH.2
unnamed: CVC1-1.1, CVC2-1.2, RVC2-1.1, VCH.3
unnamed: CVC2-1.1, CVC3-1.2, RVC3-1.1, VCH.4
unnamed: CVC3-1.1, CVC4-1.2, RVC4-1.1, VCH.5
unnamed: CVC4-1.1, CVC5-1.2, RVC5-1.1, VCH.6
unnamed: CVC5-1.1, CVC6-1.2, RVC6-1.1, VCH.7
unnamed: CVC6-1.1, CVC7-1.2, RVC7-1.1, VCH.8
unnamed: CVC7-1.1, CVC8-1.2, RVC8-1.1, VCH.9
unnamed: CVC8-1.1, CVC9-1.2, RVC9-1.1, VCH.10
unnamed: CVC9-1.1, RVC10-1.1, VCH.11
unnamed: CREFHP-1.2, IC2.37 (REFHP)
unnamed: CAVDD-1.2, IC2.38 (AVDD)
unnamed: CNEG5V-1.2, IC2.44 (NEG5V)
unnamed: CDVDD-1.2, IC2.49 (DVDD)
unnamed: CCOMMHN.2, IC2.41 (COMLN), RCOMMH.1, RCOMMHN.2
unnamed: CCOMMHP.1, IC2.40 (COMLP), RCOMMH.2, RCOMMHP.2
unnamed: CNPN1-1.2, RNPN-1.1, T2.C
unnamed: CCOMHPG.2, IC2.43 (COMHP), RCOMH.1, RCOMHP.2
unnamed: CCOMHNG.2, IC2.42 (COMHN), RCOMH.2, RCOMHN.2
NPNB: IC1.48 (NPNB), T1.B
NPNB-1: IC2.48 (NPNB), T2.B
TEMP1: IC1.61 (GPIO1), TEMPL.1, TEMPR1.2
TEMP2: IC1.60 (GPIO2), TEMPL.2, TEMPR2.2
TEMP3: IC1.59 (GPIO3), TEMPL.3, TEMPR3.2
TEMP4: IC1.58 (GPIO4), TEMPL.4, TEMPR4.2
TEMP5: IC1.57 (GPIO5), TEMPL.5, TEMPR5.2
TEMP6: IC1.56 (GPIO6), TEMPL.6, TEMPR6.2
TEMP7: IC1.55 (GPIO7), TEMPL.7, TEMPR7.2
TEMP8: IC1.54 (GPIO8), TEMPL.8, TEMPR8.2
TEMP9: IC2.61 (GPIO1), TEMPH.1, TEMPR9.2
TEMP10: IC2.60 (GPIO2), TEMPH.2, TEMPR10.2
TEMP11: IC2.59 (GPIO3), TEMPH.3, TEMPR11.2
TEMP12: IC2.58 (GPIO4), TEMPH.4, TEMPR12.2
TEMP13: IC2.57 (GPIO5), TEMPH.5, TEMPR13.2
TEMP14: IC2.56 (GPIO6), TEMPH.6, TEMPR14.2
TEMP15: IC2.55 (GPIO7), TEMPH.7, TEMPR15.2
TEMP16: IC2.54 (GPIO8), TEMPH.8, TEMPR16.2
TSREF: CTSREF1.2, IC1.51 (TSREF), TEMPR1.1, TEMPR2.1, TEMPR3.1, TEMPR4.1, TEMPR5.1, TEMPR6.1, TEMPR7.1, TEMPR8.1
TSREF-1: CTSREF2.2, IC2.51 (TSREF), TEMPR9.1, TEMPR10.1, TEMPR11.1, TEMPR12.1, TEMPR13.1, TEMPR14.1, TEMPR15.1, TEMPR16.1
VC0: IC1.35 (VC0), RVC0.2
VC0-1: IC2.35 (VC0), RVC0-1.2
VC1: IC1.33 (VC1), RVC1.2
VC1-1: IC2.33 (VC1), RVC1-1.2
VC2: IC1.31 (VC2), RVC2.2
VC2-1: IC2.31 (VC2), RVC2-1.2
VC3: IC1.29 (VC3), RVC3.2
VC3-1: IC2.29 (VC3), RVC3-1.2
VC4: IC1.27 (VC4), RVC4.2
VC4-1: IC2.27 (VC4), RVC4-1.2
VC5: IC1.25 (VC5), RVC5.2
VC5-1: IC2.25 (VC5), RVC5-1.2
VC6: IC1.23 (VC6), RVC6.2
VC6-1: IC2.23 (VC6), RVC6-1.2
VC7: IC1.21 (VC7), RVC7.2
VC7-1: IC2.21 (VC7), RVC7-1.2
VC8: IC1.19 (VC8), RVC8.2
VC8-1: IC2.19 (VC8), RVC8-1.2
VC9: IC1.17 (VC9), RVC9.2
VC9-1: IC2.17 (VC9), RVC9-1.2
VC10: IC1.15 (VC10), RVC10.2
VC10-1: IC2.15 (VC10), RVC10-1.2
VC_CB_HIGH: CBAT.2, IC1.1 (BAT), IC1.2 (CB16), IC1.3 (VC16), IC1.4 (CB15), IC1.5 (VC15), IC1.6 (CB14), IC1.7 (VC14), IC1.8 (CB13), IC1.9 (VC13), IC1.10 (CB12), IC1.11 (VC12), IC1.12 (CB11), IC1.13 (VC11), RBAT.1
VC_CB_HIGH-1: CBAT-1.2, IC2.1 (BAT), IC2.2 (CB16), IC2.3 (VC16), IC2.4 (CB15), IC2.5 (VC15), IC2.6 (CB14), IC2.7 (VC14), IC2.8 (CB13), IC2.9 (VC13), IC2.10 (CB12), IC2.11 (VC12), IC2.12 (CB11), IC2.13 (VC11), RBAT-1.1

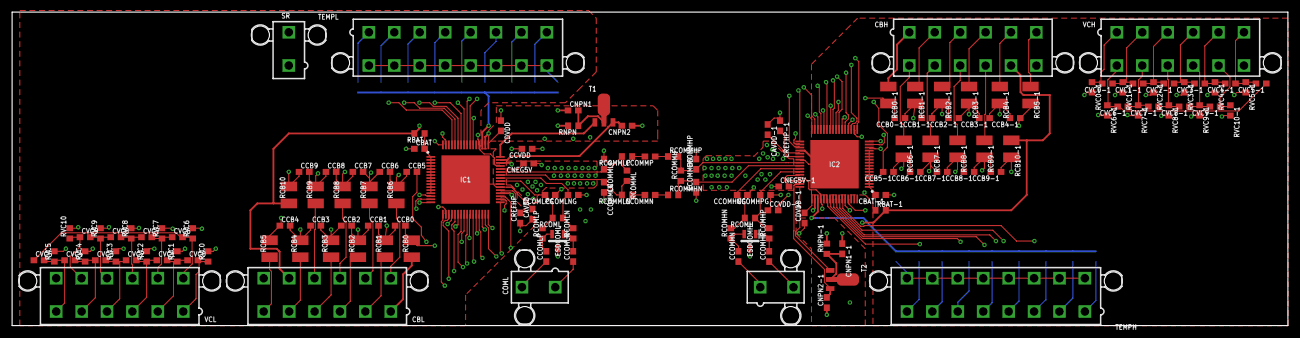
[picture p27: board Hardware/Segment/V0_CAM/daughterboard.brd from above]

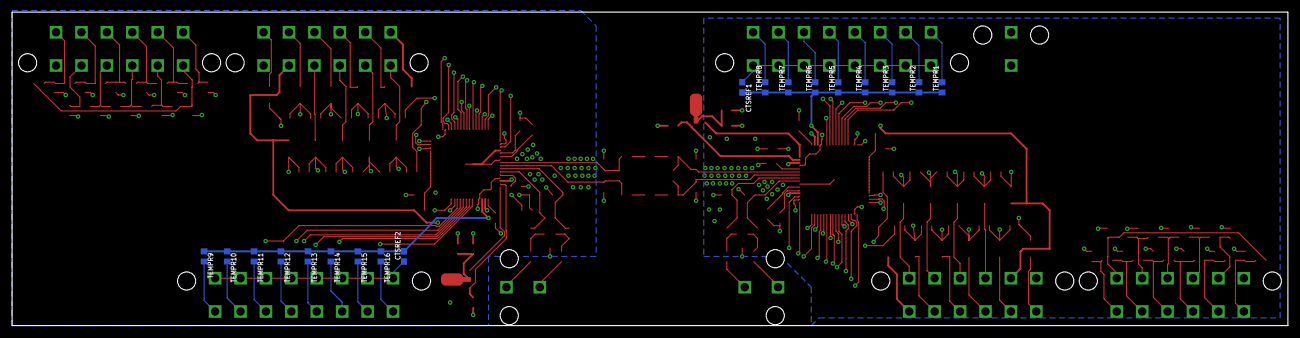
[picture p28: board Hardware/Segment/V0_CAM/daughterboard.brd from below]

Board: 4 copper layers, 210.8 x 51.8 mm, 163 parts (18 on the bottom side), 146 nets.
