NU-Formula-Racing/BMS-Deprecated-2023/Firmware/PlatformIO/main_mcu/src/main_MCU.cpp

#include <Arduino.h>

#include <chrono>

#include "ELCON-Charger.h"
#include "bms.h"
#include "bms_telemetry.h"
#include "bq_comm.h"
#include "teensy_can.h"
#include "thermistor.h"
#include "virtualTimer.h"

#define serialdebug 1

TeensyCAN<1> hp_can{};
TeensyCAN<2> lp_can{};
TeensyCAN<3> vb_can{};

ElconCharger charger{vb_can, 120 * 15, 14};

VirtualTimerGroup timer_group{};

const uint8_t kNumSegmentsConfig = 6;

ShutdownInput shutdown_input{A14, 1.0f / 7.0f, 15.0f, 10.0f};

NXFT15XH103FA2B050 thermistor{};
BMS bms{BQ79656{Serial8, 35, thermistor, 20 * kNumSegmentsConfig, 16 * kNumSegmentsConfig, 2 * kNumSegmentsConfig},
        20 * kNumSegmentsConfig,
        16 * kNumSegmentsConfig,
        charger,
        timer_group,
        hp_can,
        lp_can,
        vb_can,
        shutdown_input};

void setup()
{
#if serialdebug
    delay(2000);
    Serial.begin(9600);
    Serial.println("Starting...");

#endif
    // put your setup code here, to run once:
    bms.Initialize();
    Serial.println("BMS Inited");
    hp_can.Initialize(ICAN::BaudRate::kBaud1M);
    lp_can.Initialize(ICAN::BaudRate::kBaud1M);
    vb_can.Initialize(ICAN::BaudRate::kBaud500K);
    Serial.println("CAN inited");
    charger.Initialize();
    timer_group.AddTimer(100, []() { bms.Tick(); });
    // delay(1000);
}

void loop() { timer_group.Tick(millis()); }
