NU-Formula-Racing/BMS-Deprecated-2023/Luc's ESP32 Code/Refresh_Page/Refresh_Page.ino

/*
 * ESP32 AJAX Demo
 * Updates and Gets data from webpage without page refresh
 * https://circuits4you.com
 */
#define LIGHT_SENSOR_PIN 36 // ESP32 pin GIOP36 (ADC0) 
#include <WiFi.h>
#include <WiFiClient.h>
#include <WebServer.h>

#include "index.h"  //Web page header file

WebServer server(80);

//Enter your SSID and PASSWORD
const char* ssid = "Test Web Server";
const char* password = "123456789";

//===============================================================
// This routine is executed when you open its IP in browser
//===============================================================
void handleRoot() {
 String s = MAIN_page; //Read HTML contents
 server.send(200, "text/html", s); //Send web page
}
 
void handleADC() {
 int a = analogRead(LIGHT_SENSOR_PIN);
 String adcValue = String(a);
 
 server.send(200, "text/plane", adcValue); //Send ADC value only to client ajax request
}

//===============================================================
// Setup
//===============================================================

void setup(void){
  Serial.begin(115200);
  Serial.println();
  Serial.println("Booting Sketch...");

/*
//ESP32 As access point
  WiFi.mode(WIFI_AP); //Access Point mode
  WiFi.softAP(ssid, password);
*/
//ESP32 connects to your wifi -----------------------------------
  Serial.print("Setting AP (Access Point)…");
  // Remove the password parameter, if you want the AP (Access Point) to be open
  WiFi.softAP(ssid, password);

  IPAddress IP = WiFi.softAPIP();
  Serial.print("AP IP address: ");
  Serial.println(IP);
  
//----------------------------------------------------------------
 
  server.on("/", handleRoot);      //This is display page
  server.on("/readADC", handleADC);//To get update of ADC Value only
 
  server.begin();                  //Start server
  Serial.println("HTTP server started");
}

//===============================================================
// This routine is executed when you open its IP in browser
//===============================================================
void loop(void){
  server.handleClient();
  delay(1);
}
