NU-Formula-Racing/BMS-Deprecated-2023/Firmware/PlatformIO/main_mcu/src/cellinfo.h

#pragma once
#include <map>

class CellInfo
{
public:
    virtual float VoltageToSOC(float voltage) = 0;
};

class INR21700P42A : public CellInfo
{
public:
    float VoltageToSOC(float voltage) override { return Interpolate(voltages_to_SOC_lut_, voltage); }

private:
    // consts from datasheet
    std::map<float, float> voltages_to_SOC_lut_{{4.186, 1},
                                                {4.177, 0.997619047619048},
                                                {4.168, 0.995238095238095},
                                                {4.159, 0.992857142857143},
                                                {4.149, 0.990476190476191},
                                                {4.142, 0.988095238095238},
                                                {4.136, 0.985714285714286},
                                                {4.131, 0.983333333333334},
                                                {4.126, 0.980952380952381},
                                                {4.121, 0.978571428571429},
                                                {4.116, 0.976190476190477},
                                                {4.113, 0.973809523809524},
                                                {4.109, 0.971428571428572},
                                                {4.106, 0.96904761904762},
                                                {4.103, 0.966666666666667},
                                                {4.099, 0.964285714285715},
                                                {4.097, 0.961904761904763},
                                                {4.095, 0.95952380952381},
                                                {4.094, 0.957142857142858},
                                                {4.092, 0.954761904761906},
                                                {4.09, 0.952380952380954},
                                                {4.088, 0.950000000000001},
                                                {4.087, 0.947619047619049},
                                                {4.085, 0.945238095238096},
                                                {4.083, 0.942857142857144},
                                                {4.082, 0.940476190476192},
                                                {4.08, 0.938095238095239},
                                                {4.079, 0.935714285714287},
                                                {4.077, 0.933333333333335},
                                                {4.075, 0.930952380952382},
                                                {4.074, 0.92857142857143},
                                                {4.072, 0.926190476190478},
                                                {4.071, 0.923809523809525},
                                                {4.069, 0.921428571428573},
                                                {4.068, 0.919047619047621},
                                                {4.066, 0.916666666666668},
                                                {4.064, 0.914285714285716},
                                                {4.063, 0.911904761904764},
                                                {4.061, 0.909523809523812},
                                                {4.06, 0.907142857142859},
                                                {4.059, 0.904761904761907},
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

    float Interpolate(const std::map<float, float>& map, float x)
    {
        typedef std::map<float, float>::const_iterator iterator;
        iterator ub = map.upper_bound(x);
        if (ub == map.end())
        {
            return (--ub)->second;
        }
        if (ub == map.begin())
        {
            return ub->second;
        }
        iterator lb = ub;
        lb--;
        const float delta = (x - lb->first) / (ub->first - lb->first);
        return delta * ub->second + (1 - delta) * lb->second;
    }
};
