NU-Formula-Racing/BMS-Deprecated-2023/Firmware/PlatformIO/main_mcu/src/teensy_pin_defs.h

#define rx_esp 0
#define tx_esp 1
#define can_rx 30
#define can_tx 31
#define cs_esp 39  // cs1
#define miso_esp 41
#define mosi_esp 26
#define sck_esp 27
#define coolant_ctrl 11
#define contactorprecharge_ctrl 20
#define contactorp_ctrl 21
#define contactorn_ctrl 10

#define charger_sense 14
// const int kill_pins[]{14, 15, 18, 19, 24, 25, 40, 32, 9, 6, 2, 33};
// #define num_kill_pins 12
