NU-Formula-Racing/BMS-Deprecated-2023/(commit log)

2021-10-23 Arduino library and fixed lbr
    [main_MCU.ino]
2021-10-28 Modified register definitions with current measuring details from TI
2021-10-31 added a resistor
    [daughterboard.sch]
2021-10-31 teensy and esp32 eagle files
2021-11-07 Connected IC to 10 battery cells
    [daughterboard.sch]
2021-11-08 Replaced batteries with Molex Mini Fit connectors, added values to components, connected unused pins to BAT
    [daughterboard.sch]
2021-11-08 Added units and more components from Figure 10-1
    [daughterboard.sch]
2021-11-09 Added connections to thermistors
    [daughterboard.sch]
2021-11-10 Part of com
    [daughterboard.sch]
2021-11-11 11/10/2021 update of esp schematic
    [asdf.brd, asdf.sch, esp_teensy_bridge.sch, practice.brd, practice.sch, untitled.sch]
2021-11-13 Added TVS diode library
2021-11-13 added COMLP and COMLN connection
    [daughterboard.sch]
2021-11-16 Finished daughterboard schematic?
    [daughterboard.sch]
2021-11-16 Fixed second chip, replaced caps with 0603
    [daughterboard_2sheetbackup.sch]
2021-11-17 Started daughterboard PCB design
    [daughterboard.brd, daughterboard.sch]
2021-11-18 Daughterboard PCB arranging work
    [daughterboard.brd, daughterboard.sch]
2021-11-18 finished main board
    [esp_teensy_bridge.sch]
2021-11-21 created main board pcb
    [esp_teensy_bridge.brd]
2021-11-21 edits to board
    [esp_teensy_bridge.brd]
2021-11-21 Worked on daughterboard PCB
    [daughterboard.brd]
2021-11-22 Worked on daughterboard CB/VC L
    [daughterboard.brd, daughterboard.sch]
2021-11-22 Layout L
    [daughterboard.brd]
2021-11-22 Daughterboard layout
    [daughterboard.brd, daughterboard.sch, daughterboard_2sheetbackup.sch]
2021-11-22 Worked on routing daughterboard, mostly finished COM
    [daughterboard.brd, daughterboard.sch]
2021-11-22 Connected chip 1 (no ground pours yet)
    [daughterboard.brd]
2021-11-30 Added com isolation to main board
    [daughterboard.brd, daughterboard.sch, esp_teensy_bridge.brd, esp_teensy_bridge.sch]
2021-12-01 layout changes to main
    [esp_teensy_bridge.brd, esp_teensy_bridge.sch]
2021-12-01 component edit
    [esp_teensy_bridge.sch]
2021-12-02 fixed some inconsistencies
    [esp_teensy_bridge.brd, esp_teensy_bridge.sch]
2021-12-02 recreated pcb
    [esp_teensy_bridge.brd]
2021-12-02 have fun with eagle
    [esp_teensy_bridge.brd, esp_teensy_bridge.sch]
2021-12-02 placed some wires
    [esp_teensy_bridge.brd]
2021-12-02 changed the Teensy chip
    [esp_teensy_bridge.sch]
2021-12-30 Ground planes on segment
    [daughterboard.brd, daughterboard.sch]
2021-12-30 Board and schematic are consistent, mostly wired, some problems
    [daughterboard.brd, daughterboard.sch]
2021-12-31 Almost done with daughter board
    [daughterboard.brd]
2022-01-02 No more airwires!
    [daughterboard.brd]
2022-01-03 DRC, ERC pass
    [daughterboard.brd, daughterboard.sch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]
2022-01-03 Label daughterboard
    [daughterboard.brd]
2022-01-03 Re-ran V1 CAM
    [copper_bottom_l4.gbr, copper_inner_l2.gbr, copper_inner_l3.gbr, copper_top_l1.gbr, gerber_job.gbrjob, profile.gbr, silkscreen_bottom.gbr, silkscreen_top.gbr]
2022-01-06 Labeled a couple things in segment schematic
    [daughterboard.sch]
2022-01-13 change from uart to spi
    [esp_teensy_bridge.brd, esp_teensy_bridge.sch]
2022-01-15 Dummy battery and daughterboard v1.1
    [QFP50P1200X1200X120-64N_JEDEC_MS-026ACD.STEP, daughterboard.brd, daughterboard.sch, daughterboard_bom.csv, dummy_battery.brd, dummy_battery.sch]
2022-01-15 connected some stuff
    [esp_teensy_bridge.brd]
2022-01-15 Rotated connector to shrink board
    [daughterboard.brd, daughterboard.sch, daughterboard_v2.brd]
2022-01-15 Mainboard routing
    [daughterboard.brd, esp_teensy_bridge.brd, esp_teensy_bridge.sch]
2022-01-18 All components on top of daughterboard
    [daughterboard.brd, daughterboard.csv, daughterboard.sch]
2022-01-19 design review changes
    [esp_teensy_bridge.brd, esp_teensy_bridge.sch]
2022-01-20 seperate spi
    [esp_teensy_bridge.brd, esp_teensy_bridge.sch]
2022-01-20 1/19/2022 changes josh/isaac
    [esp_teensy_bridge.brd]
2022-01-20 final additions hopefully
    [esp_teensy_bridge.brd, esp_teensy_bridge.sch]
2022-01-20 Fixed MOSFETs
    [dummy_battery.brd, esp_teensy_bridge.brd, esp_teensy_bridge.sch]
2022-01-20 BOMs and CAM
    [dummy_battery.brd, dummy_battery.csv, esp_teensy_bridge.brd, esp_teensy_bridge.csv]
2022-01-22 Fixed LED issue
    [esp_teensy_bridge.brd, esp_teensy_bridge.sch]
2022-01-29 Work on main_mcu
    [daughterboard.brd]
2022-01-29 web server code ESP32
2022-02-17 Added test code (not working yet) for BQ79600
    [BQ79600_test.ino, main_MCU.ino, teensy_pin_defs.h]
2022-02-20 Fixed LED VCC and resistors, coolant is now PWM, CAN transceiver added, removed unnecessary resistor
    [esp_teensy_bridge.brd, esp_teensy_bridge.sch]
2022-02-20 I can talk to the board!
2022-02-22 Work on BQ library, RC fix for SR
    [daughterboard.brd, daughterboard.sch, esp_teensy_bridge.brd, esp_teensy_bridge.sch]
2022-02-24 ESP32-devkitc-32D instead ov DEVKIT V1
    [daughterboard.brd, daughterboard.sch, esp_teensy_bridge.brd, esp_teensy_bridge.sch]
2022-03-03 tactile switch
    [esp_teensy_bridge.brd, esp_teensy_bridge.sch]
2022-03-08 fix holes
    [daughterboard.brd]
2022-03-08 Revert "fix holes"
    This reverts commit f4b1f81d6a6675708ffa55f399a4aff91d83dd67.
    [daughterboard.brd]
2022-03-08 Code and fix holes
    [daughterboard.brd]
2022-04-14 Fixed resistors in layout, moved connectors from edge
    [daughterboard.brd, daughterboard.sch]
2022-04-14 LDOIN test pad
    [daughterboard.brd]
2022-05-09 Schematic progress for mainboard
    [asdf.brd, asdf.sch, daughterboard.brd, daughterboard.sch, esp_teensy_bridge.brd, esp_teensy_bridge.csv, esp_teensy_bridge.sch, practice.brd]
2022-05-10 level shiffft
    [esp_teensy_bridge.brd, esp_teensy_bridge.sch]
2022-05-14 Late night mainboard layout
    [esp_teensy_bridge.brd, esp_teensy_bridge.sch]
2022-05-15 Final? V2.0 commit of daughterboard
    [daughterboard.brd]
2022-05-17 dc dc buck converter replace
    [esp_teensy_bridge.brd, esp_teensy_bridge.sch]
2022-05-17 buck converter layout
    [esp_teensy_bridge.brd, esp_teensy_bridge.sch]
2022-05-17 Daughterboard fixes V2.1
    [daughterboard.brd, daughterboard.sch]
2022-05-25 Mainboard fixes
    [esp_teensy_bridge.brd, esp_teensy_bridge.sch]
2022-06-29 PlatformIO UART test code
2022-09-27 Feature/state machine (#85)
    * Removed submodule
    * Made BMS class, implemented preliminary state machine
    * Cleanup
    * Added pragma once to bms.h
    * Added link to state machine flow chart to README
2023-01-02 Reads voltages from one segment in test (#87)
    * Updated to use library accepting vectors instead of array pointers
    * Fetched updated submodule branch name
    * Successfully prints cell voltages for one segment
2023-01-05 Thermistor things
2023-01-05 Added two-color LEDs to BMS daughterboard to indicate balancing current status and direction (#88)
    [daughterboard.brd, daughterboard.sch]
2023-01-08 BMS V3 hardware
    [daughterboard.brd, daughterboard.sch, esp_teensy_bridge.brd, esp_teensy_bridge.sch]
2023-01-10 V3 done
    [daughterboard.brd, esp_teensy_bridge.brd]
2023-01-22 add thermistor to BMS creation so that project can build (#91)
    * add thermistor to BMS creation so that project can build
    * Delete bms_telemetry.cpp
    * Delete bms_telemetry.h
2023-01-28 Possibly functional SoE calculation (that definitely should be review… (#89)
    * Possibly functional SoE calculation (that definitely should be reviewed tho)
    * fix dum speelig errror
    * Revise undervoltage value
    * move minVoltage calculation to process state
    * added PR review suggestions
    * limit power output to 80 kW
    * fixed max power check in CalculateSOE
    ---------
    [bms.cpp, bms.h]
2023-02-11 Tested and working with mainboard V3 and Daughterboard V1.1, stack size 1, to read voltages and current
2023-02-22 Added Fault Checking (#86)
    * Added two-color LEDs to BMS daughterboard to indicate balancing current status and direction
    * set up fault checking
    * specify BMSFault underlying type
    * Minor style changes
    * Set threshhold values
    * NFR Annealer
    * Updated fault reporting when serialdebug
    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
2023-03-02 Feature/bms telemetry (#93)
    * can bus initialization
    * initialize CAN buses
    * initializes voltage/temperature signals and messages
    * Instantiated telemetry in BMS
    * pass references to voltages and currents for CAN signals
    * updated variable names when initiating BMS Telemetry
    * added some current CAN messages
    * Mostly completed BMS telemetry
    Todo:
    - Fault Summary Signal
    - Status BMS State Signal
    - Status SOC Signal
    - How to reference BMS enum classes in BMS telemetry when BMS uses BMS telemetry
    - CAN signals w/ BMS enum class types
    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
2023-03-09 State logic (#96)
    * added conditions of changing state to charging and active
    * changes to state transitions before faultcheck was implemented; wip
    * Annealer with captive portal
    * Tested and working with mainboard V3 and Daughterboard V1.1, stack size 1, to read voltages and current
    * Added Fault Checking (#86)
    * trying to implement gwpch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
2023-06-13 Mainboard update (#101)
    * Switched to eGaN FETs
    * Switched to single connector for mainboard, generated gerbers
    * Labelled HV/LV on mainboard
    * Updates from feedback
    * Changes, gerbers
    [esp_teensy_bridge.brd, esp_teensy_bridge.sch]
2023-06-13 Current code with added charger functionality
2023-06-14 Added shutdown circuit sensing
2023-06-14 Removed digitalread of charger pin
2023-06-14 Feature/state of charge (#97)
    * added getsoc()
    * figuring out problems, if statement mainly
    * fixing mistakes, adding current_time difference
    * shoud be okay, added elapsed time
    * Always count coulombs
    * Tested, seems to be working soc
    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
    [bms.cpp, bms.h, bms_telemetry.cpp, cellinfo.h, coulomb_counting.h]
2023-06-14 Feature/open wire check (#100)
    * added
    * added open wire check to bms
    * OWC passes
    * OWC working, changed external kill fault, fixed external kill fault
    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
    [bms.cpp, bms.h, bms_interface.h, bms_telemetry.cpp, bms_telemetry.h]
2023-06-23 Feature/elcon (#99)
    * chargers
    * adding elcon
    * high current charging, updates from comp
    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
    [bms.cpp, bms.h, coulomb_couting.h, main_MCU.cpp]
