NU-Formula-Racing/BMS-Deprecated-2023/(notices)

Notices in the files:
parts and their libraries:
NFR23_v1.1: COPYRIGHT: Copyright (C) 2022 Ultra Librarian. All rights reserved.
dcdc_5v: COPYRIGHT: Copyright (C) 2023 Ultra Librarian. All rights reserved.
op_amp: COPYRIGHT: Copyright (C) 2018 Accelerated Designs. All rights reserved
